Aarav-Jindal/VTVL-TVC/CAD/plumbing/Tube_Eth_Main.SLDPRT

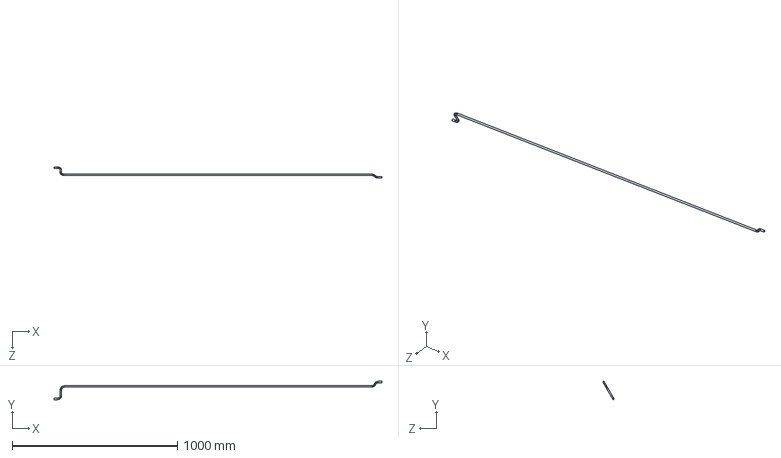
[picture p11: CAD file, 2026-11-12]
CAD/plumbing/Tube_Eth_Main.SLDPRT
1987.0 x 112.6 x 69.0 mm
