Aarav-Jindal/VTVL-TVC/CAD/avionics/Dome.SLDPRT

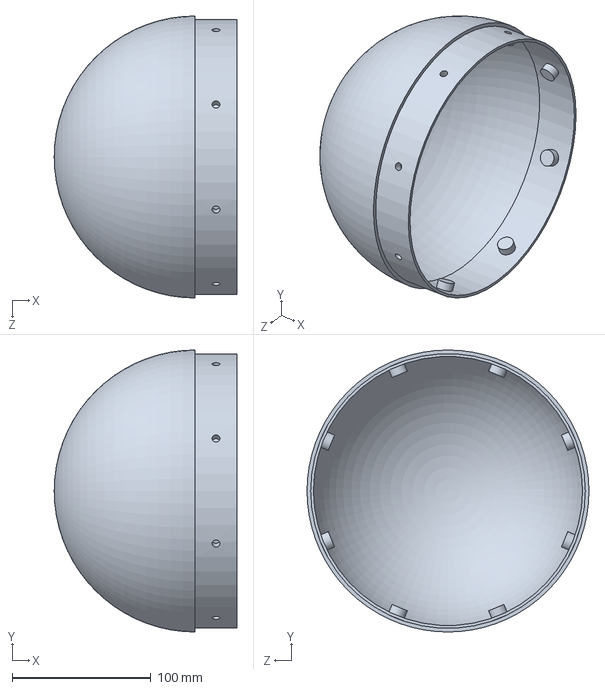
[picture p12: CAD file, 2026-11-12]
CAD/avionics/Dome.SLDPRT
131.6 x 203.3 x 203.3 mm
