Aarav-Jindal/VTVL-TVC/CAD/Injector_Body.SLDPRT

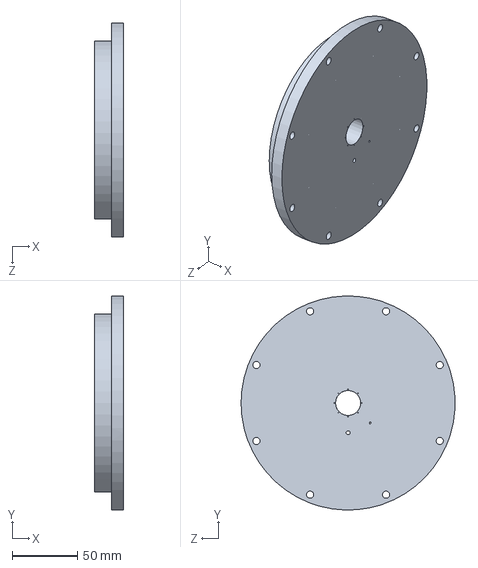
[picture p13: CAD file, 2026-11-12]
CAD/Injector_Body.SLDPRT
22.0 x 163.9 x 163.9 mm
