Aarav-Jindal/VTVL-TVC/CAD/legs/Leg_Foot.SLDPRT

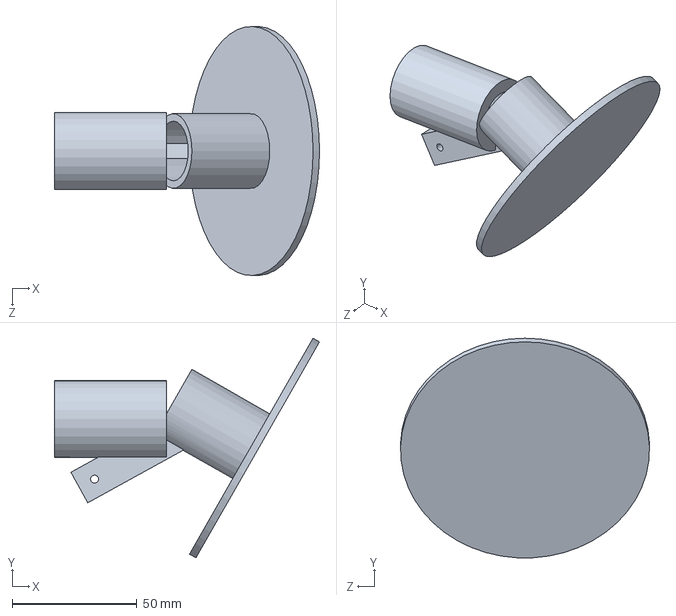
[picture p14: CAD file, 2026-11-12]
CAD/legs/Leg_Foot.SLDPRT
106.4 x 88.2 x 99.9 mm
