Aarav-Jindal/VTVL-TVC/CAD/plumbing/He_Adapter_Upper.SLDPRT

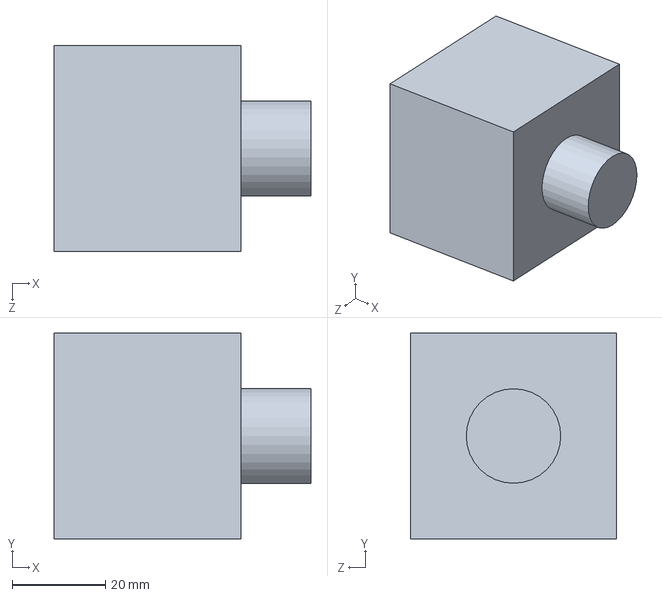
[picture p16: CAD file, 2026-11-12]
CAD/plumbing/He_Adapter_Upper.SLDPRT
55.0 x 44.0 x 44.0 mm
