Aarav-Jindal/VTVL-TVC/CAD/throttle/Servo_Throttle.SLDPRT

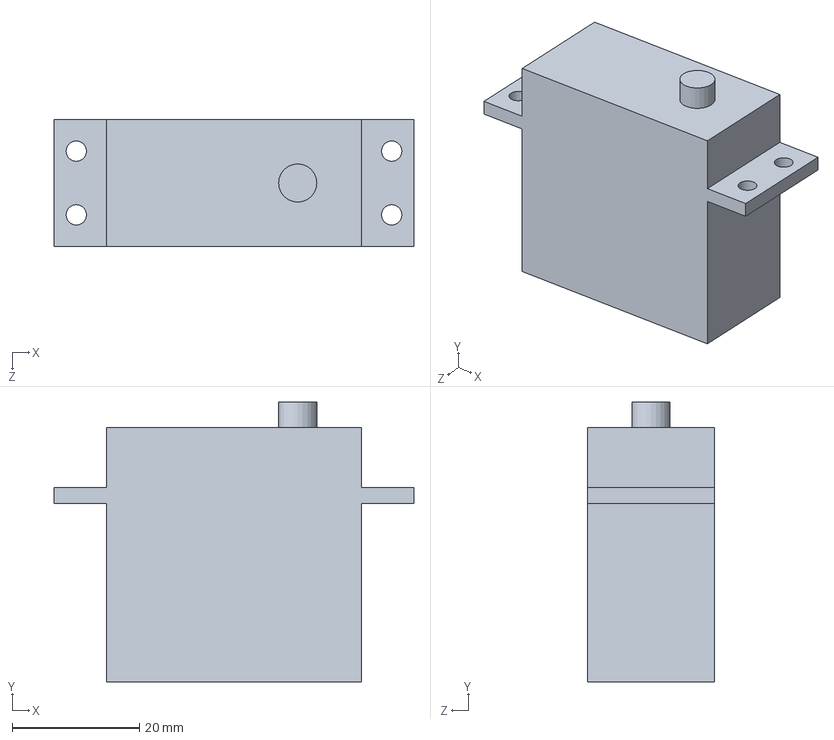
[picture p17: CAD file, 2026-11-12]
CAD/throttle/Servo_Throttle.SLDPRT
56.5 x 43.9 x 20.0 mm
