Aarav-Jindal/VTVL-TVC/CAD/torch/Tube_Torch_Eth.SLDPRT

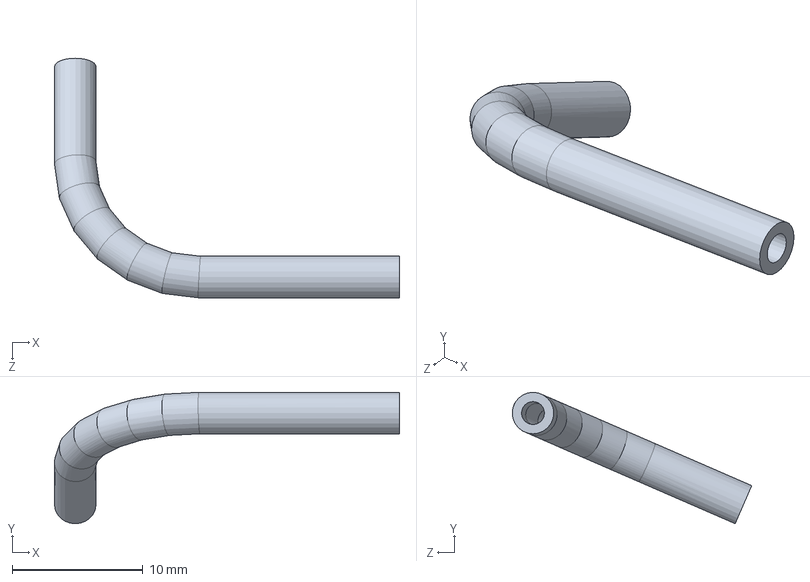
[picture p18: CAD file, 2026-11-12]
CAD/torch/Tube_Torch_Eth.SLDPRT
26.4 x 10.0 x 18.3 mm
