Aarav-Jindal/VTVL-TVC/CAD/Chamber_Printed.SLDPRT

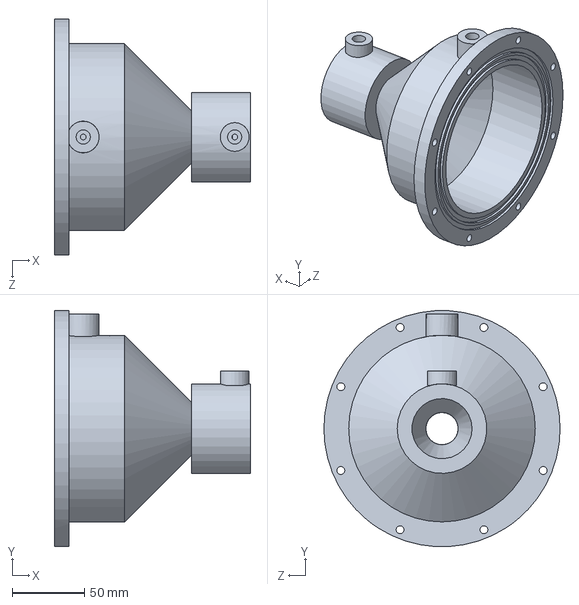
[picture p19: CAD file, 2026-11-12]
CAD/Chamber_Printed.SLDPRT
136.1 x 163.8 x 164.0 mm
