Aarav-Jindal/VTVL-TVC/CAD/legs/Leg_Switch.SLDPRT

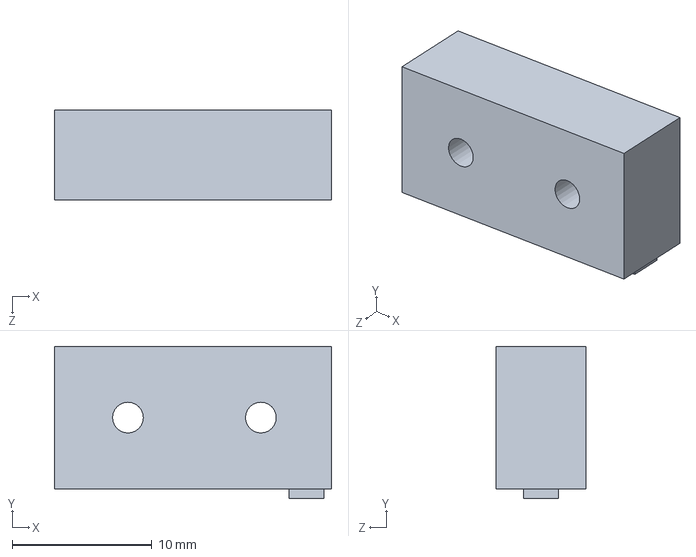
[picture p20: CAD file, 2026-11-12]
CAD/legs/Leg_Switch.SLDPRT
19.8 x 10.9 x 6.40 mm
