Aarav-Jindal/VTVL-TVC/CAD/mounts/Line_Block_T6.SLDPRT

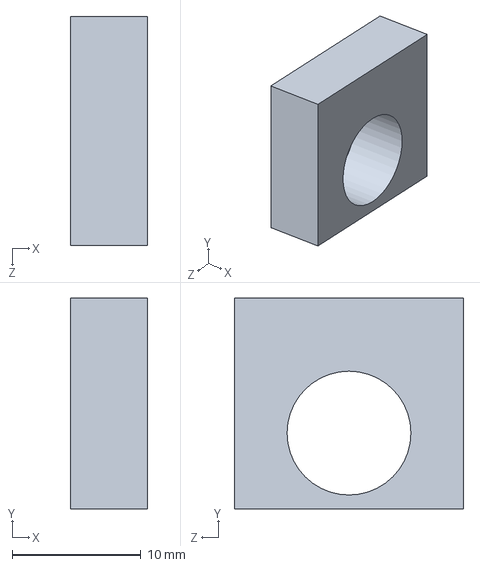
[picture p21: CAD file, 2026-11-12]
CAD/mounts/Line_Block_T6.SLDPRT
6.00 x 16.4 x 17.8 mm
