Aarav-Jindal/VTVL-TVC/CAD/plumbing/Conn_T8_ORB6.SLDPRT

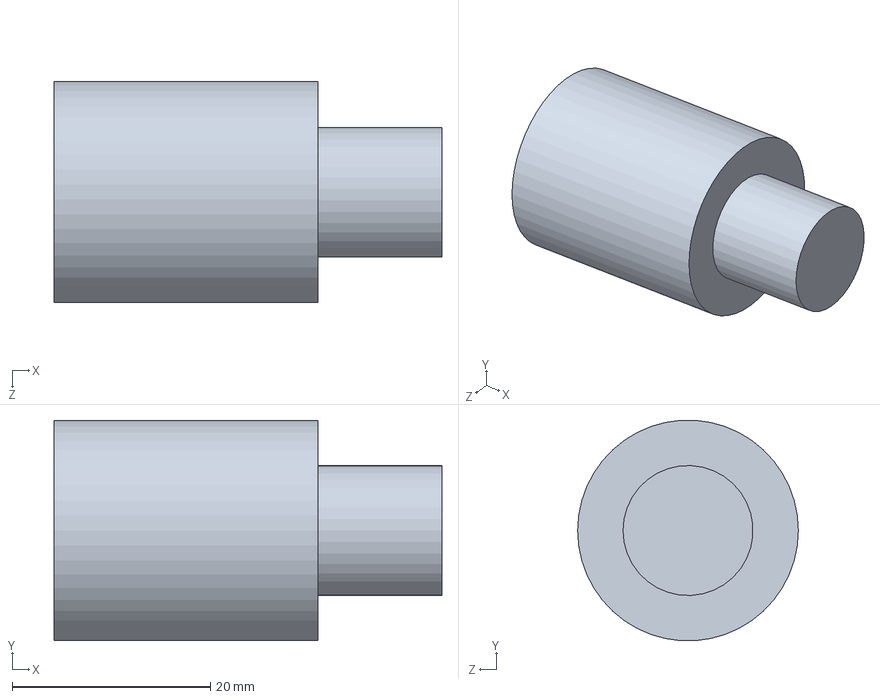
[picture p22: CAD file, 2026-11-12]
CAD/plumbing/Conn_T8_ORB6.SLDPRT
39.1 x 22.2 x 22.2 mm
