Aarav-Jindal/VTVL-TVC/CAD/throttle/Throttle_Gear_Servo.SLDPRT

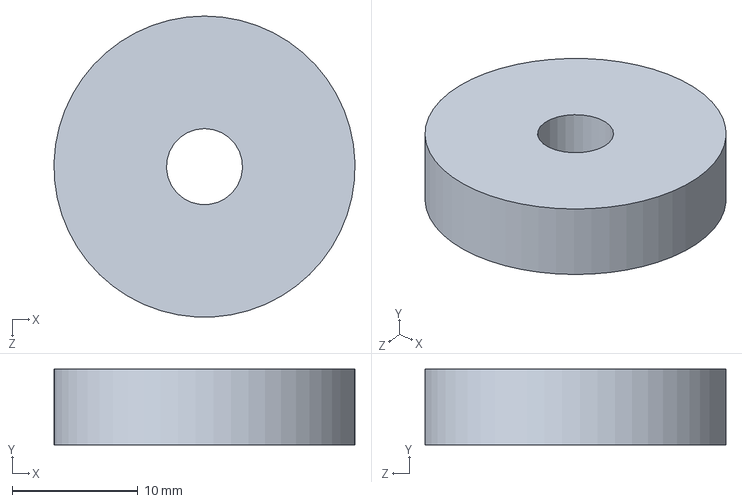
[picture p23: CAD file, 2026-11-12]
CAD/throttle/Throttle_Gear_Servo.SLDPRT
23.9 x 6.00 x 23.9 mm
