Aarav-Jindal/VTVL-TVC/CAD/torch/Torch_Plug.SLDPRT

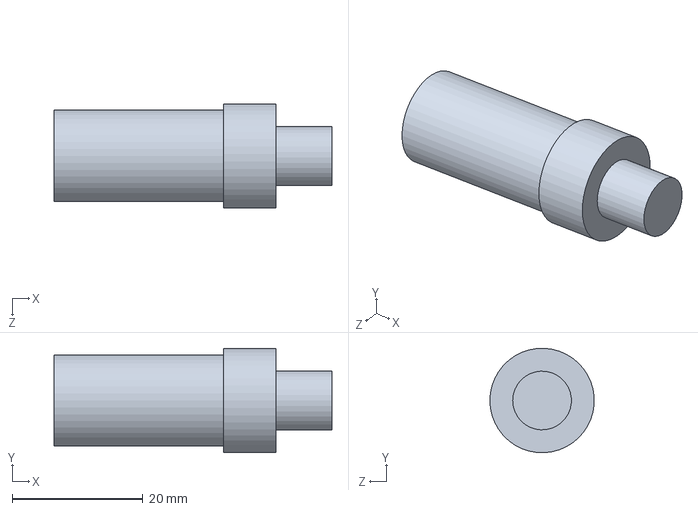
[picture p24: CAD file, 2026-11-12]
CAD/torch/Torch_Plug.SLDPRT
42.6 x 16.0 x 16.0 mm
