Aarav-Jindal/VTVL-TVC/CAD/avionics/Grommet_IMU.SLDPRT

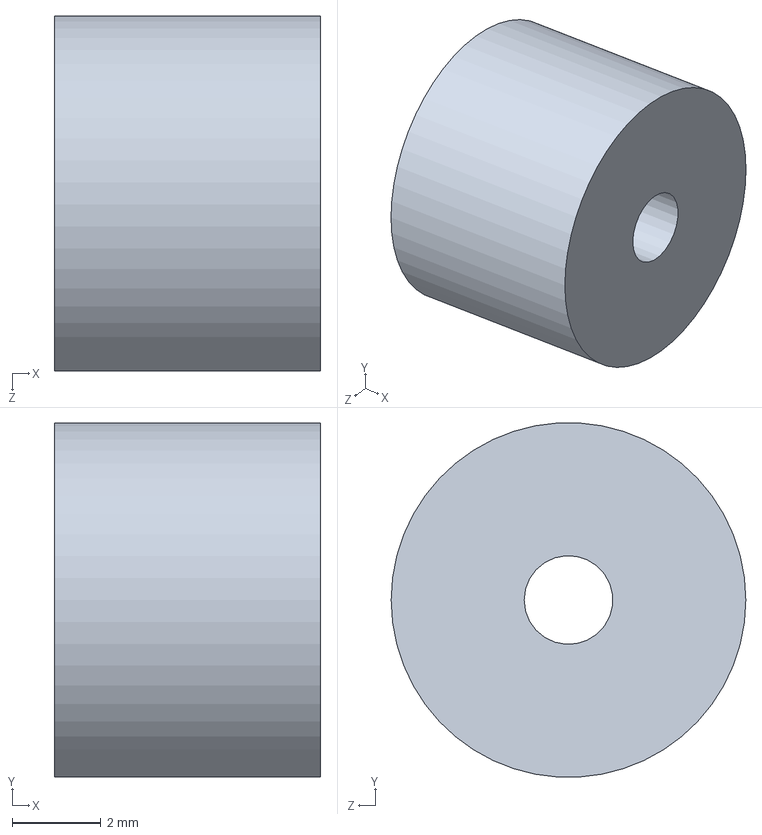
[picture p25: CAD file, 2026-11-12]
CAD/avionics/Grommet_IMU.SLDPRT
6.00 x 7.98 x 8.00 mm
