Aarav-Jindal/VTVL-TVC/CAD/Gimbal_Servo_Bracket.SLDPRT

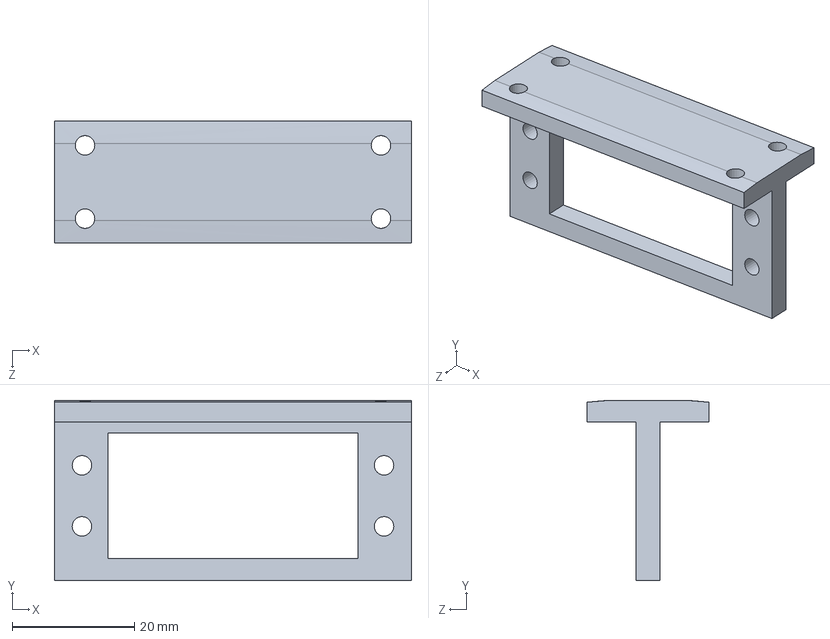
[picture p26: CAD file, 2026-11-12]
CAD/Gimbal_Servo_Bracket.SLDPRT
58.5 x 29.6 x 20.0 mm
