Aarav-Jindal/VTVL-TVC/CAD/hardware/Pushrod.SLDPRT

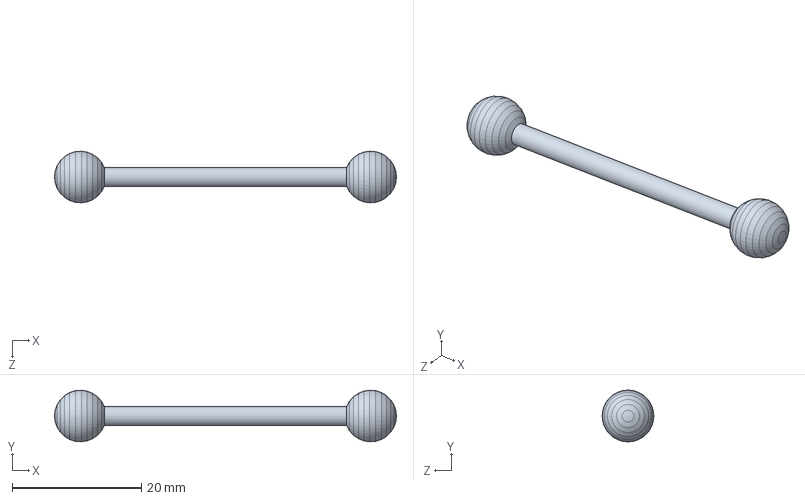
[picture p27: CAD file, 2026-11-12]
CAD/hardware/Pushrod.SLDPRT
53.0 x 7.99 x 7.99 mm
