Aarav-Jindal/VTVL-TVC/CAD/legs/Leg_Spring.SLDPRT

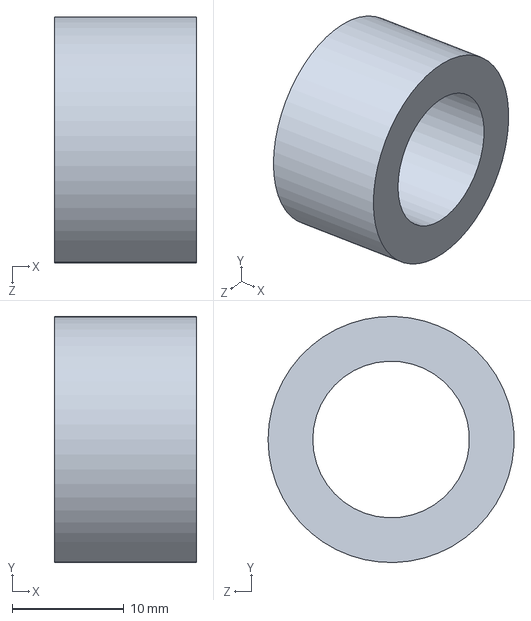
[picture p28: CAD file, 2026-11-12]
CAD/legs/Leg_Spring.SLDPRT
12.7 x 22.0 x 22.0 mm
