Aarav-Jindal/VTVL-TVC/CAD/mounts/Bottle_Liner_Seat.SLDPRT

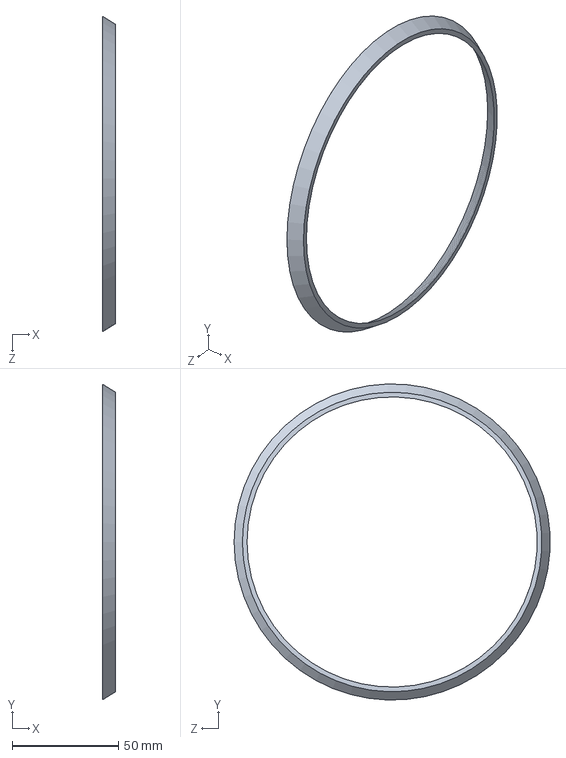
[picture p29: CAD file, 2026-11-12]
CAD/mounts/Bottle_Liner_Seat.SLDPRT
6.35 x 148.8 x 148.8 mm
