Aarav-Jindal/VTVL-TVC/CAD/plumbing/Hose_End_10.SLDPRT

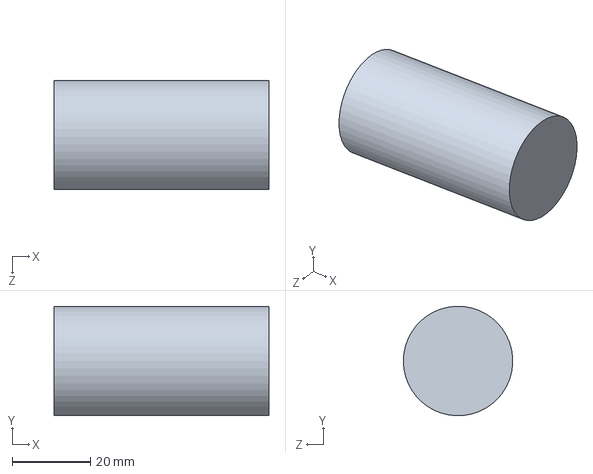
[picture p30: CAD file, 2026-11-12]
CAD/plumbing/Hose_End_10.SLDPRT
55.0 x 28.0 x 28.0 mm
