Aarav-Jindal/VTVL-TVC/CAD/throttle/Throttle_Bracket.SLDPRT

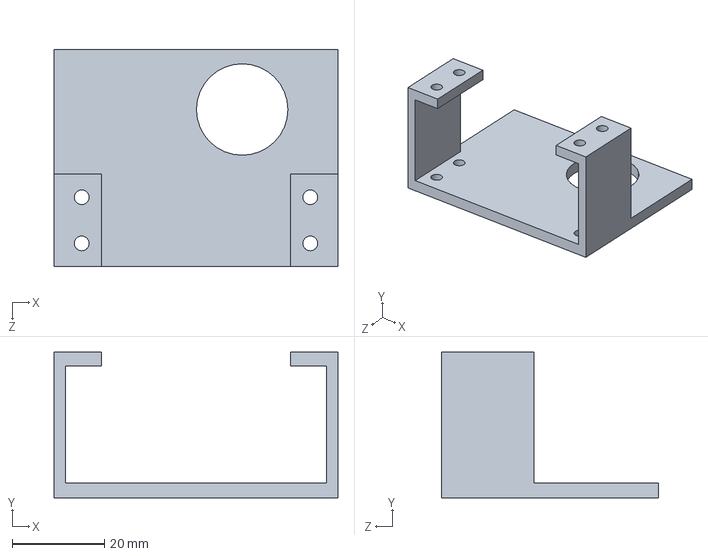
[picture p31: CAD file, 2026-11-12]
CAD/throttle/Throttle_Bracket.SLDPRT
61.5 x 31.6 x 47.0 mm
