Aarav-Jindal/VTVL-TVC/CAD/torch/Tube_Torch_N2O.SLDPRT

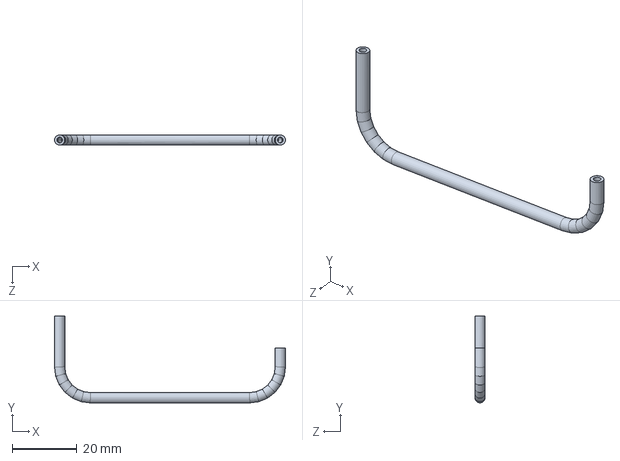
[picture p32: CAD file, 2026-11-12]
CAD/torch/Tube_Torch_N2O.SLDPRT
71.3 x 26.8 x 3.17 mm
