Aarav-Jindal/VTVL-TVC/CAD/avionics/Standoff_M3x60.SLDPRT

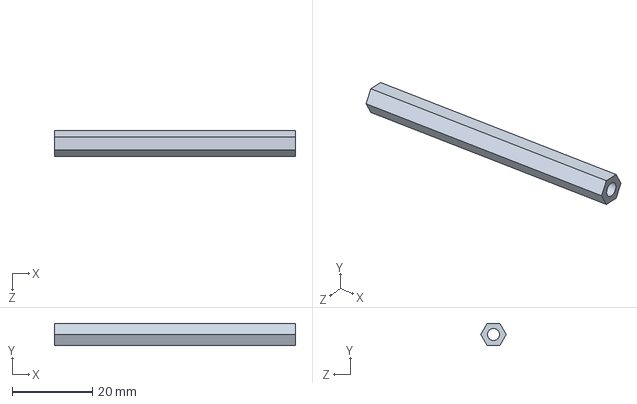
[picture p33: CAD file, 2026-11-12]
CAD/avionics/Standoff_M3x60.SLDPRT
60.0 x 5.50 x 6.35 mm
