Aarav-Jindal/VTVL-TVC/CAD/Gimbal_Ring.SLDPRT

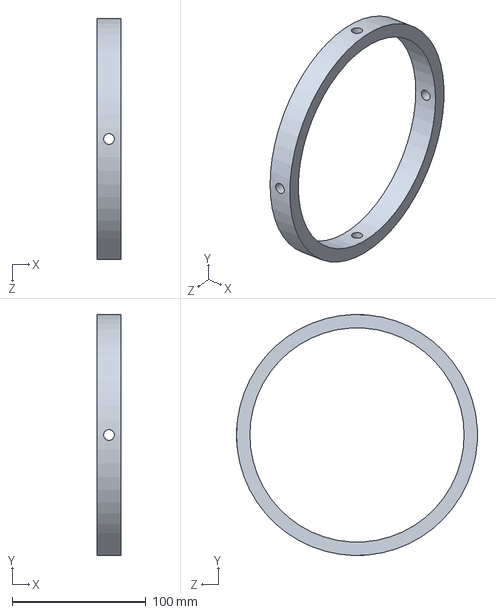
[picture p34: CAD file, 2026-11-12]
CAD/Gimbal_Ring.SLDPRT
18.0 x 180.0 x 180.0 mm
