Aarav-Jindal/VTVL-TVC/CAD/hardware/O_Ring_Outer.SLDPRT

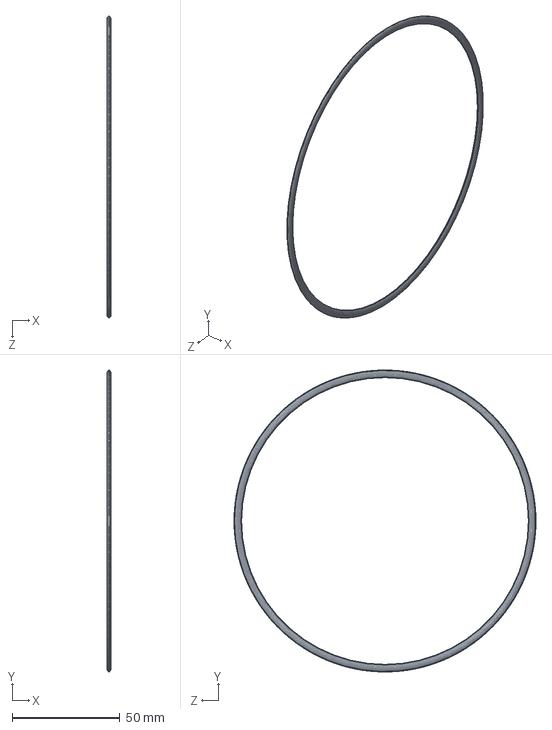
[picture p35: CAD file, 2026-11-12]
CAD/hardware/O_Ring_Outer.SLDPRT
1.95 x 140.0 x 140.1 mm
