Aarav-Jindal/VTVL-TVC/CAD/legs/Leg_Hinge_Bracket.SLDPRT

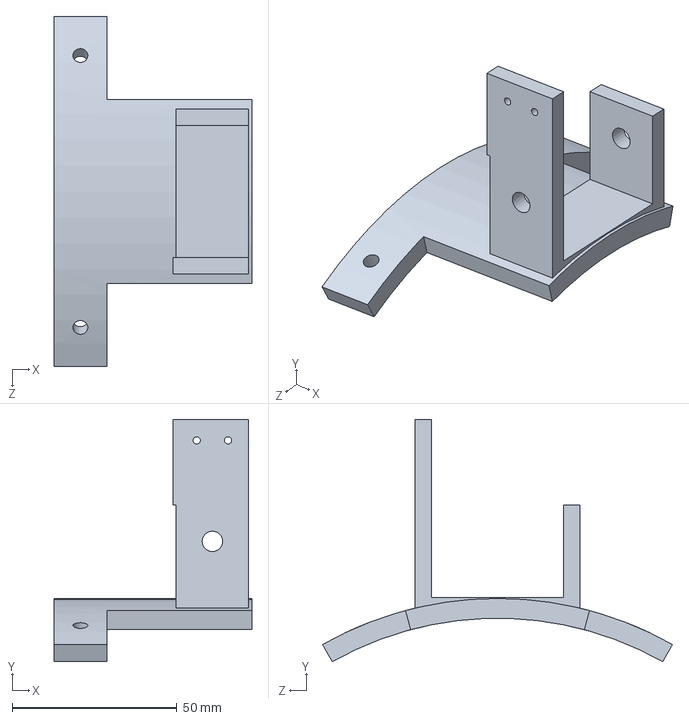
[picture p36: CAD file, 2026-11-12]
CAD/legs/Leg_Hinge_Bracket.SLDPRT
60.0 x 73.5 x 106.1 mm
