Aarav-Jindal/VTVL-TVC/CAD/mounts/Bottle_Ring.SLDPRT

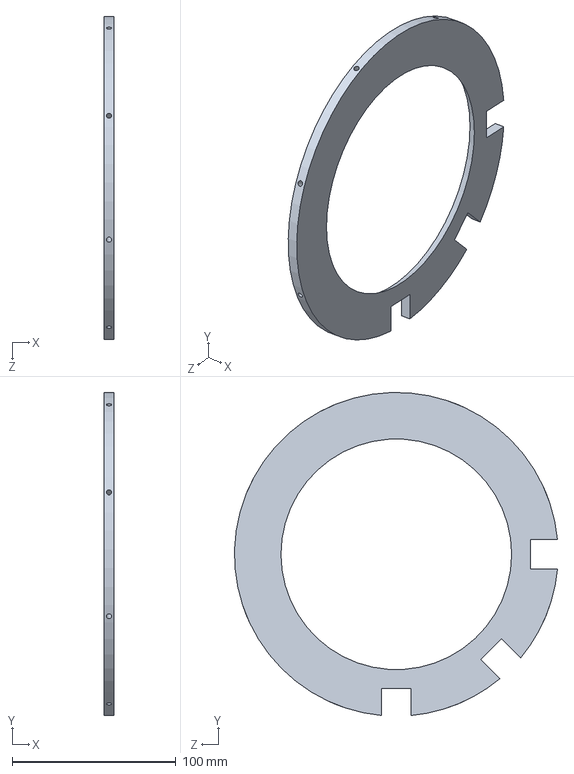
[picture p37: CAD file, 2026-11-12]
CAD/mounts/Bottle_Ring.SLDPRT
6.35 x 197.5 x 197.5 mm
