Aarav-Jindal/VTVL-TVC/CAD/plumbing/Tube_E_Drain.SLDPRT

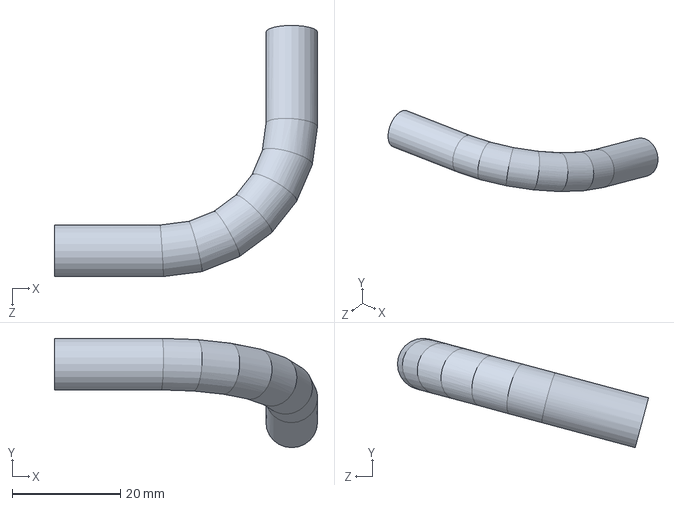
[picture p38: CAD file, 2026-11-12]
CAD/plumbing/Tube_E_Drain.SLDPRT
48.6 x 20.2 x 46.4 mm
