Aarav-Jindal/VTVL-TVC/CAD/torch/Conn_T2_ORB2.SLDPRT

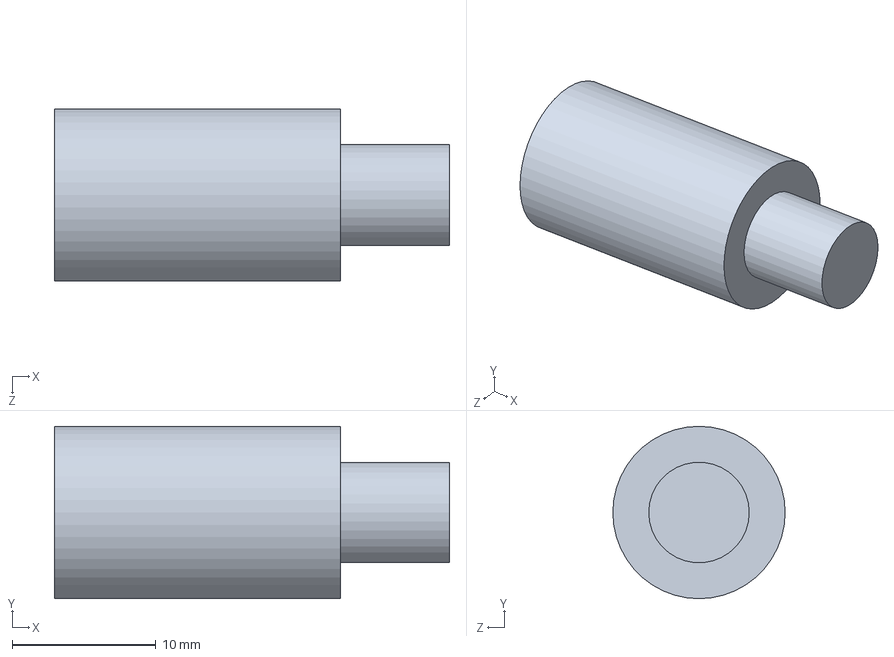
[picture p39: CAD file, 2026-11-12]
CAD/torch/Conn_T2_ORB2.SLDPRT
27.5 x 12.0 x 12.0 mm
