Aarav-Jindal/VTVL-TVC/CAD/avionics/BEC_Low.SLDPRT

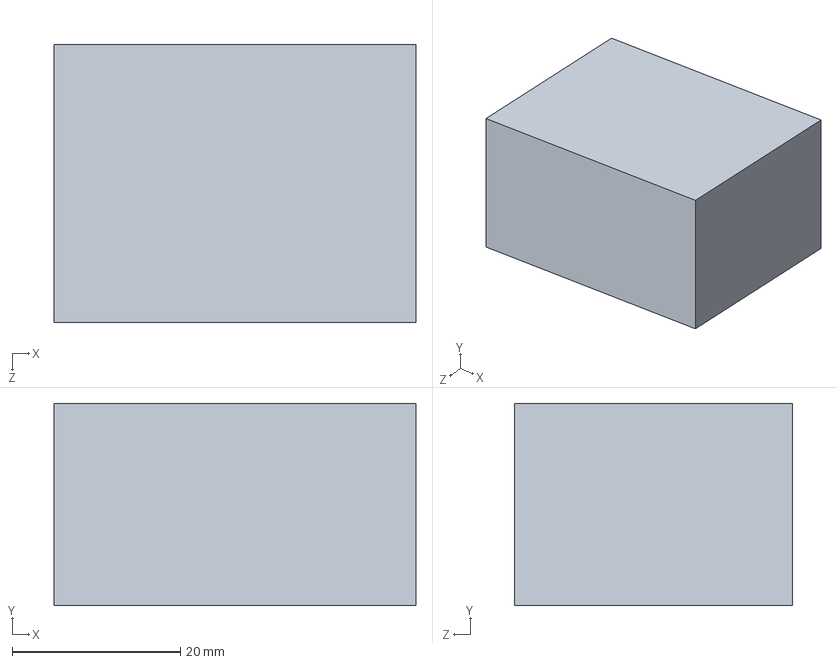
[picture p40: CAD file, 2026-11-12]
CAD/avionics/BEC_Low.SLDPRT
43.0 x 24.0 x 33.0 mm
