Aarav-Jindal/VTVL-TVC/CAD/legs/Leg_Cable.SLDPRT

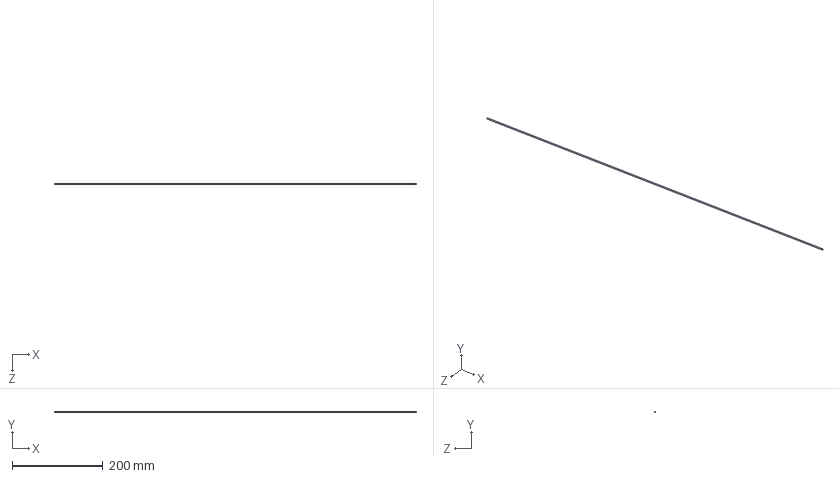
[picture p41: CAD file, 2026-11-12]
CAD/legs/Leg_Cable.SLDPRT
797.2 x 2.38 x 2.38 mm
