Aarav-Jindal/VTVL-TVC/CAD/mounts/Clip_Spacer_T6.SLDPRT

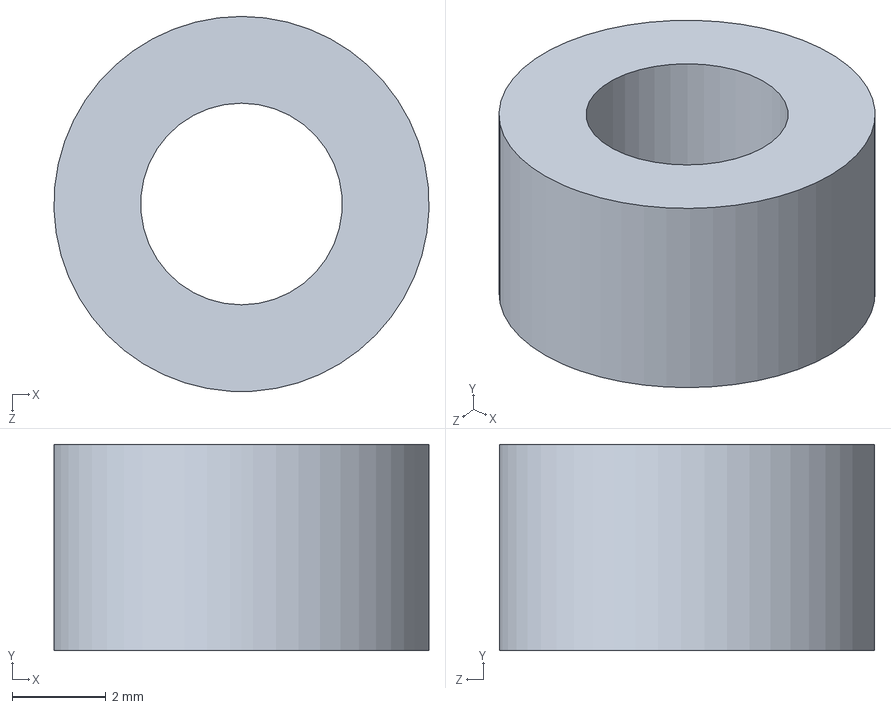
[picture p42: CAD file, 2026-11-12]
CAD/mounts/Clip_Spacer_T6.SLDPRT
8.00 x 4.40 x 8.00 mm
