Aarav-Jindal/VTVL-TVC/CAD/plumbing/He_Bottle.SLDPRT

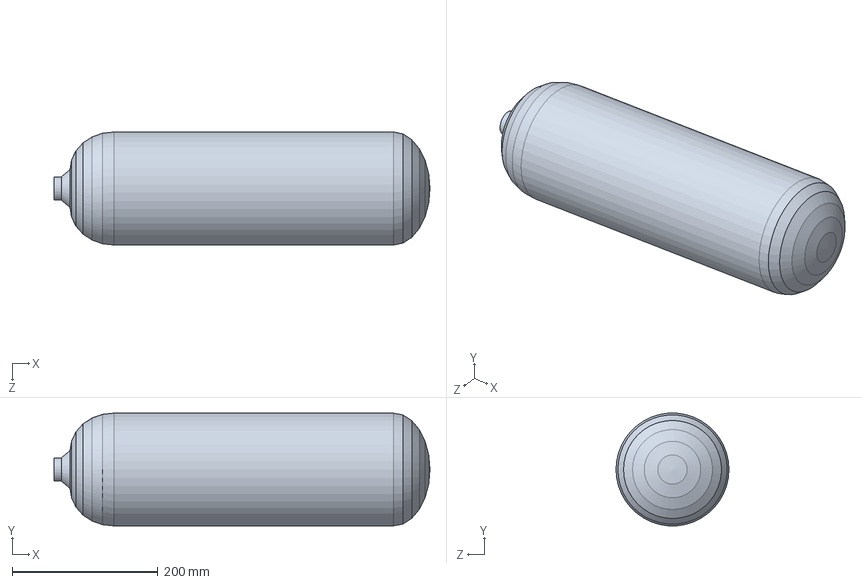
[picture p43: CAD file, 2026-11-12]
CAD/plumbing/He_Bottle.SLDPRT
515.6 x 154.6 x 155.0 mm
