Aarav-Jindal/VTVL-TVC/CAD/torch/Torch_Body.SLDPRT

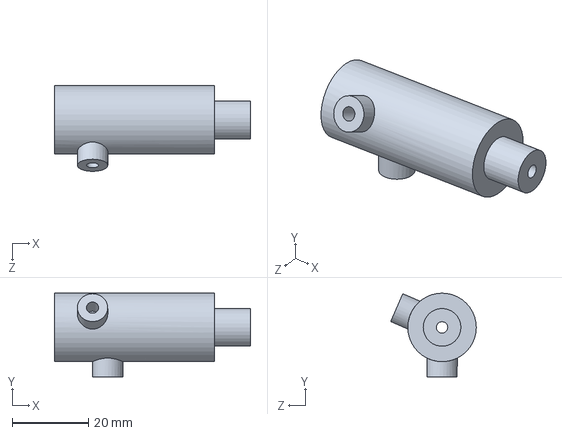
[picture p44: CAD file, 2026-11-12]
CAD/torch/Torch_Body.SLDPRT
51.5 x 22.0 x 22.5 mm
