Aarav-Jindal/VTVL-TVC/CAD/avionics/Standoff_M3x30.SLDPRT

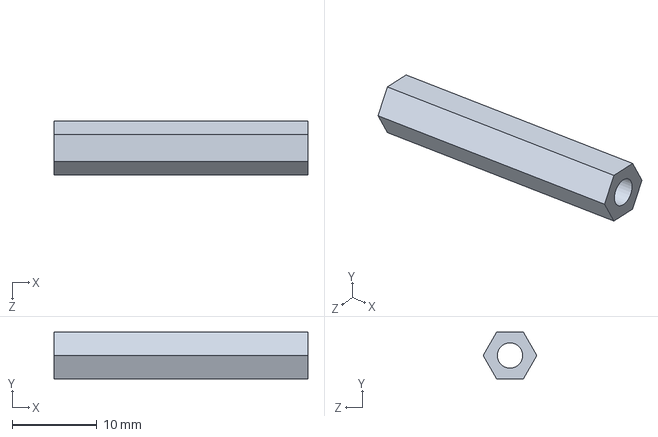
[picture p45: CAD file, 2026-11-12]
CAD/avionics/Standoff_M3x30.SLDPRT
30.0 x 5.50 x 6.35 mm
