Aarav-Jindal/VTVL-TVC/CAD/hardware/Pin_Outer.SLDPRT

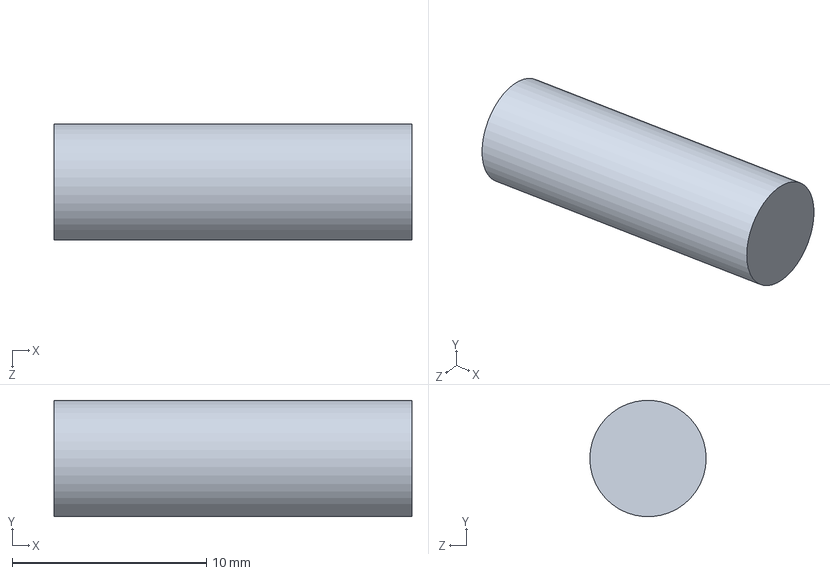
[picture p46: CAD file, 2026-11-12]
CAD/hardware/Pin_Outer.SLDPRT
18.4 x 5.98 x 6.00 mm
