Aarav-Jindal/VTVL-TVC/CAD/legs/Leg_Stop_Plug.SLDPRT

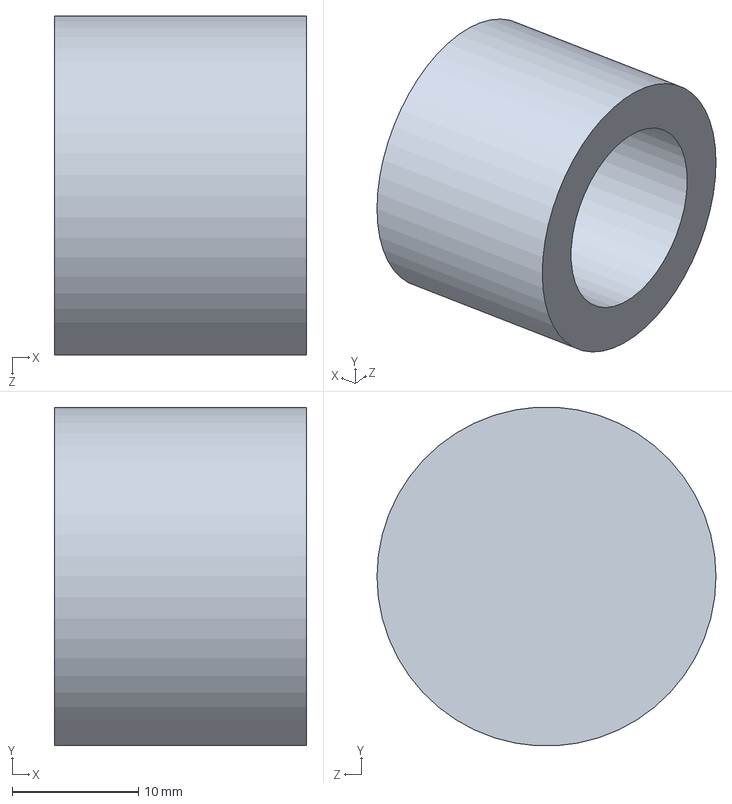
[picture p47: CAD file, 2026-11-12]
CAD/legs/Leg_Stop_Plug.SLDPRT
20.0 x 26.8 x 26.9 mm
