Aarav-Jindal/VTVL-TVC/CAD/mounts/Clip_Spacer_T4.SLDPRT

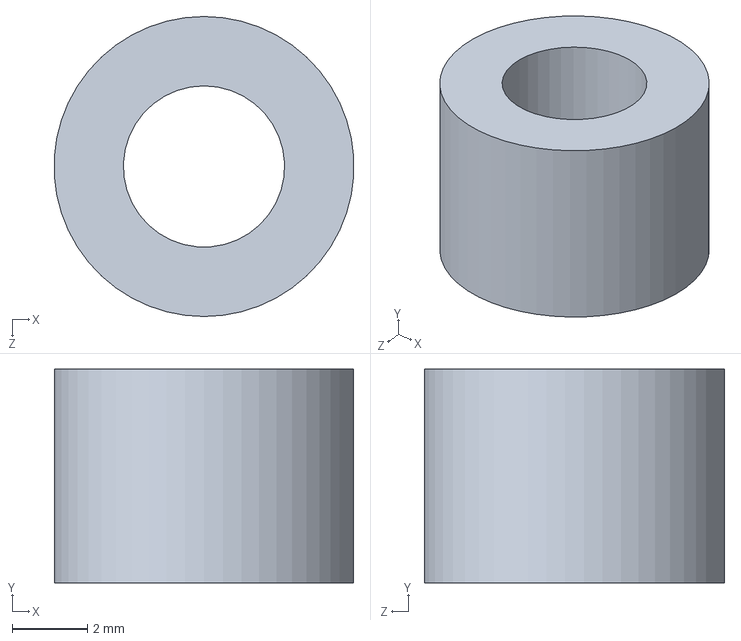
[picture p48: CAD file, 2026-11-12]
CAD/mounts/Clip_Spacer_T4.SLDPRT
7.98 x 5.70 x 8.00 mm
