Aarav-Jindal/VTVL-TVC/CAD/Pintle.SLDPRT

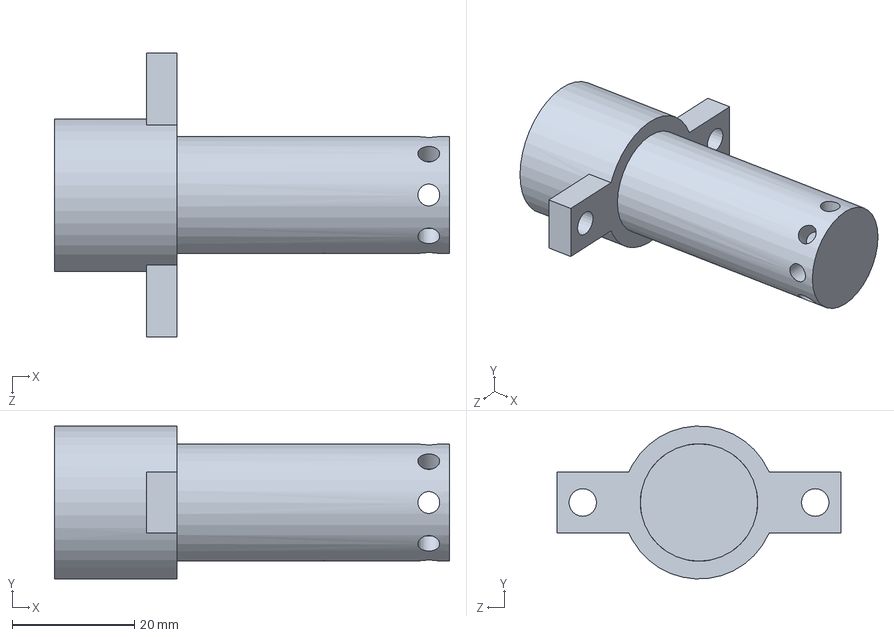
[picture p49: CAD file, 2026-11-12]
CAD/Pintle.SLDPRT
64.6 x 25.0 x 46.5 mm
