Aarav-Jindal/VTVL-TVC/CAD/plumbing/Fill_Nipple.SLDPRT

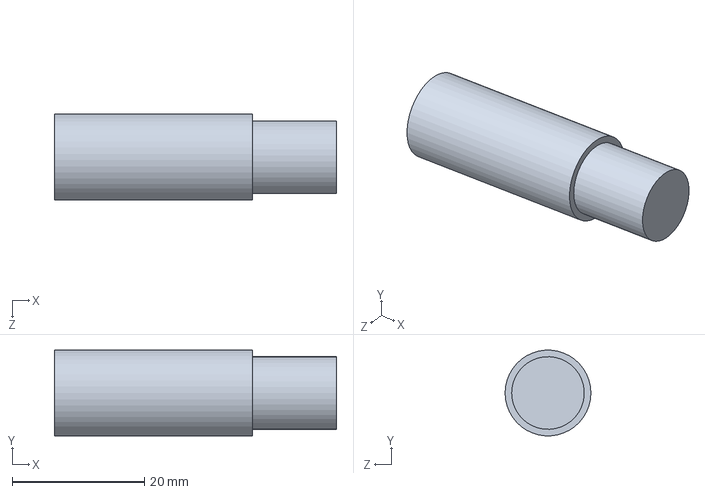
[picture p50: CAD file, 2026-11-12]
CAD/plumbing/Fill_Nipple.SLDPRT
42.7 x 13.0 x 13.0 mm
