Aarav-Jindal/VTVL-TVC/CAD/torch/Tube_PT8.SLDPRT

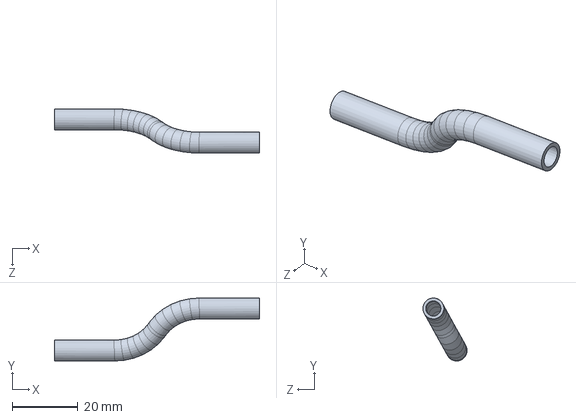
[picture p51: CAD file, 2026-11-12]
CAD/torch/Tube_PT8.SLDPRT
62.1 x 19.1 x 13.4 mm
