Aarav-Jindal/VTVL-TVC/CAD/avionics/BEC_Plate.SLDPRT

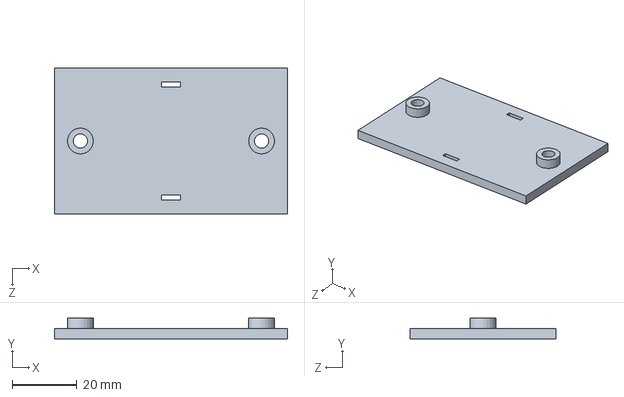
[picture p52: CAD file, 2026-11-12]
CAD/avionics/BEC_Plate.SLDPRT
72.0 x 6.48 x 45.0 mm
