Aarav-Jindal/VTVL-TVC/CAD/Gimbal_Arm.SLDPRT

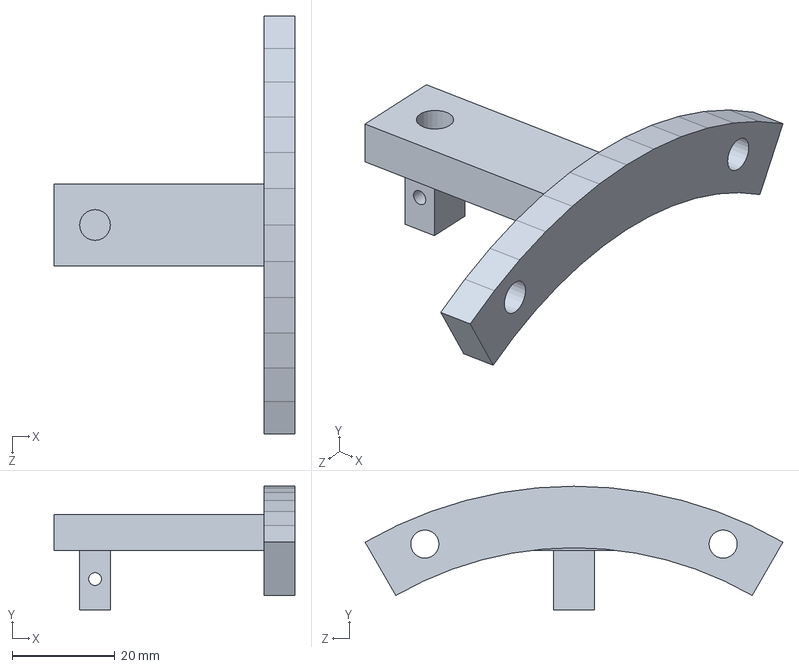
[picture p53: CAD file, 2026-11-12]
CAD/Gimbal_Arm.SLDPRT
47.0 x 24.1 x 81.5 mm
