Aarav-Jindal/VTVL-TVC/CAD/legs/Leg_Sheath_247.SLDPRT

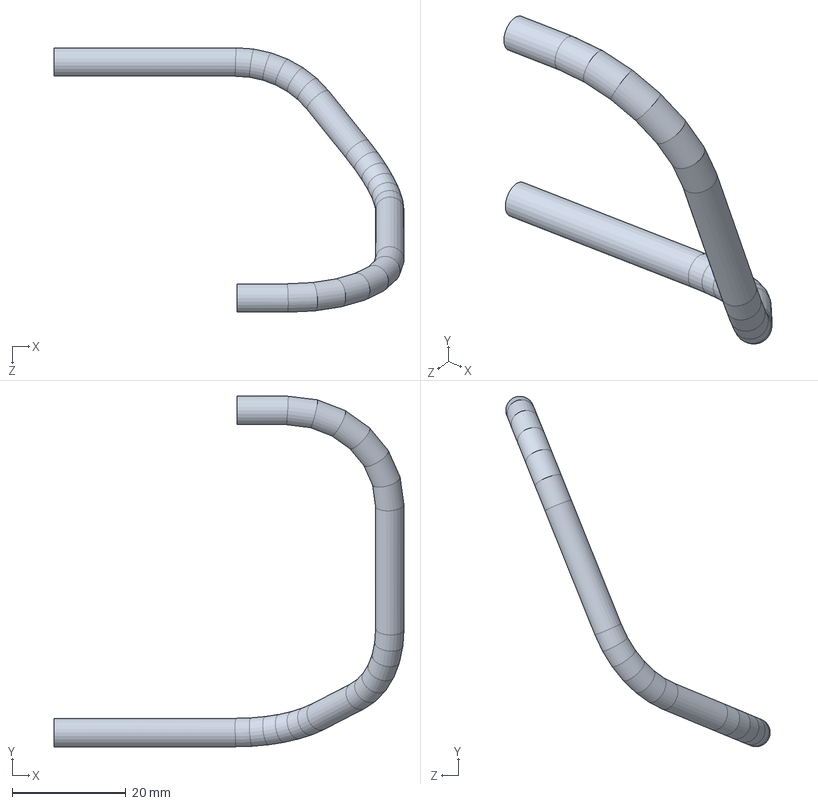
[picture p54: CAD file, 2026-11-12]
CAD/legs/Leg_Sheath_247.SLDPRT
61.5 x 61.6 x 46.5 mm
