Aarav-Jindal/VTVL-TVC/CAD/mounts/Clip_T6.SLDPRT

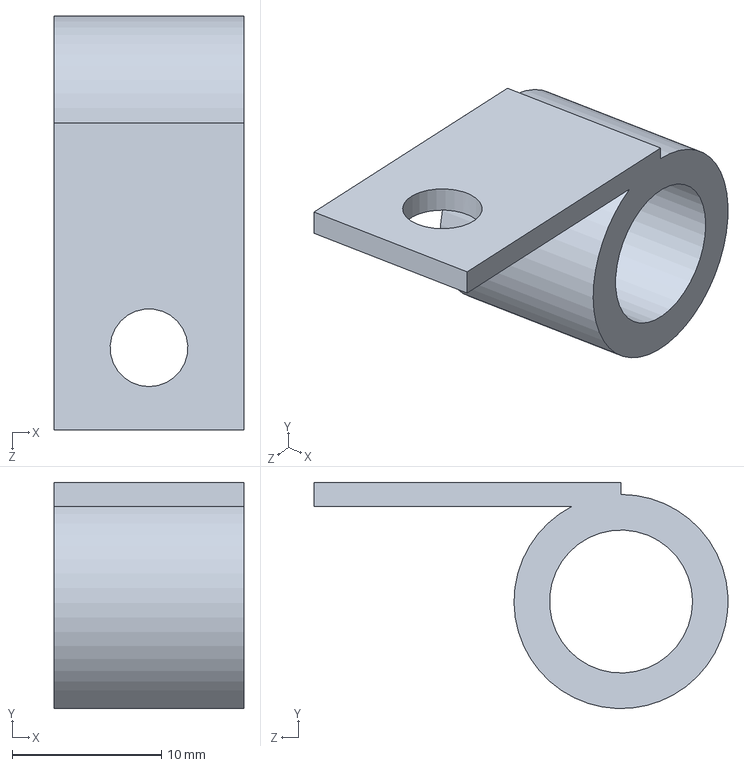
[picture p55: CAD file, 2026-11-12]
CAD/mounts/Clip_T6.SLDPRT
12.7 x 15.1 x 27.7 mm
