Aarav-Jindal/VTVL-TVC/CAD/plumbing/Tube_T8_Stub.SLDPRT

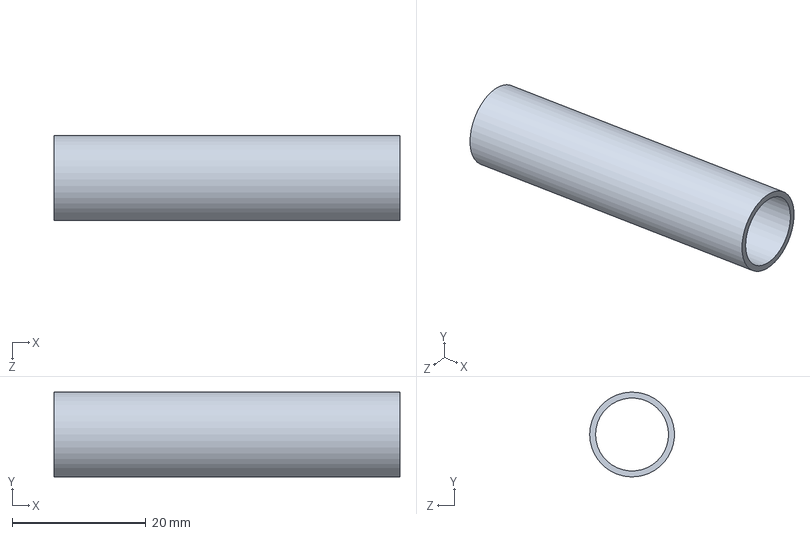
[picture p56: CAD file, 2026-11-12]
CAD/plumbing/Tube_T8_Stub.SLDPRT
51.8 x 12.7 x 12.7 mm
