Aarav-Jindal/VTVL-TVC/CAD/avionics/Bay_PCB.SLDPRT

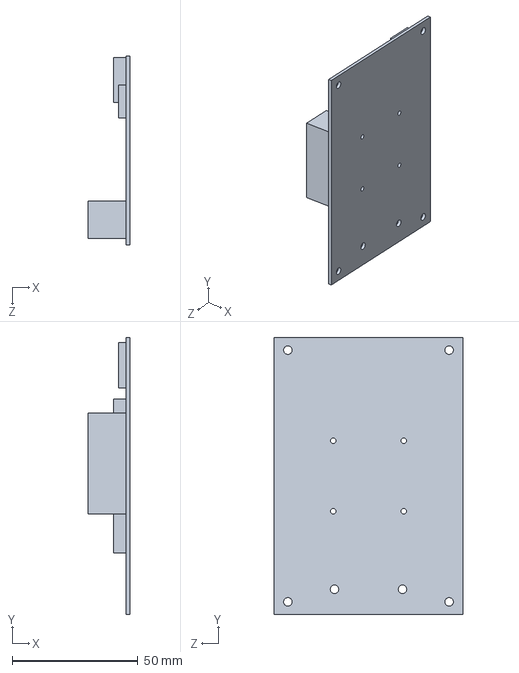
[picture p57: CAD file, 2026-11-12]
CAD/avionics/Bay_PCB.SLDPRT
16.6 x 110.0 x 75.0 mm
