Aarav-Jindal/VTVL-TVC/CAD/Gimbal_Mount.SLDPRT

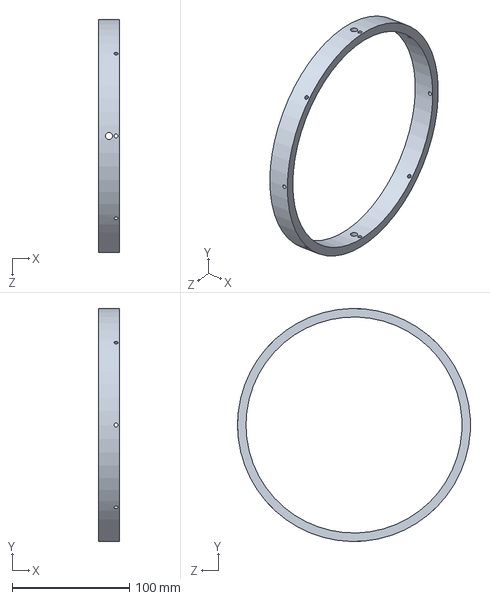
[picture p58: CAD file, 2026-11-12]
CAD/Gimbal_Mount.SLDPRT
18.0 x 198.5 x 198.5 mm
