Aarav-Jindal/VTVL-TVC/CAD/legs/Leg_Low_Lug.SLDPRT

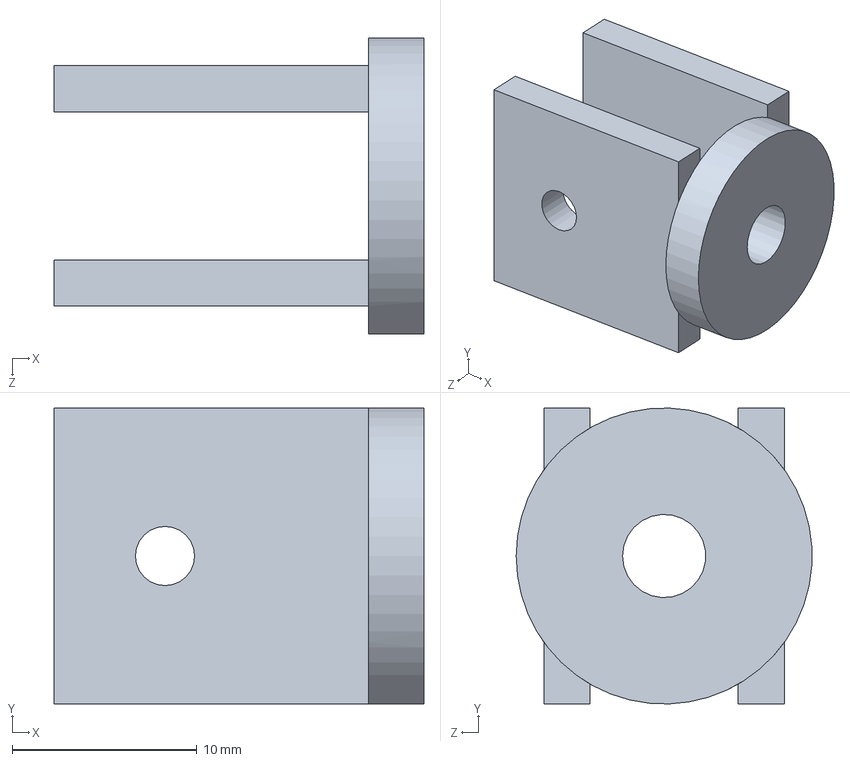
[picture p59: CAD file, 2026-11-12]
CAD/legs/Leg_Low_Lug.SLDPRT
20.0 x 16.0 x 16.0 mm
