Aarav-Jindal/VTVL-TVC/CAD/mounts/Clip_T4.SLDPRT

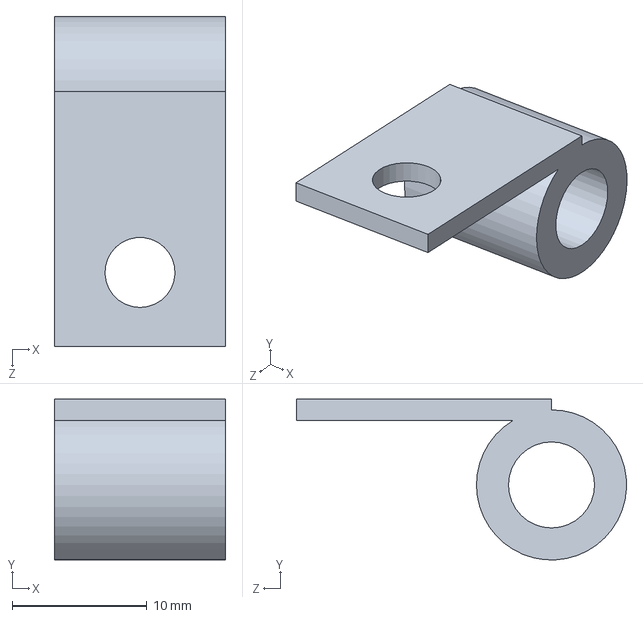
[picture p60: CAD file, 2026-11-12]
CAD/mounts/Clip_T4.SLDPRT
12.7 x 11.9 x 24.5 mm
