Aarav-Jindal/VTVL-TVC/CAD/plumbing/Conn_T6_ORB4.SLDPRT

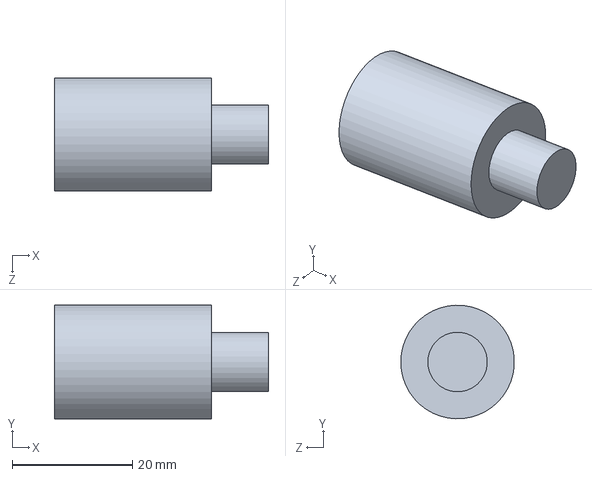
[picture p61: CAD file, 2026-11-12]
CAD/plumbing/Conn_T6_ORB4.SLDPRT
35.6 x 18.9 x 18.9 mm
