Aarav-Jindal/VTVL-TVC/CAD/avionics/Bay_Ring.SLDPRT

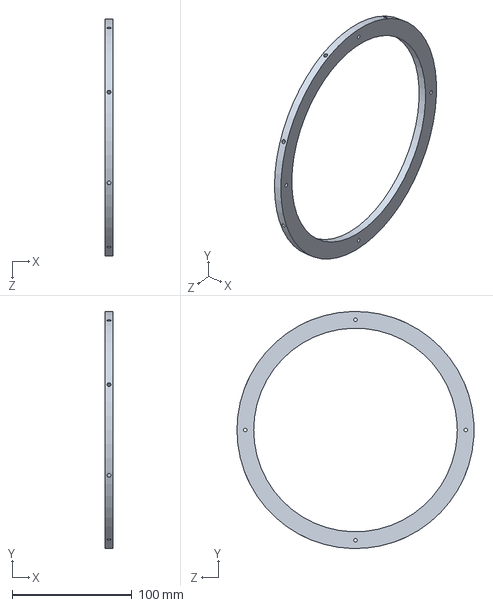
[picture p62: CAD file, 2026-11-12]
CAD/avionics/Bay_Ring.SLDPRT
6.35 x 197.9 x 198.0 mm
