Aarav-Jindal/VTVL-TVC/CAD/hardware/O_Ring_Inner.SLDPRT

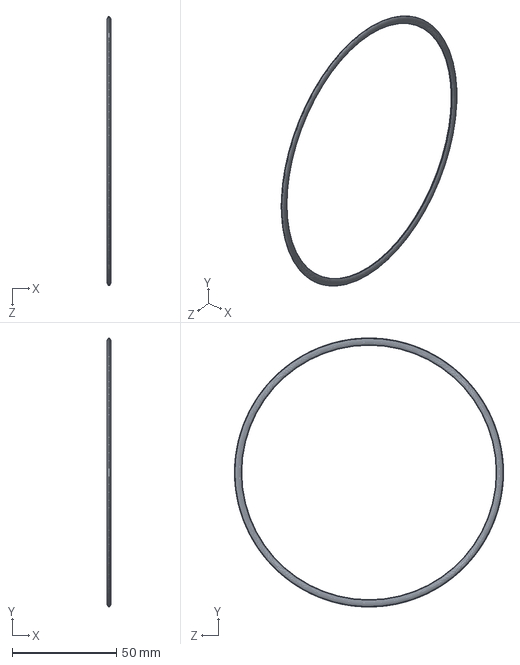
[picture p63: CAD file, 2026-11-12]
CAD/hardware/O_Ring_Inner.SLDPRT
1.95 x 129.0 x 129.1 mm
