Aarav-Jindal/VTVL-TVC/CAD/legs/Leg_Cartridge.SLDPRT

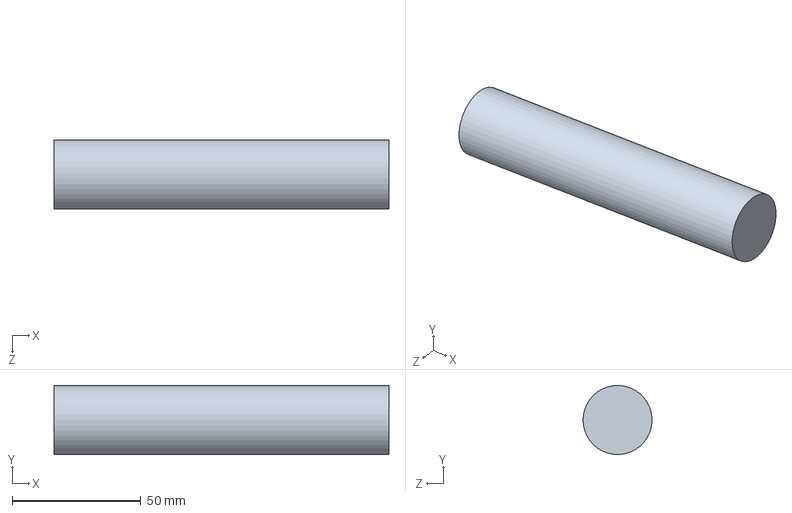
[picture p64: CAD file, 2026-11-12]
CAD/legs/Leg_Cartridge.SLDPRT
130.0 x 26.8 x 26.8 mm
