Aarav-Jindal/VTVL-TVC/CAD/mounts/Bottle_Liner_Top.SLDPRT

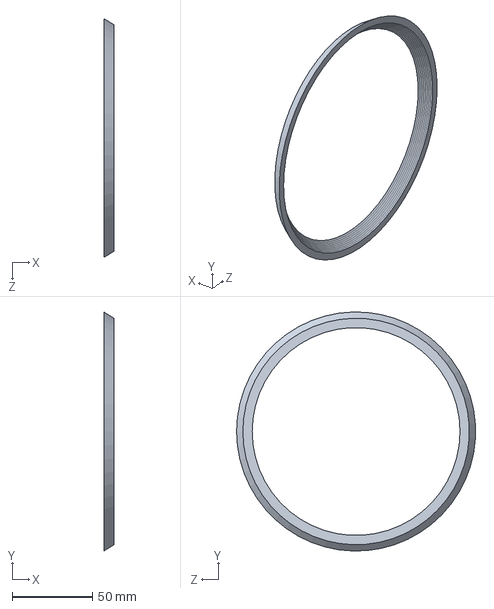
[picture p65: CAD file, 2026-11-12]
CAD/mounts/Bottle_Liner_Top.SLDPRT
6.35 x 148.8 x 148.8 mm
