Aarav-Jindal/VTVL-TVC/CAD/plumbing/Tube_T6_Stub.SLDPRT

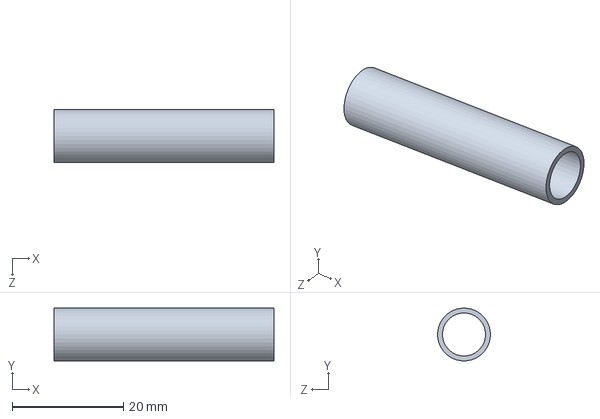
[picture p66: CAD file, 2026-11-12]
CAD/plumbing/Tube_T6_Stub.SLDPRT
39.6 x 9.53 x 9.53 mm
