Aarav-Jindal/VTVL-TVC/CAD/avionics/Strap_Servo.SLDPRT

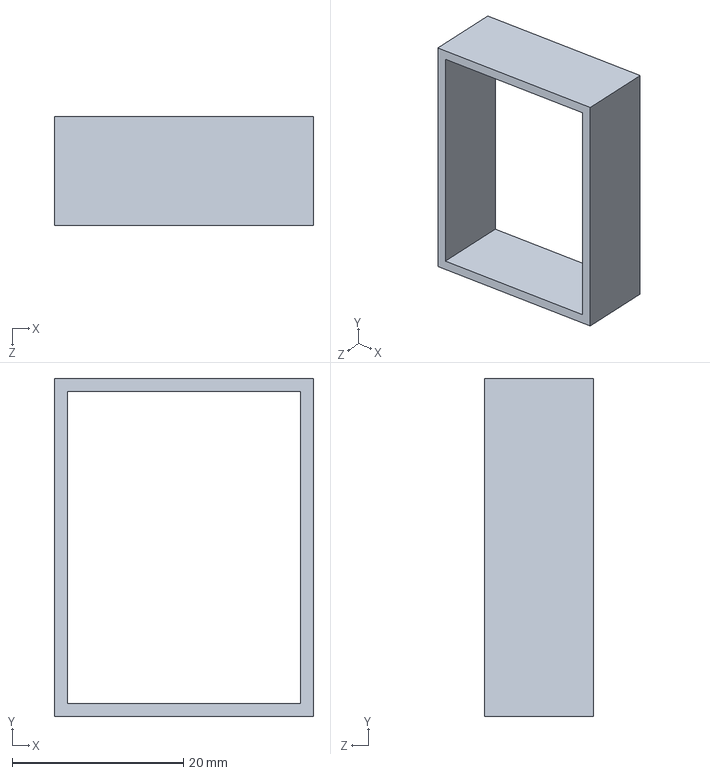
[picture p67: CAD file, 2026-11-12]
CAD/avionics/Strap_Servo.SLDPRT
30.3 x 39.5 x 12.7 mm
