Aarav-Jindal/VTVL-TVC/CAD/legs/Leg_Tube.SLDPRT

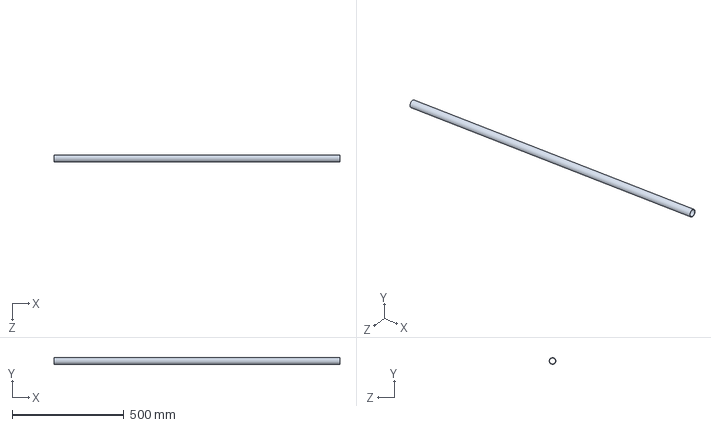
[picture p68: CAD file, 2026-11-12]
CAD/legs/Leg_Tube.SLDPRT
1280.0 x 29.9 x 29.9 mm
