Aarav-Jindal/VTVL-TVC/CAD/plumbing/Filter_F1.SLDPRT

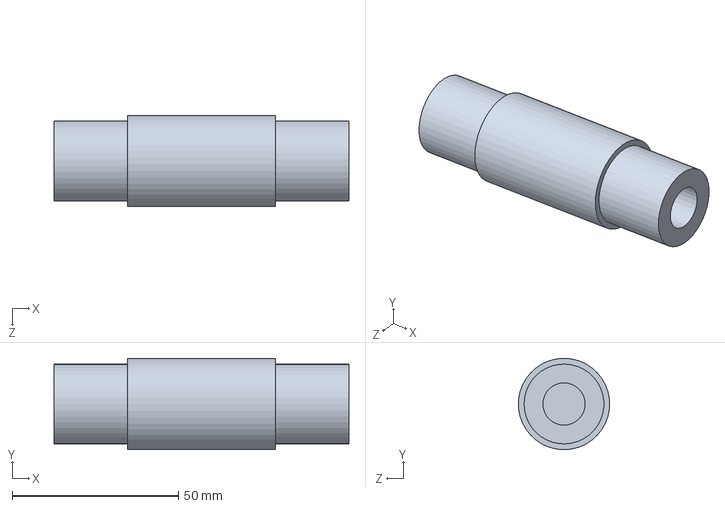
[picture p69: CAD file, 2026-11-12]
CAD/plumbing/Filter_F1.SLDPRT
88.6 x 27.4 x 27.4 mm
