Aarav-Jindal/VTVL-TVC/CAD/avionics/Spark_Plate.SLDPRT

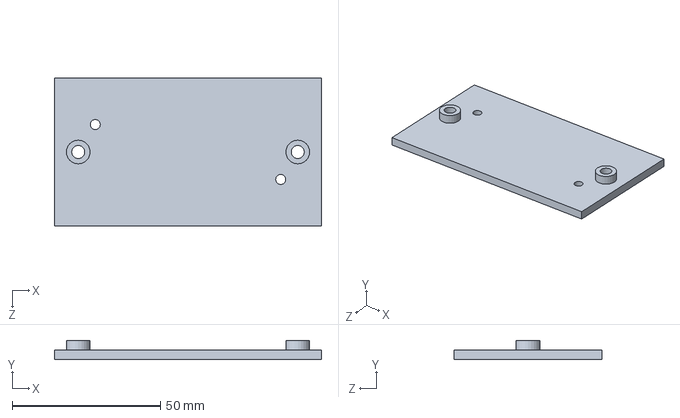
[picture p70: CAD file, 2026-11-12]
CAD/avionics/Spark_Plate.SLDPRT
90.0 x 6.48 x 50.0 mm
