Aarav-Jindal/VTVL-TVC/CAD/Chamber_plus_Nozzle_Volumetric.SLDPRT

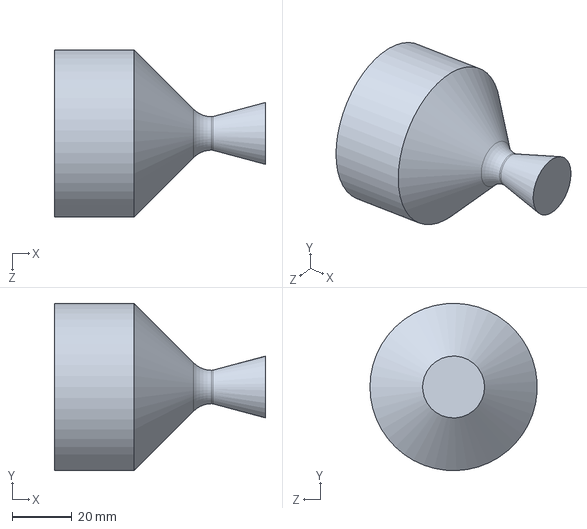
[picture p71: CAD file, 2026-11-12]
CAD/Chamber_plus_Nozzle_Volumetric.SLDPRT
70.8 x 56.1 x 56.1 mm
