Aarav-Jindal/VTVL-TVC/CAD/legs/Leg_Sheath_337.SLDPRT

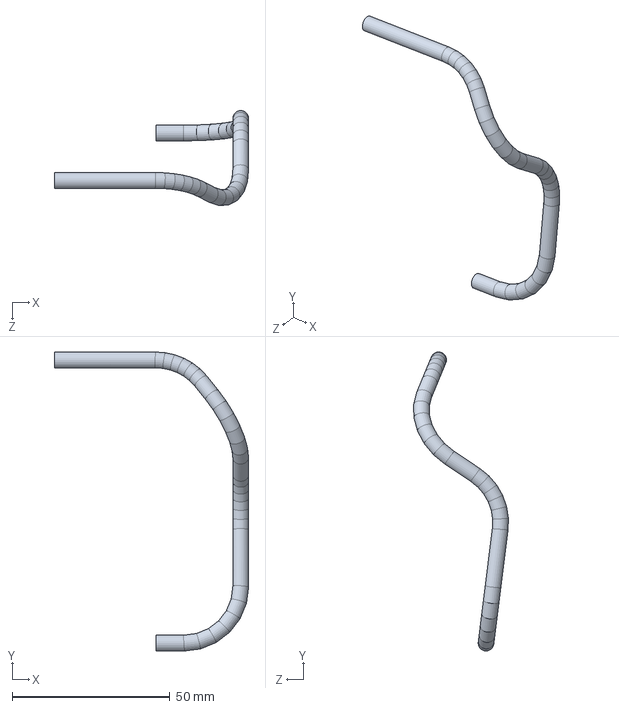
[picture p72: CAD file, 2026-11-12]
CAD/legs/Leg_Sheath_337.SLDPRT
61.5 x 94.7 x 30.0 mm
