Aarav-Jindal/VTVL-TVC/CAD/plumbing/Conn_T2_ORB4_Bored.SLDPRT

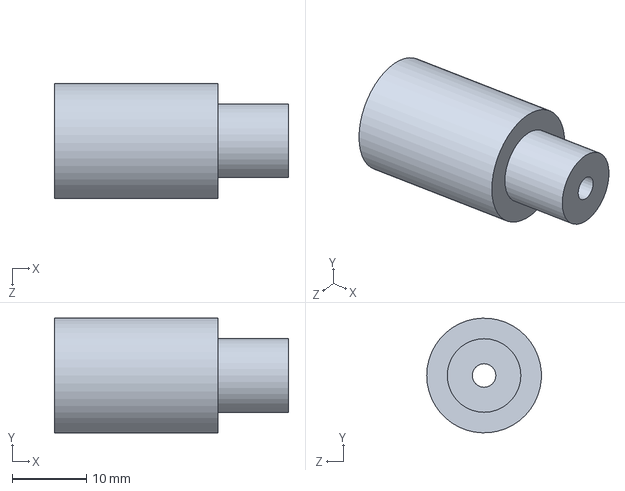
[picture p73: CAD file, 2026-11-12]
CAD/plumbing/Conn_T2_ORB4_Bored.SLDPRT
31.5 x 15.4 x 15.4 mm
