Aarav-Jindal/VTVL-TVC/CAD/avionics/Switch_FT40.SLDPRT

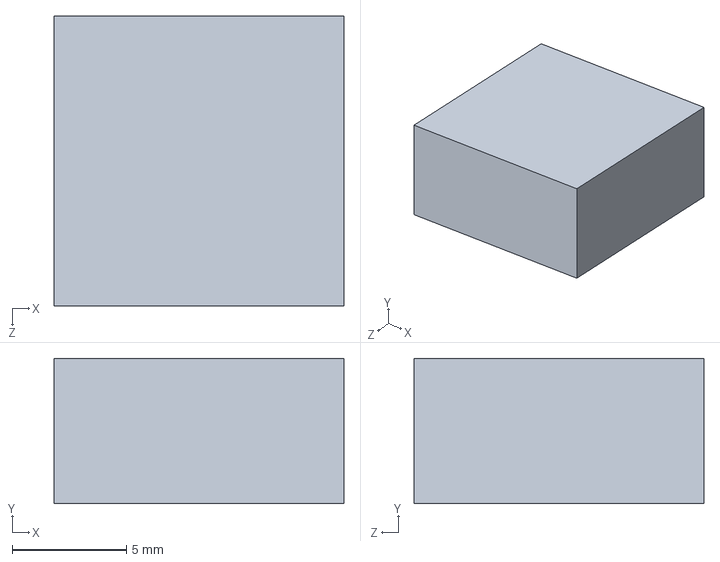
[picture p74: CAD file, 2026-11-12]
CAD/avionics/Switch_FT40.SLDPRT
12.7 x 6.35 x 12.7 mm
