Aarav-Jindal/VTVL-TVC/CAD/legs/Leg_Sheath_67.SLDPRT

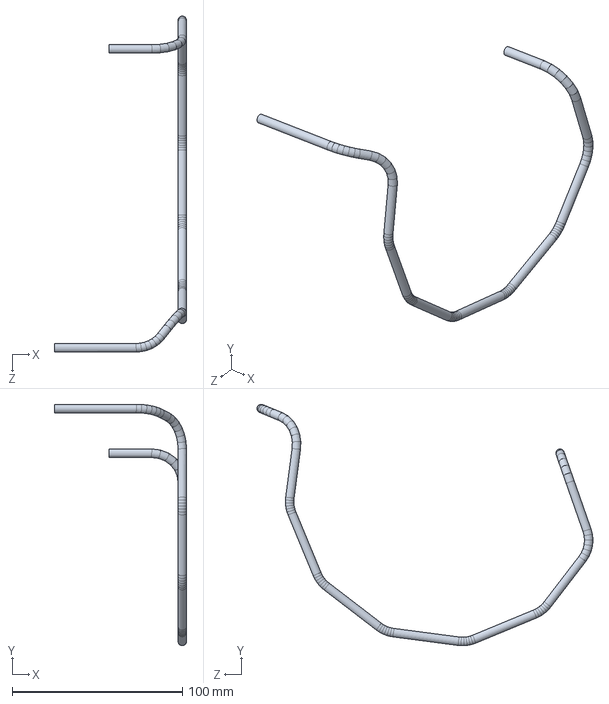
[picture p75: CAD file, 2026-11-12]
CAD/legs/Leg_Sheath_67.SLDPRT
77.5 x 141.6 x 197.1 mm
