Aarav-Jindal/VTVL-TVC/CAD/plumbing/CV_Nuvair.SLDPRT

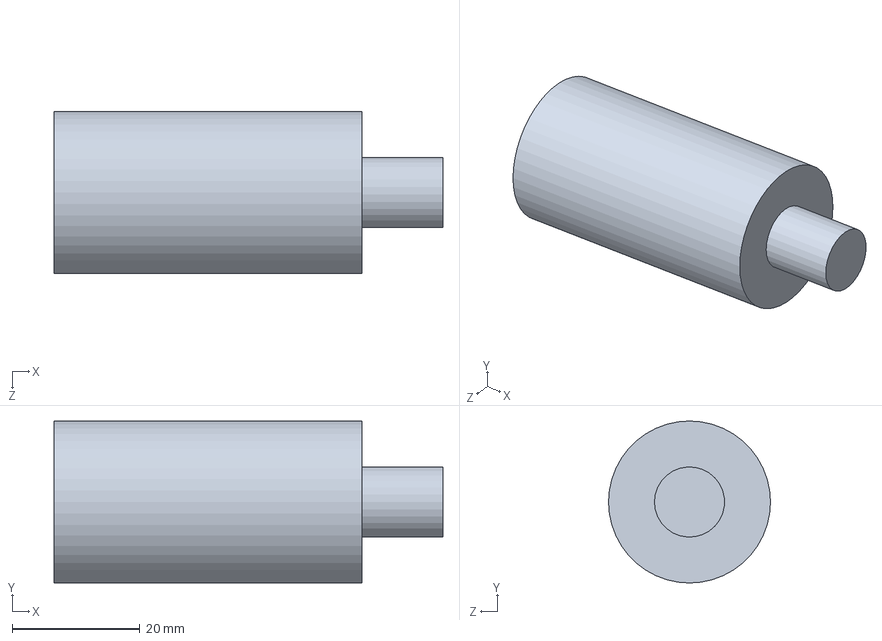
[picture p76: CAD file, 2026-11-12]
CAD/plumbing/CV_Nuvair.SLDPRT
61.0 x 25.4 x 25.4 mm
