Aarav-Jindal/VTVL-TVC/CAD/hardware/Body_Tube.SLDPRT

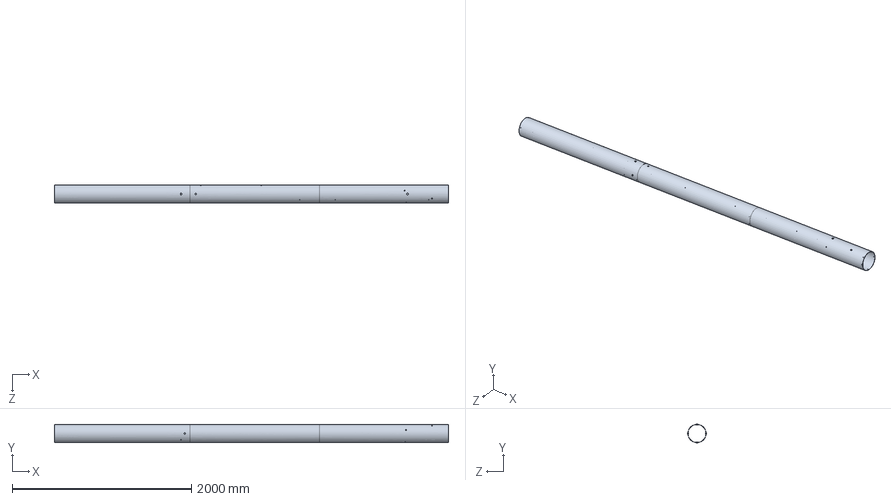
[picture p77: CAD file, 2026-11-12]
CAD/hardware/Body_Tube.SLDPRT
4390.8 x 203.3 x 203.3 mm
