Aarav-Jindal/VTVL-TVC/CAD/legs/Leg_Latch.SLDPRT

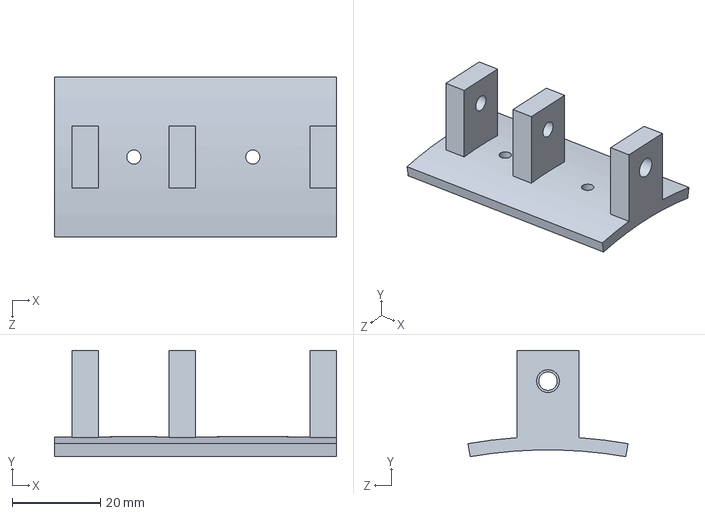
[picture p78: CAD file, 2026-11-12]
CAD/legs/Leg_Latch.SLDPRT
64.0 x 24.1 x 36.4 mm
