Aarav-Jindal/VTVL-TVC/CAD/plumbing/Tank_O_Ring.SLDPRT

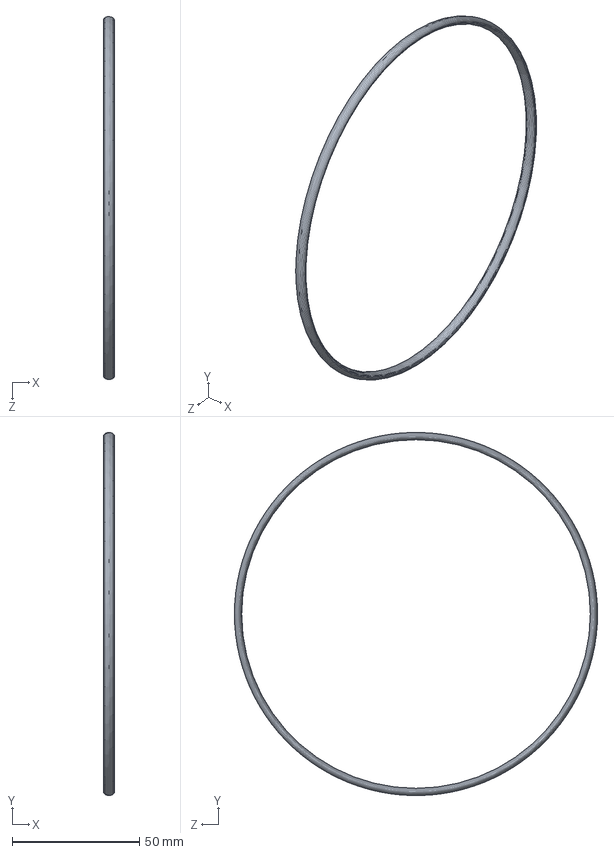
[picture p79: CAD file, 2026-11-12]
CAD/plumbing/Tank_O_Ring.SLDPRT
4.36 x 142.8 x 142.8 mm
