Aarav-Jindal/VTVL-TVC/CAD/avionics/Radio_RFD900x.SLDPRT

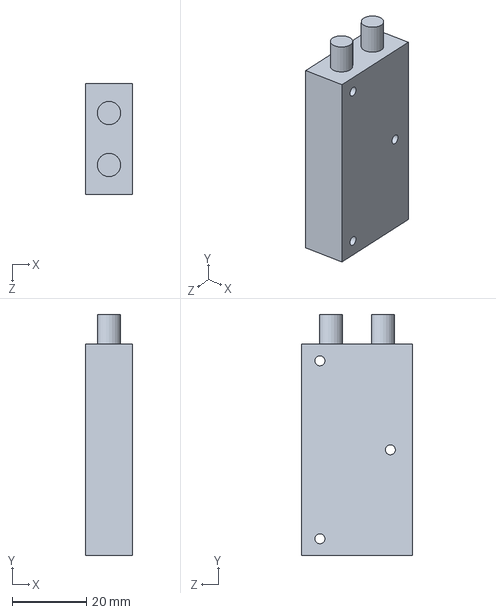
[picture p80: CAD file, 2026-11-12]
CAD/avionics/Radio_RFD900x.SLDPRT
12.8 x 65.0 x 30.0 mm
