Aarav-Jindal/VTVL-TVC/CAD/legs/Leg_Sheath_Stop.SLDPRT

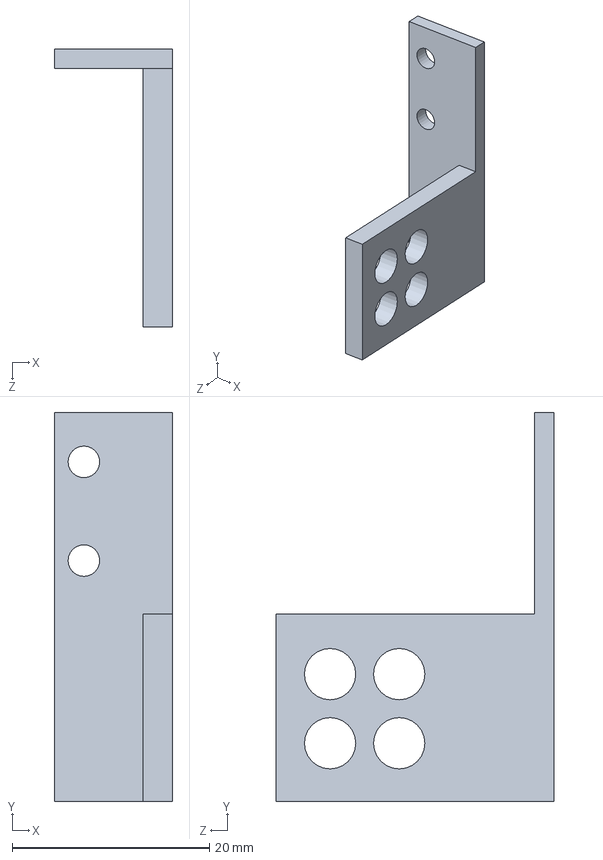
[picture p81: CAD file, 2026-11-12]
CAD/legs/Leg_Sheath_Stop.SLDPRT
12.0 x 39.4 x 28.2 mm
