Aarav-Jindal/VTVL-TVC/CAD/plumbing/Filter_F2_T6.SLDPRT

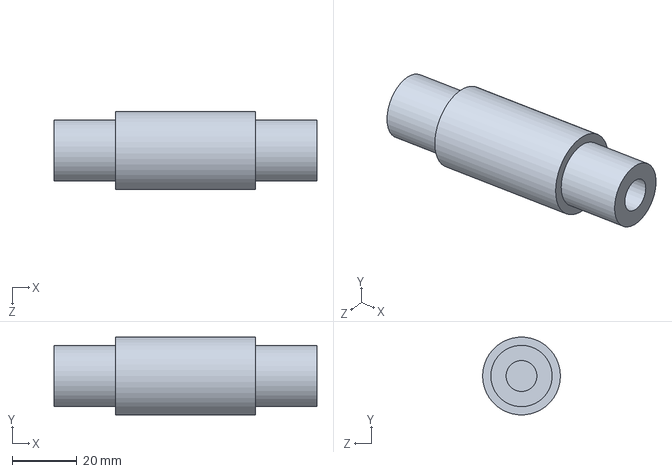
[picture p82: CAD file, 2026-11-12]
CAD/plumbing/Filter_F2_T6.SLDPRT
81.0 x 23.9 x 24.0 mm
