Aarav-Jindal/VTVL-TVC/CAD/avionics/Antenna_Lean.SLDPRT

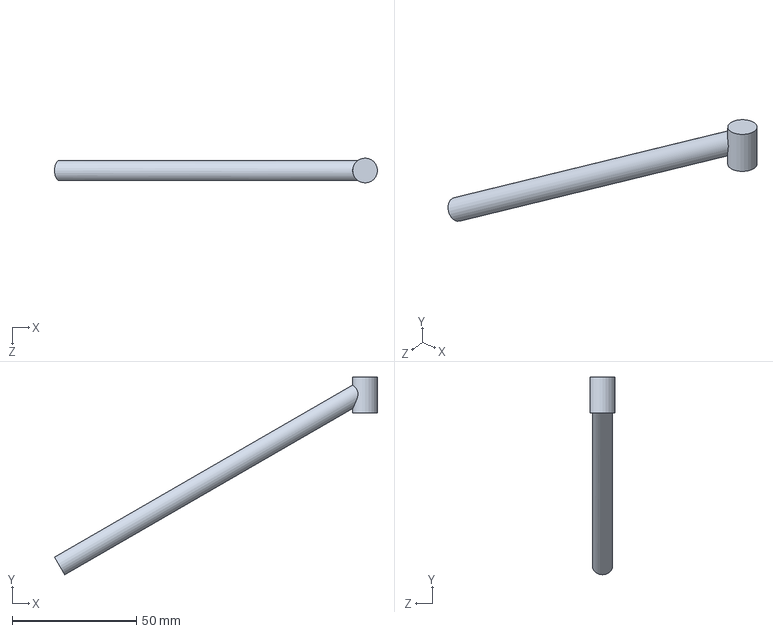
[picture p83: CAD file, 2026-11-12]
CAD/avionics/Antenna_Lean.SLDPRT
130.0 x 79.6 x 10.00 mm
