Aarav-Jindal/VTVL-TVC/CAD/legs/Leg_Sleeve.SLDPRT

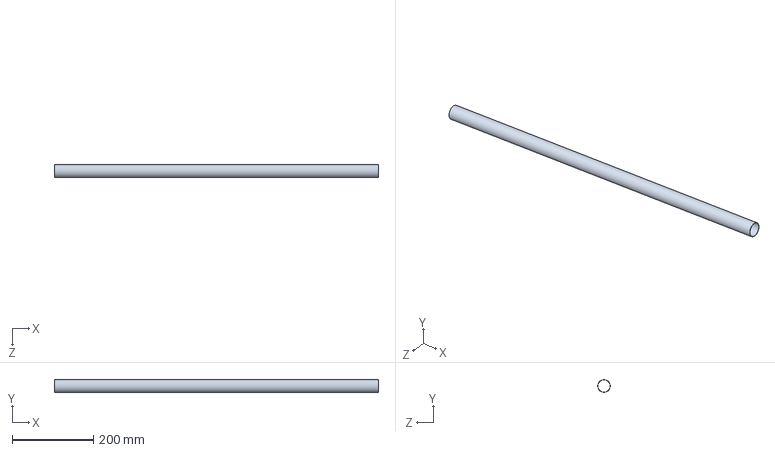
[picture p84: CAD file, 2026-11-12]
CAD/legs/Leg_Sleeve.SLDPRT
800.0 x 31.4 x 31.4 mm
