Aarav-Jindal/VTVL-TVC/CAD/plumbing/Tank_Tube_N2O.SLDPRT

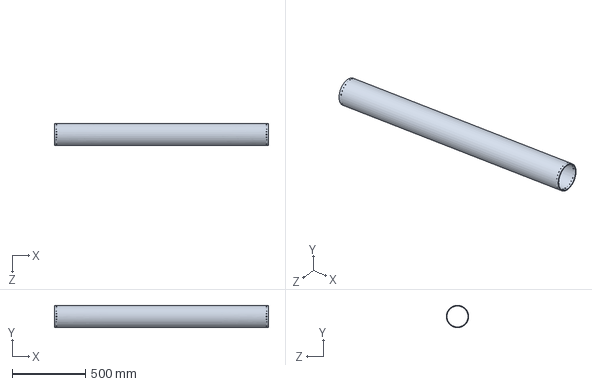
[picture p85: CAD file, 2026-11-12]
CAD/plumbing/Tank_Tube_N2O.SLDPRT
1459.7 x 152.4 x 152.4 mm
