Aarav-Jindal/VTVL-TVC/CAD/avionics/Batt_Servo.SLDPRT

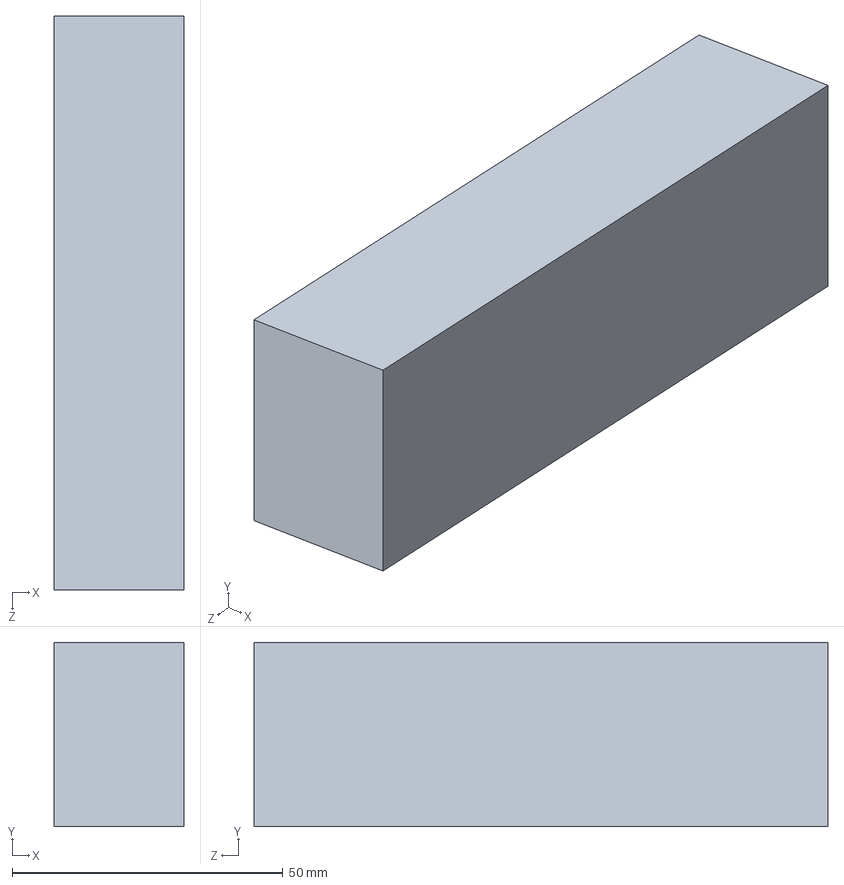
[picture p86: CAD file, 2026-11-12]
CAD/avionics/Batt_Servo.SLDPRT
24.0 x 34.0 x 106.0 mm
