Aarav-Jindal/VTVL-TVC/CAD/legs/Leg_Release_Pin.SLDPRT

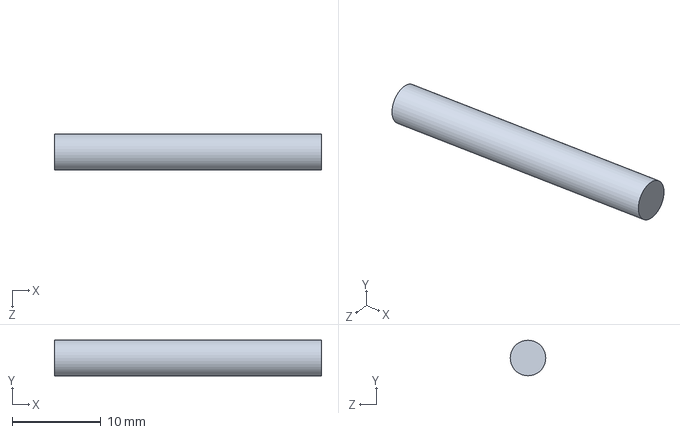
[picture p87: CAD file, 2026-11-12]
CAD/legs/Leg_Release_Pin.SLDPRT
30.0 x 4.00 x 4.00 mm
