Aarav-Jindal/VTVL-TVC/CAD/plumbing/Relief_R3A.SLDPRT

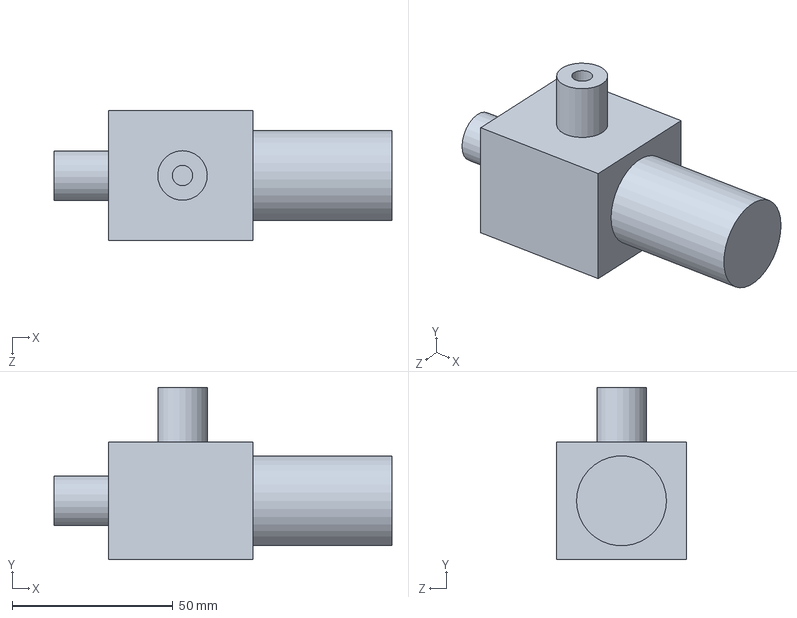
[picture p88: CAD file, 2026-11-12]
CAD/plumbing/Relief_R3A.SLDPRT
105.2 x 53.6 x 40.6 mm
