Aarav-Jindal/VTVL-TVC/CAD/avionics/Batt_Avionics.SLDPRT

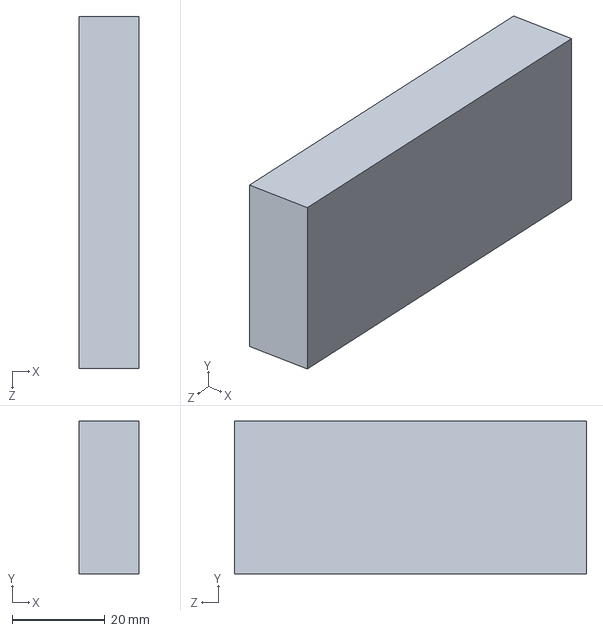
[picture p89: CAD file, 2026-11-12]
CAD/avionics/Batt_Avionics.SLDPRT
13.0 x 33.0 x 76.0 mm
