Aarav-Jindal/VTVL-TVC/CAD/hardware/O_Ring_Pintle.SLDPRT

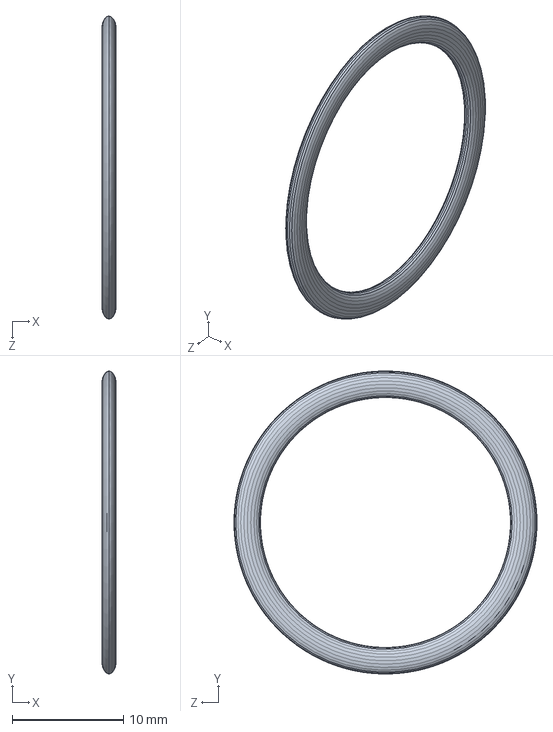
[picture p90: CAD file, 2026-11-12]
CAD/hardware/O_Ring_Pintle.SLDPRT
1.29 x 27.2 x 27.2 mm
