Aarav-Jindal/VTVL-TVC/CAD/legs/Leg_Catch.SLDPRT

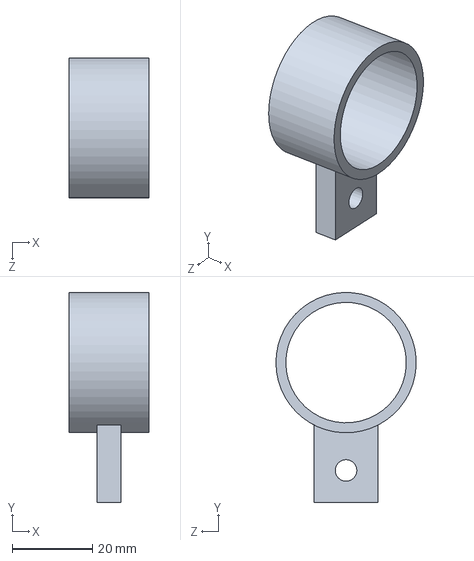
[picture p91: CAD file, 2026-11-12]
CAD/legs/Leg_Catch.SLDPRT
20.0 x 52.4 x 35.0 mm
