Aarav-Jindal/VTVL-TVC/CAD/plumbing/Tube_N_He.SLDPRT

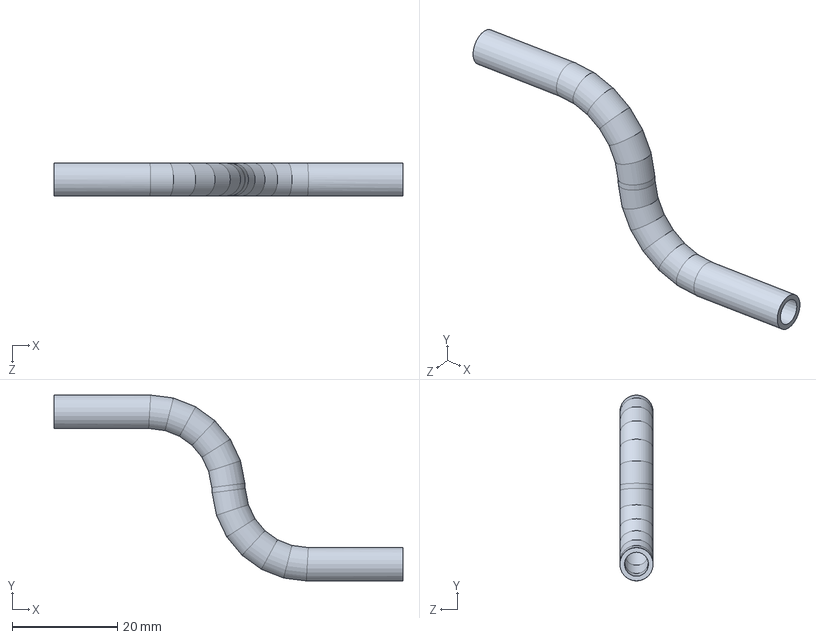
[picture p92: CAD file, 2026-11-12]
CAD/plumbing/Tube_N_He.SLDPRT
66.4 x 35.3 x 6.35 mm
