Aarav-Jindal/VTVL-TVC/CAD/avionics/Strap_BEC.SLDPRT

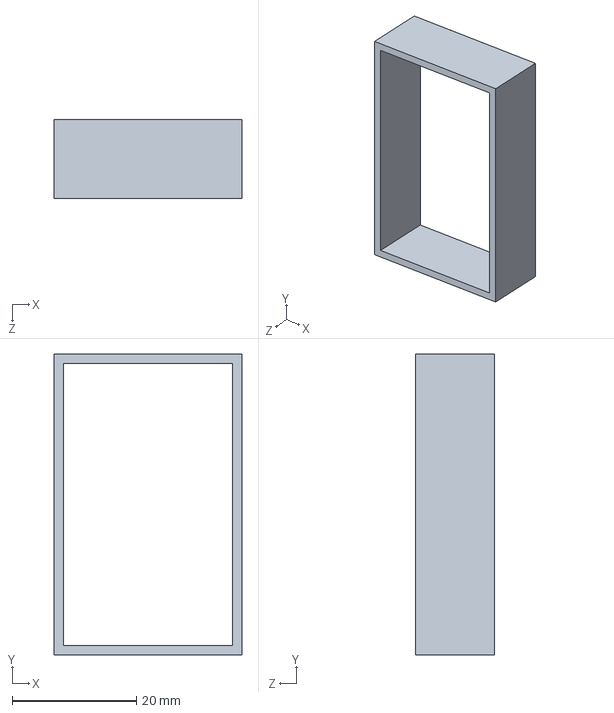
[picture p93: CAD file, 2026-11-12]
CAD/avionics/Strap_BEC.SLDPRT
30.3 x 48.5 x 12.7 mm
