Aarav-Jindal/VTVL-TVC/CAD/hardware/Servo_Horn.SLDPRT

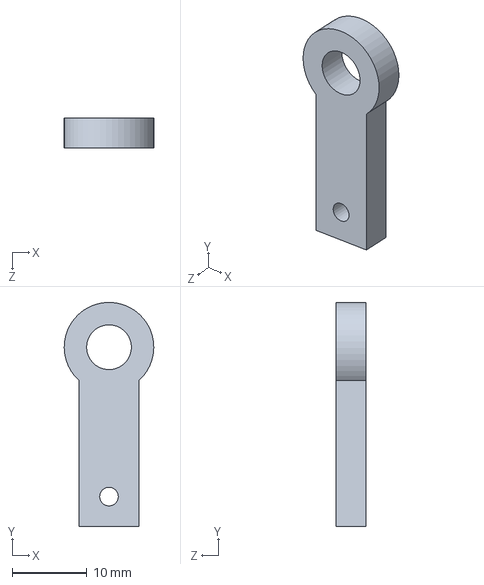
[picture p94: CAD file, 2026-11-12]
CAD/hardware/Servo_Horn.SLDPRT
12.0 x 30.0 x 4.00 mm
