Aarav-Jindal/VTVL-TVC/CAD/legs/Leg_Rod_End.SLDPRT

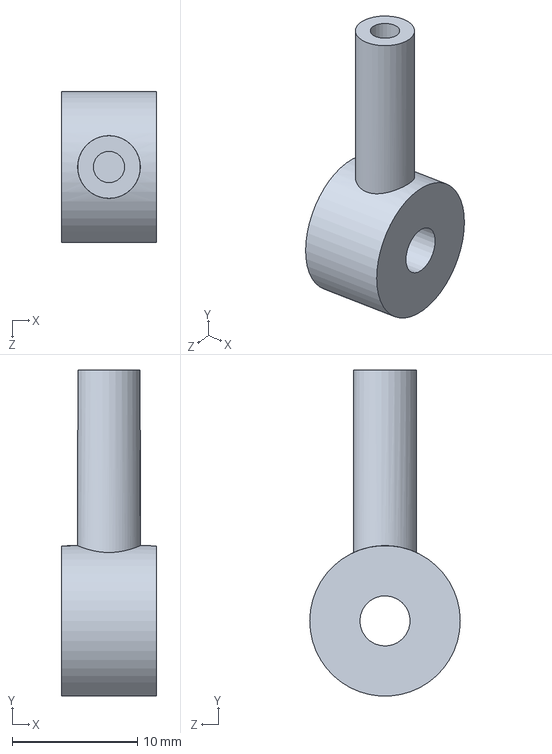
[picture p95: CAD file, 2026-11-12]
CAD/legs/Leg_Rod_End.SLDPRT
7.60 x 26.0 x 12.0 mm
