Aarav-Jindal/VTVL-TVC/CAD/plumbing/Tube_N_Fill.SLDPRT

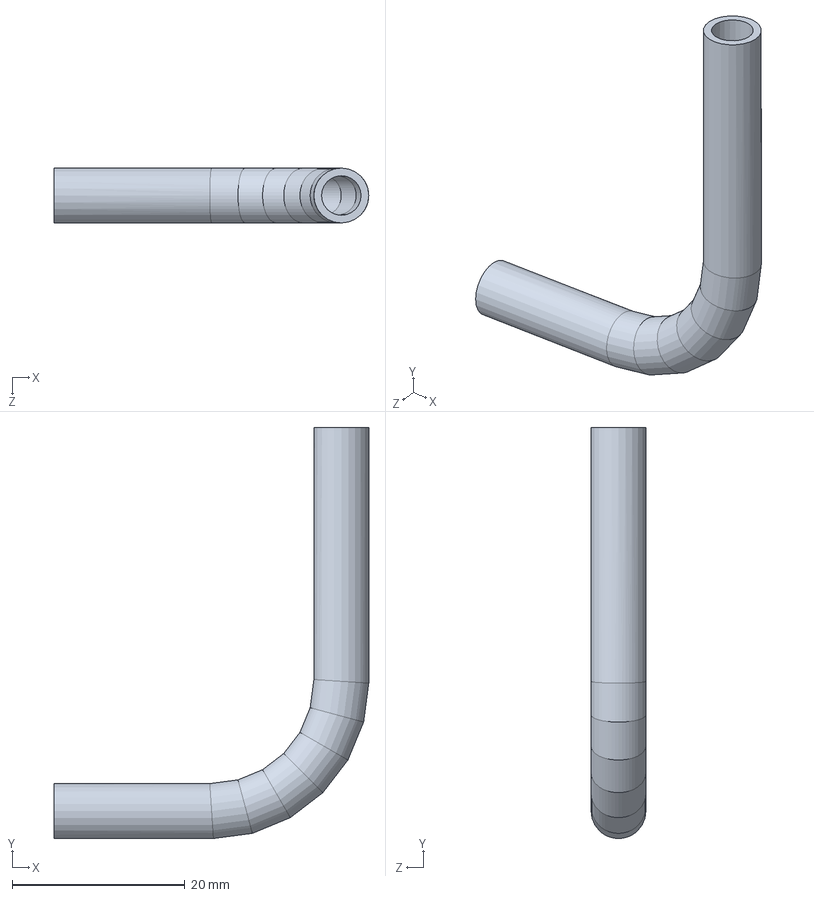
[picture p96: CAD file, 2026-11-12]
CAD/plumbing/Tube_N_Fill.SLDPRT
36.4 x 47.5 x 6.35 mm
