Aarav-Jindal/VTVL-TVC/CAD/avionics/BEC_Tie.SLDPRT

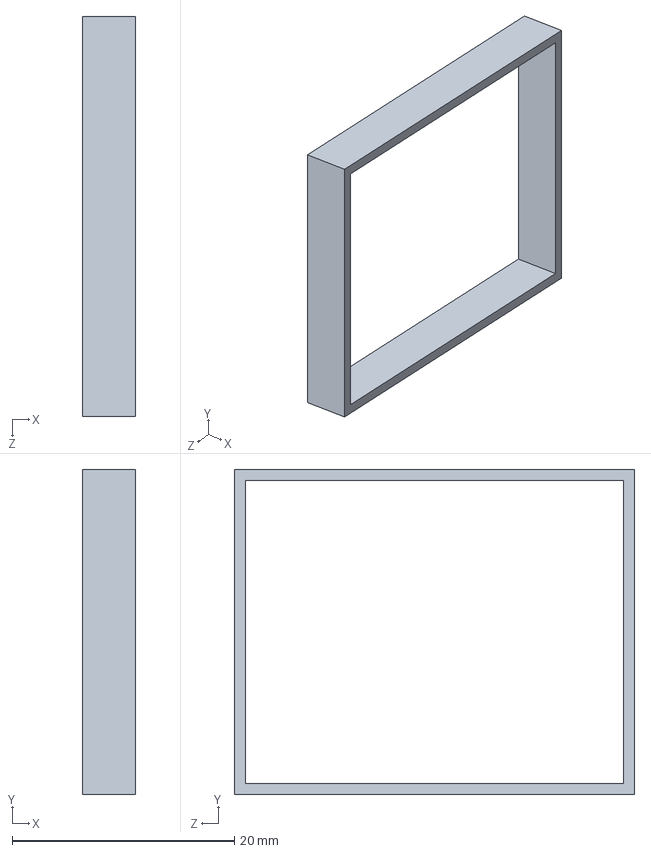
[picture p97: CAD file, 2026-11-12]
CAD/avionics/BEC_Tie.SLDPRT
4.80 x 29.2 x 36.0 mm
