Aarav-Jindal/VTVL-TVC/CAD/legs/Leg_Piston.SLDPRT

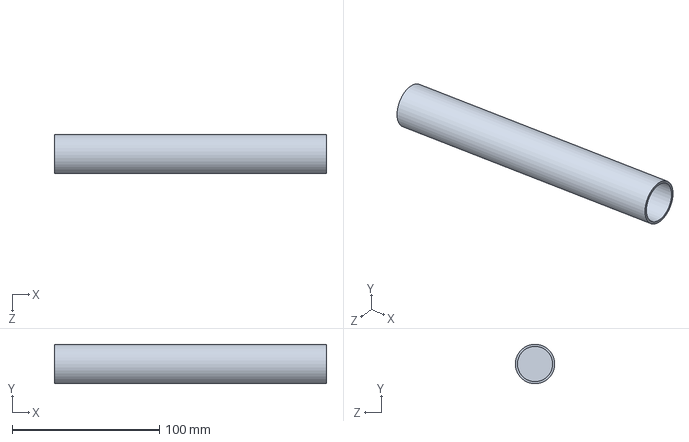
[picture p98: CAD file, 2026-11-12]
CAD/legs/Leg_Piston.SLDPRT
185.0 x 26.8 x 26.8 mm
