Aarav-Jindal/VTVL-TVC/CAD/plumbing/Tank_Ring.SLDPRT

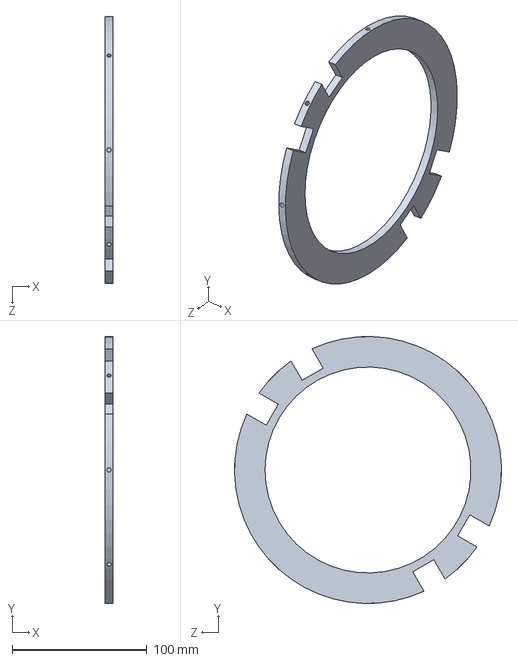
[picture p99: CAD file, 2026-11-12]
CAD/plumbing/Tank_Ring.SLDPRT
6.00 x 198.0 x 198.0 mm
