Aarav-Jindal/VTVL-TVC/CAD/avionics/Spark_Module.SLDPRT

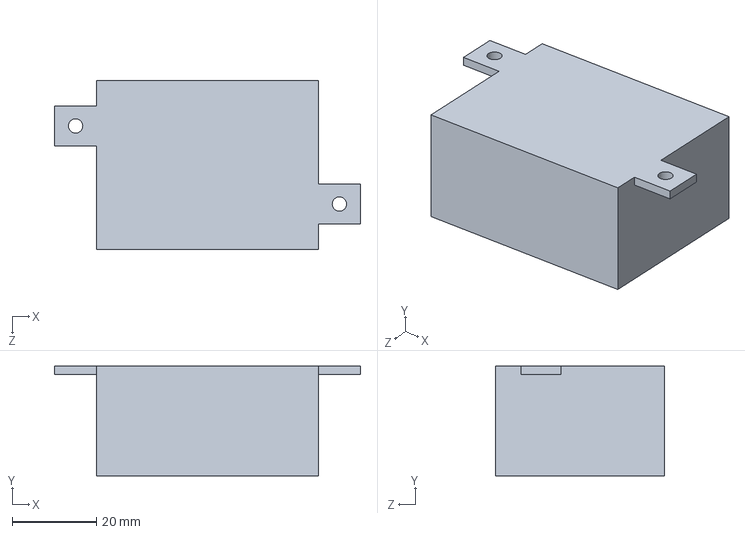
[picture p100: CAD file, 2026-11-12]
CAD/avionics/Spark_Module.SLDPRT
72.5 x 26.0 x 40.0 mm
