Aarav-Jindal/VTVL-TVC/CAD/legs/Leg_Sheath_157.SLDPRT

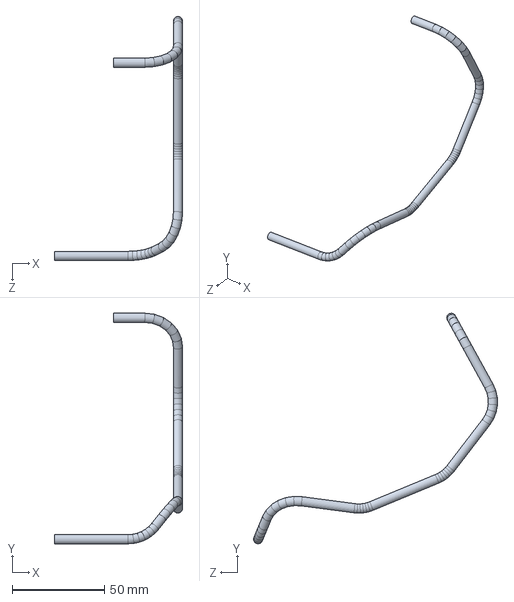
[picture p101: CAD file, 2026-11-12]
CAD/legs/Leg_Sheath_157.SLDPRT
69.5 x 125.1 x 132.3 mm
