Aarav-Jindal/VTVL-TVC/CAD/plumbing/NPT_Ext_30.SLDPRT

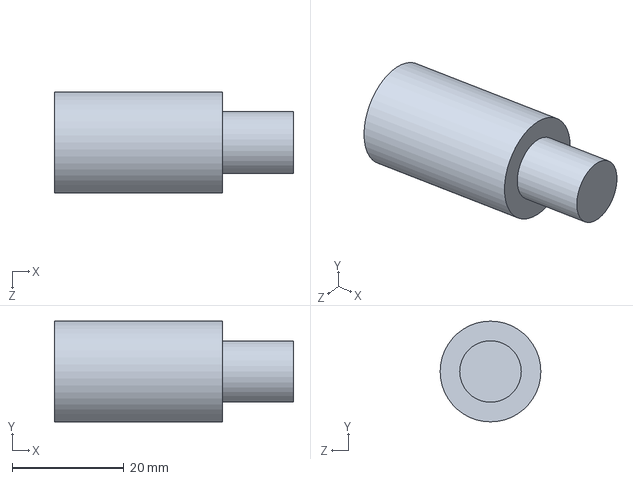
[picture p102: CAD file, 2026-11-12]
CAD/plumbing/NPT_Ext_30.SLDPRT
42.7 x 18.0 x 18.0 mm
