Aarav-Jindal/VTVL-TVC/CAD/avionics/GPS_Plate.SLDPRT

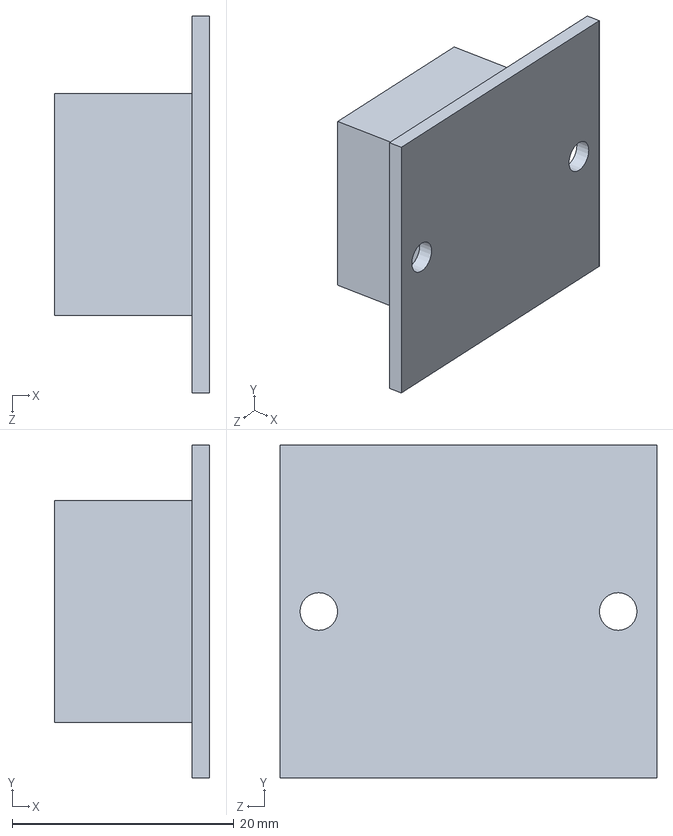
[picture p103: CAD file, 2026-11-12]
CAD/avionics/GPS_Plate.SLDPRT
14.0 x 30.0 x 34.0 mm
