Aarav-Jindal/VTVL-TVC/CAD/legs/Leg_Top_Fitting.SLDPRT

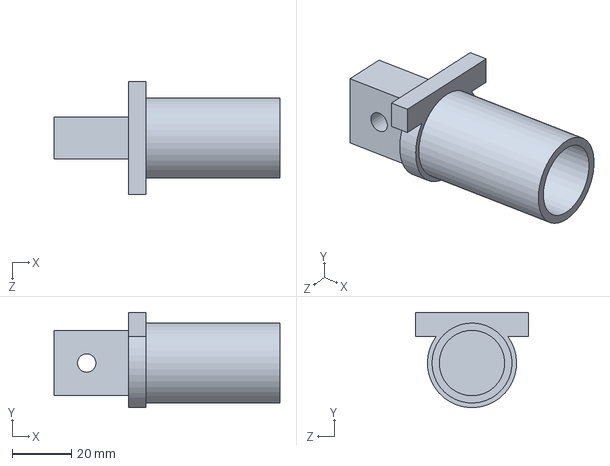
[picture p104: CAD file, 2026-11-12]
CAD/legs/Leg_Top_Fitting.SLDPRT
76.0 x 32.0 x 38.0 mm
