Aarav-Jindal/VTVL-TVC/CAD/plumbing/Tank_Cap_Bottom.SLDPRT

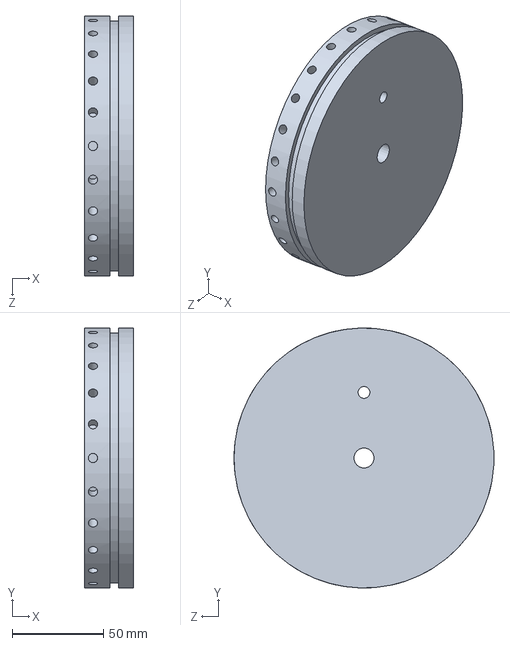
[picture p105: CAD file, 2026-11-12]
CAD/plumbing/Tank_Cap_Bottom.SLDPRT
27.0 x 142.8 x 142.8 mm
