Aarav-Jindal/VTVL-TVC/CAD/avionics/Joint_Ring.SLDPRT

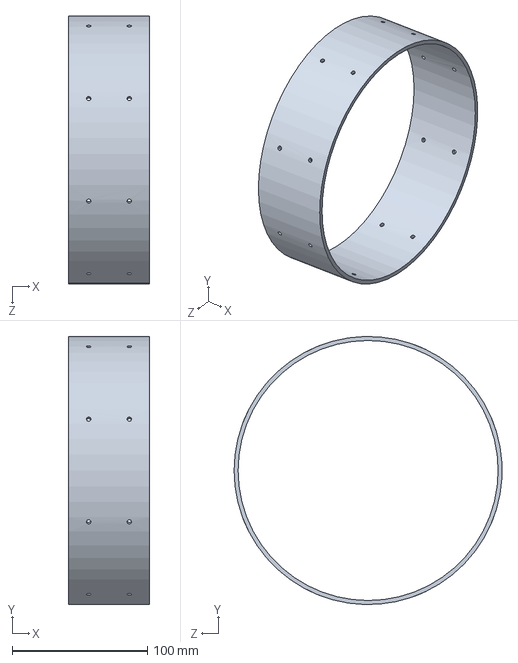
[picture p106: CAD file, 2026-11-12]
CAD/avionics/Joint_Ring.SLDPRT
60.0 x 197.9 x 197.8 mm
