Aarav-Jindal/VTVL-TVC/CAD/plumbing/Tube_Jump_Out.SLDPRT

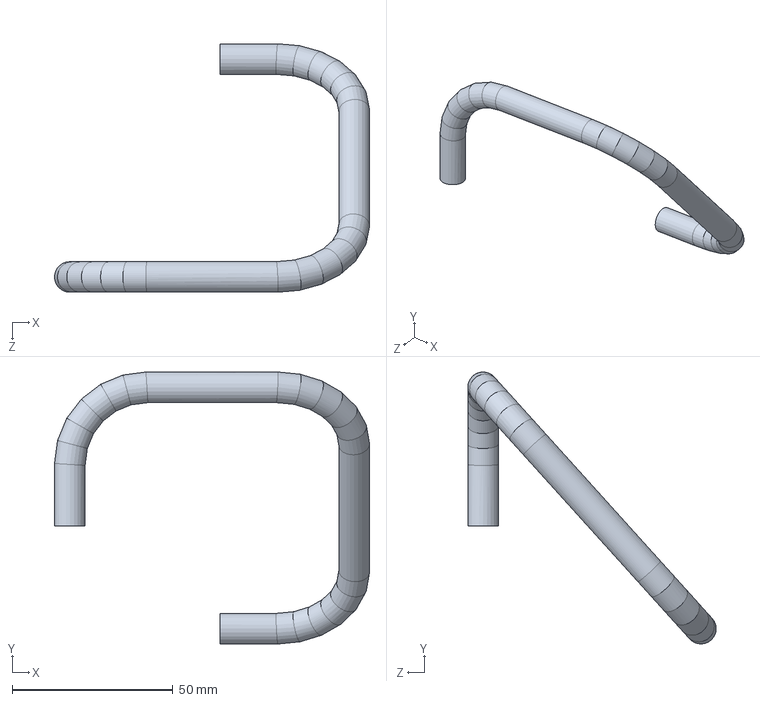
[picture p107: CAD file, 2026-11-12]
CAD/plumbing/Tube_Jump_Out.SLDPRT
98.0 x 84.6 x 77.3 mm
