Aarav-Jindal/VTVL-TVC/CAD/plumbing/Hose_End_6.SLDPRT

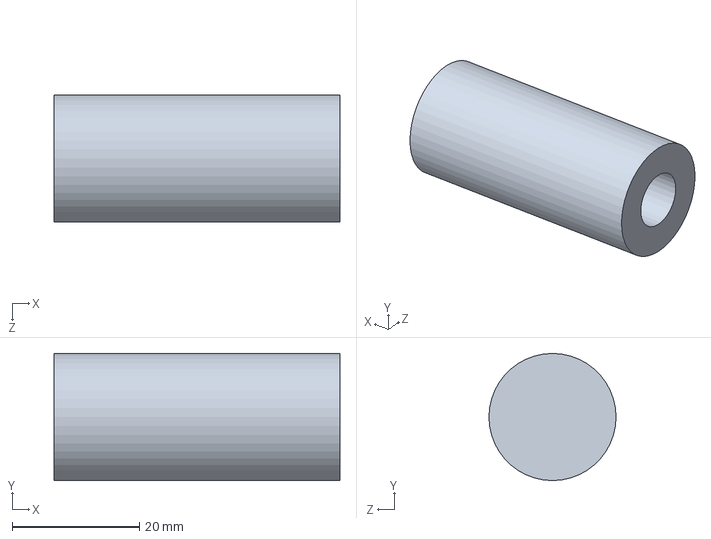
[picture p108: CAD file, 2026-11-12]
CAD/plumbing/Hose_End_6.SLDPRT
45.0 x 20.0 x 20.0 mm
