Aarav-Jindal/VTVL-TVC/CAD/avionics/IMU_Plate.SLDPRT

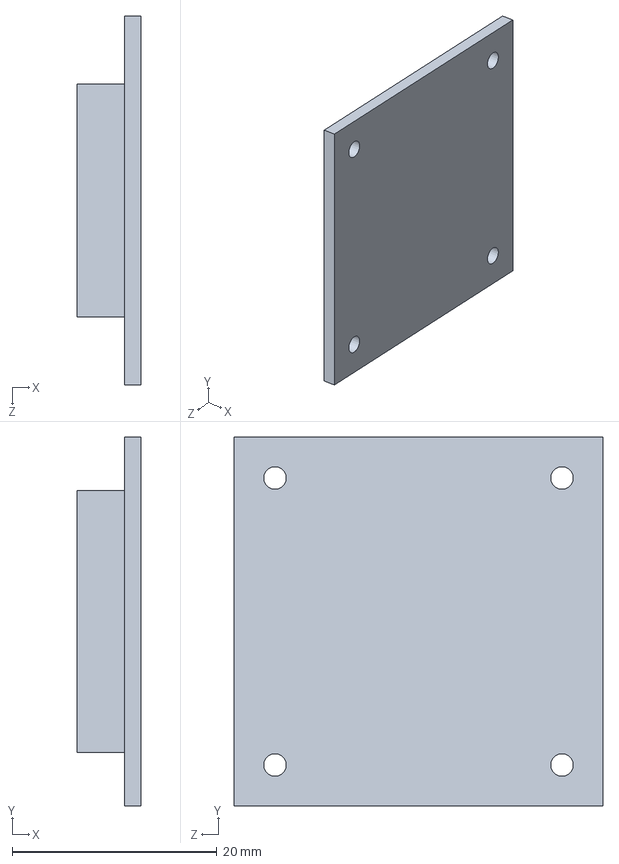
[picture p109: CAD file, 2026-11-12]
CAD/avionics/IMU_Plate.SLDPRT
6.20 x 36.0 x 36.0 mm
