Aarav-Jindal/VTVL-TVC/CAD/hardware/Servo.SLDPRT

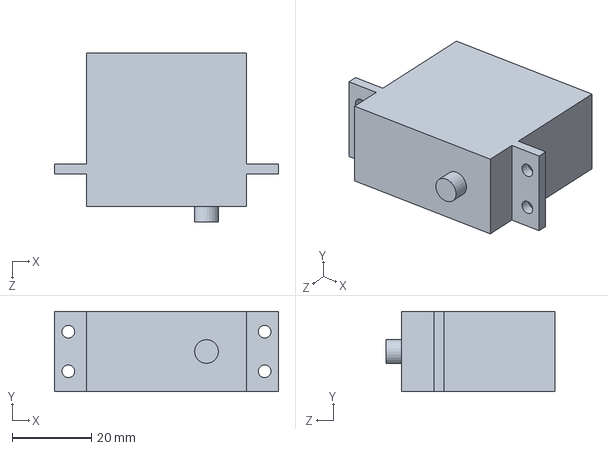
[picture p110: CAD file, 2026-11-12]
CAD/hardware/Servo.SLDPRT
56.5 x 20.2 x 42.7 mm
