Aarav-Jindal/VTVL-TVC/CAD/plumbing/Reg_Outlet_Upper.SLDPRT

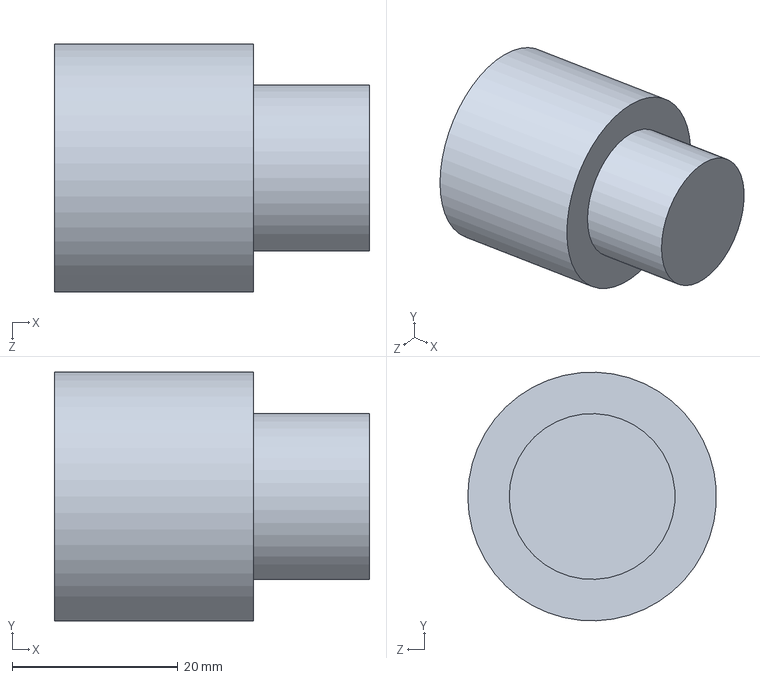
[picture p111: CAD file, 2026-11-12]
CAD/plumbing/Reg_Outlet_Upper.SLDPRT
38.0 x 30.0 x 30.0 mm
