Aarav-Jindal/VTVL-TVC/CAD/avionics/Insert_M4.SLDPRT

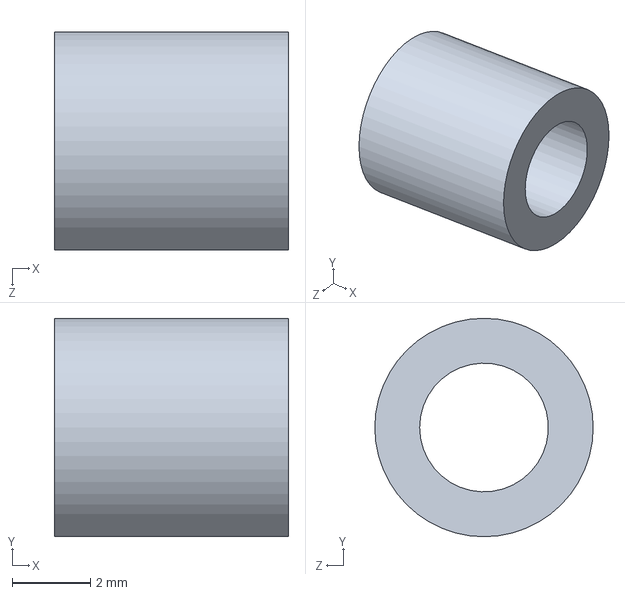
[picture p112: CAD file, 2026-11-12]
CAD/avionics/Insert_M4.SLDPRT
6.00 x 5.60 x 5.60 mm
