Aarav-Jindal/VTVL-TVC/CAD/hardware/Pin_Inner.SLDPRT

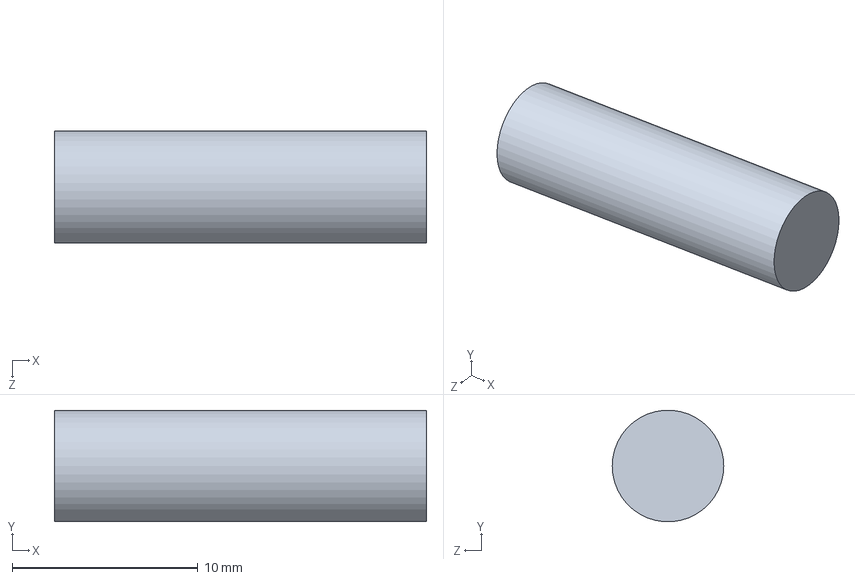
[picture p113: CAD file, 2026-11-12]
CAD/hardware/Pin_Inner.SLDPRT
20.0 x 5.98 x 6.00 mm
