Aarav-Jindal/VTVL-TVC/CAD/plumbing/Tube_N_Dip.SLDPRT

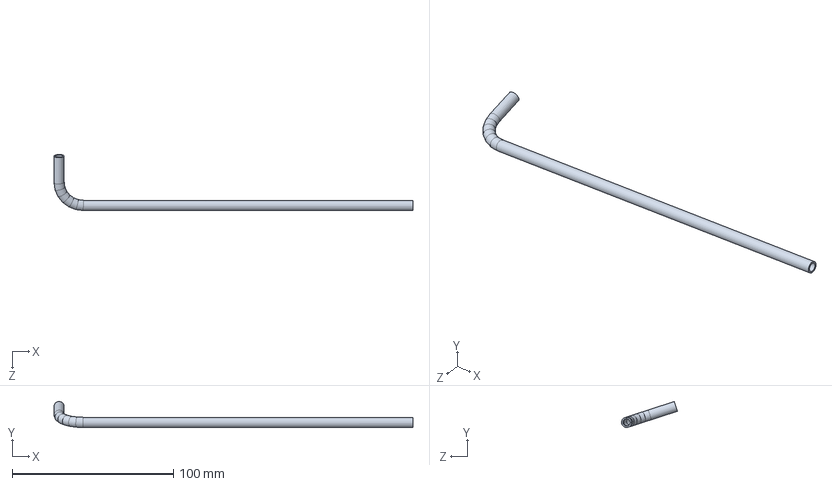
[picture p114: CAD file, 2026-11-12]
CAD/plumbing/Tube_N_Dip.SLDPRT
222.7 x 16.1 x 34.7 mm
