Aarav-Jindal/VTVL-TVC/CAD/avionics/Bay_Tray.SLDPRT

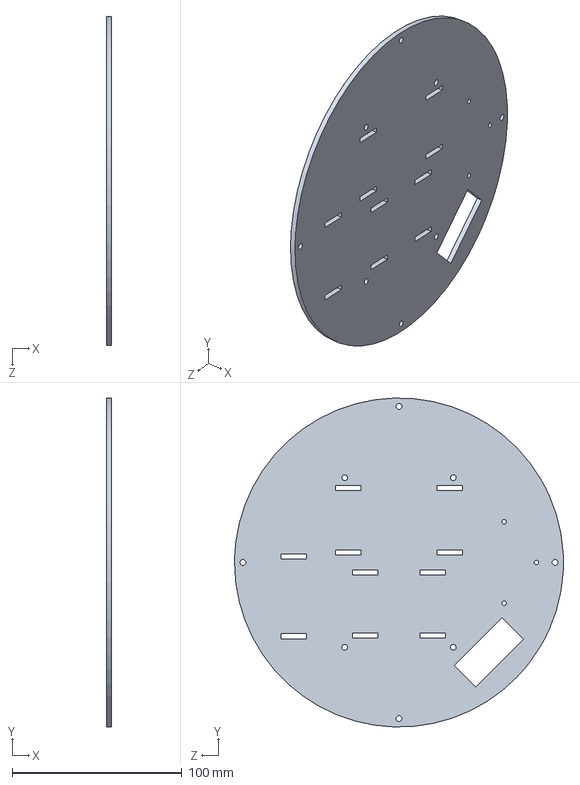
[picture p115: CAD file, 2026-11-12]
CAD/avionics/Bay_Tray.SLDPRT
3.18 x 193.9 x 194.0 mm
