Aarav-Jindal/VTVL-TVC/CAD/hardware/Ball_Stud.SLDPRT

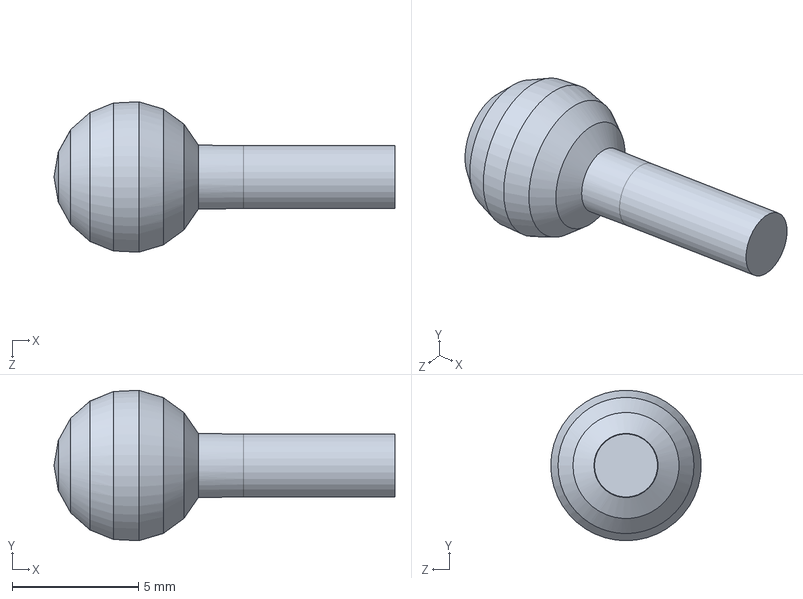
[picture p116: CAD file, 2026-11-12]
CAD/hardware/Ball_Stud.SLDPRT
13.5 x 5.96 x 5.96 mm
