Aarav-Jindal/VTVL-TVC/CAD/plumbing/Tube_He_Upper.SLDPRT

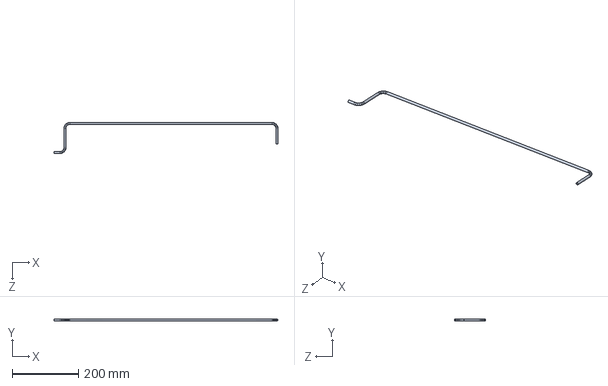
[picture p117: CAD file, 2026-11-12]
CAD/plumbing/Tube_He_Upper.SLDPRT
677.5 x 6.35 x 94.3 mm
