Aarav-Jindal/VTVL-TVC/CAD/avionics/Strap_Avionics.SLDPRT

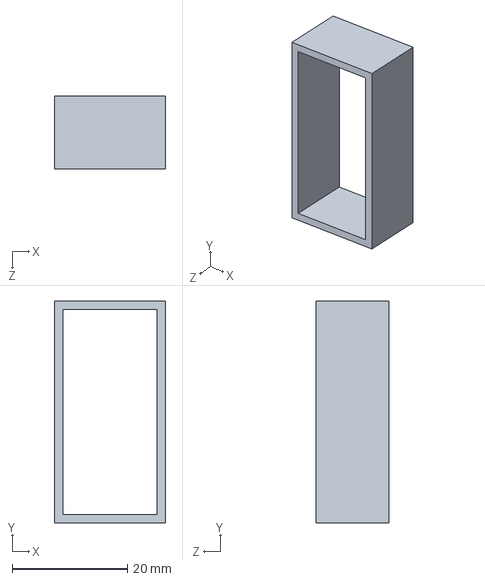
[picture p118: CAD file, 2026-11-12]
CAD/avionics/Strap_Avionics.SLDPRT
19.3 x 38.5 x 12.7 mm
