Aarav-Jindal/VTVL-TVC/CAD/hardware/Bushing.SLDPRT

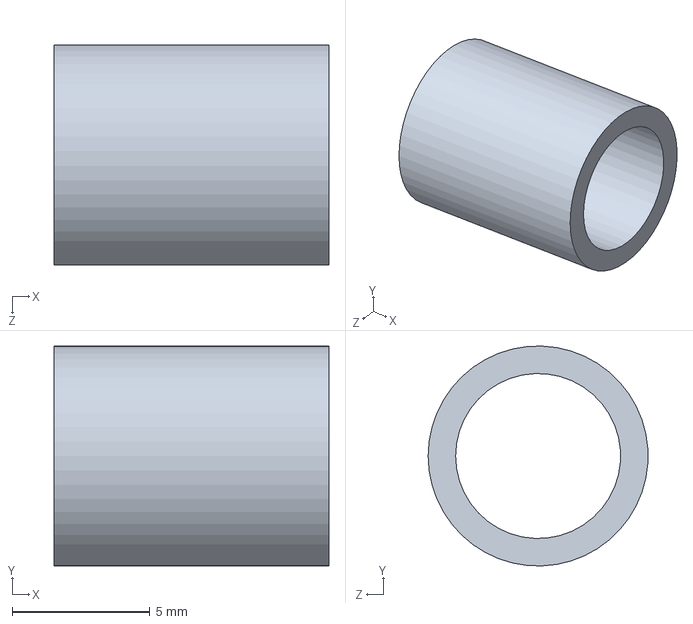
[picture p119: CAD file, 2026-11-12]
CAD/hardware/Bushing.SLDPRT
10.0 x 8.00 x 7.99 mm
