Aarav-Jindal/VTVL-TVC/CAD/plumbing/Cap_T6.SLDPRT

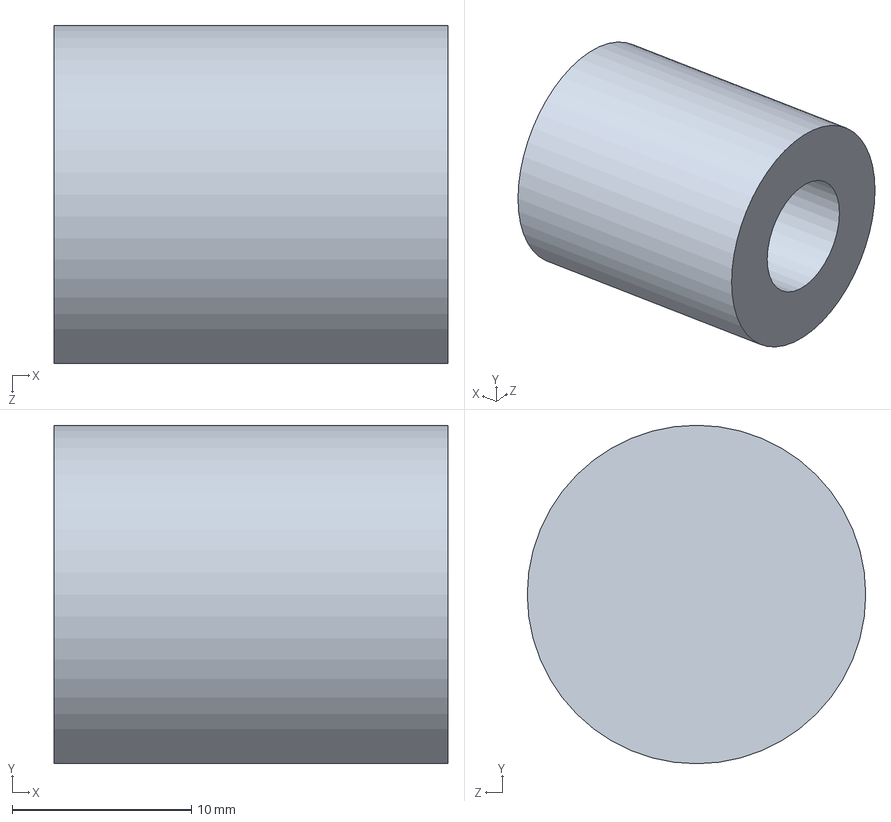
[picture p120: CAD file, 2026-11-12]
CAD/plumbing/Cap_T6.SLDPRT
22.0 x 18.9 x 18.9 mm
