Aarav-Jindal/VTVL-TVC/CAD/avionics/Antenna_Up.SLDPRT

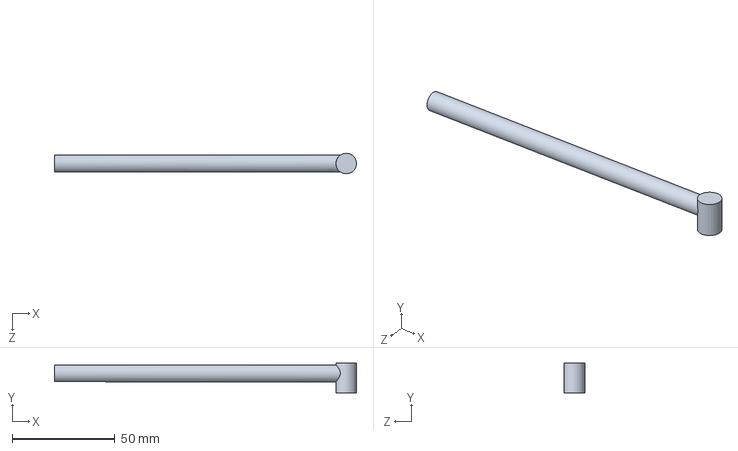
[picture p121: CAD file, 2026-11-12]
CAD/avionics/Antenna_Up.SLDPRT
147.0 x 14.5 x 10.0 mm
