Aarav-Jindal/VTVL-TVC/CAD/plumbing/Valve_Bracket_42.SLDPRT

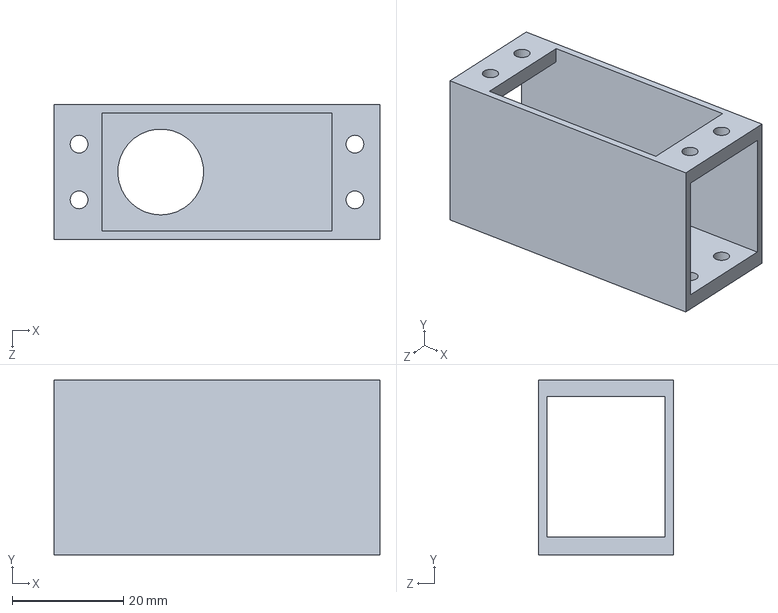
[picture p122: CAD file, 2026-11-12]
CAD/plumbing/Valve_Bracket_42.SLDPRT
58.5 x 31.4 x 24.2 mm
