Aarav-Jindal/VTVL-TVC/CAD/plumbing/Union_T4.SLDPRT

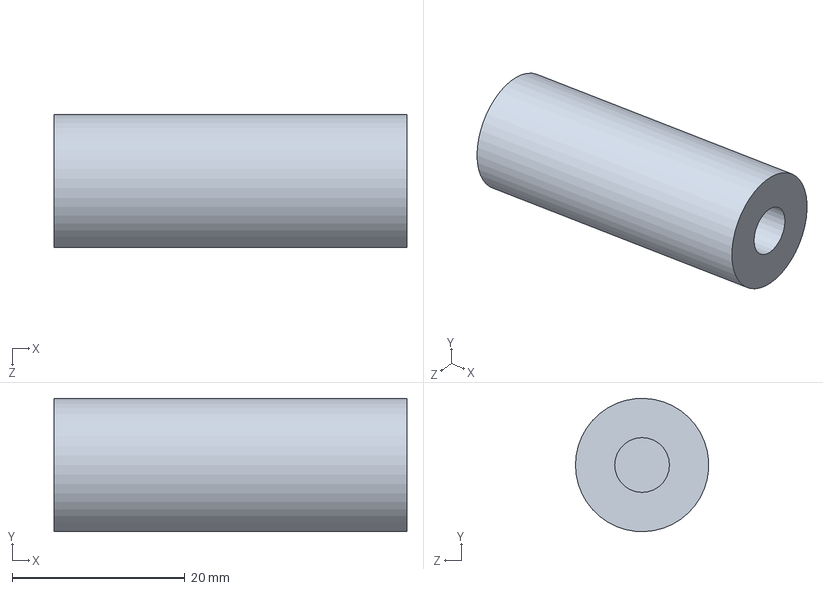
[picture p123: CAD file, 2026-11-12]
CAD/plumbing/Union_T4.SLDPRT
40.9 x 15.4 x 15.4 mm
