Aarav-Jindal/VTVL-TVC/CAD/plumbing/Conn_T6_ORB8.SLDPRT

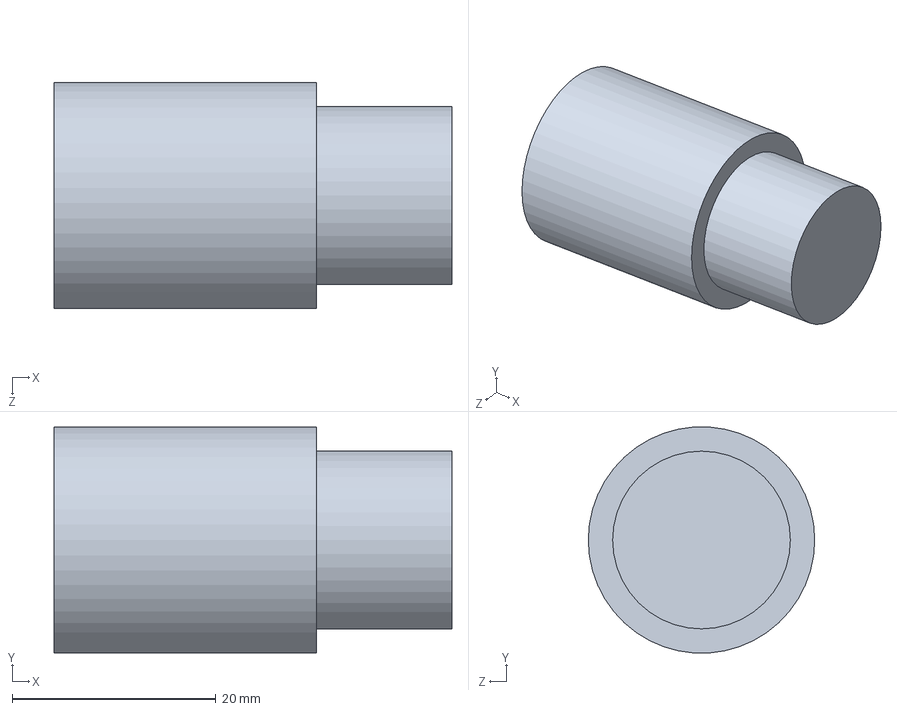
[picture p124: CAD file, 2026-11-12]
CAD/plumbing/Conn_T6_ORB8.SLDPRT
39.1 x 22.2 x 22.2 mm
