Aarav-Jindal/VTVL-TVC/CAD/plumbing/Sensor_Turck.SLDPRT

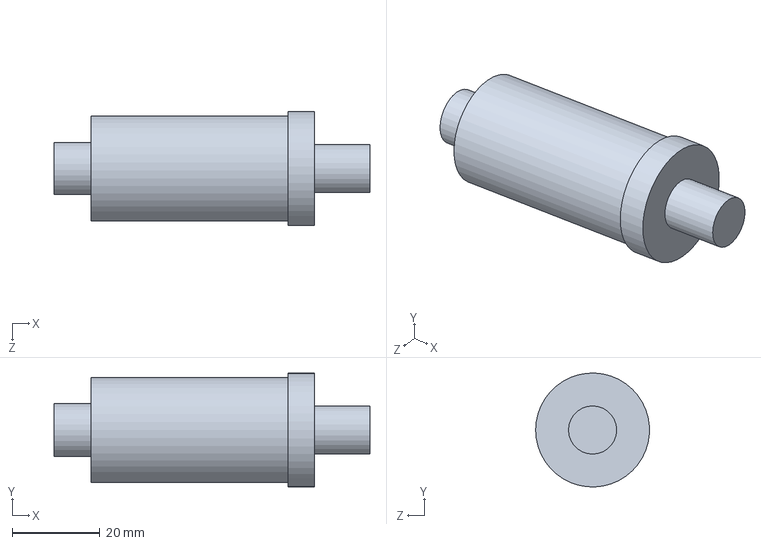
[picture p125: CAD file, 2026-11-12]
CAD/plumbing/Sensor_Turck.SLDPRT
72.1 x 26.0 x 26.0 mm
