Aarav-Jindal/VTVL-TVC/CAD/plumbing/Stem_Coupler.SLDPRT

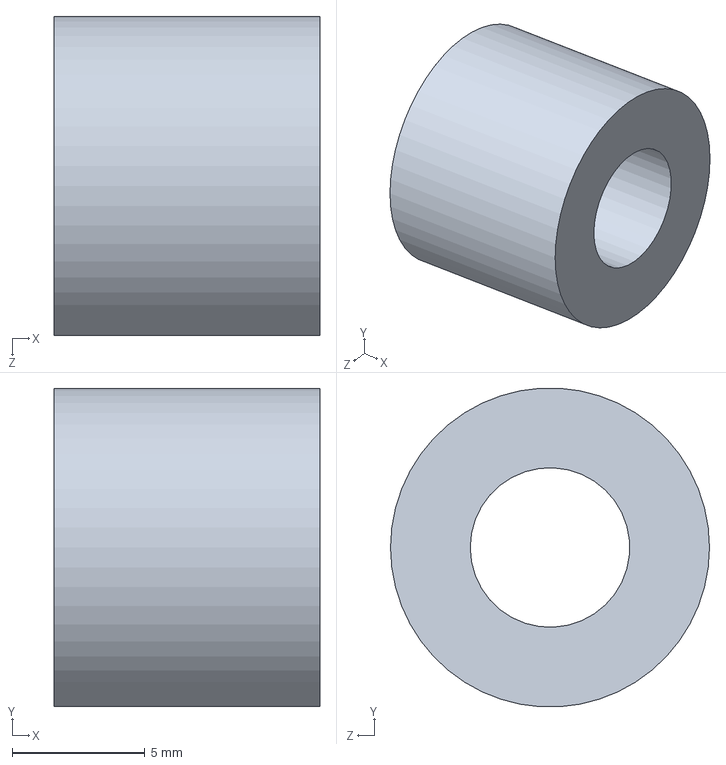
[picture p126: CAD file, 2026-11-12]
CAD/plumbing/Stem_Coupler.SLDPRT
10.0 x 12.0 x 12.0 mm
