Aarav-Jindal/VTVL-TVC/CAD/plumbing/Tube_E_PT4.SLDPRT

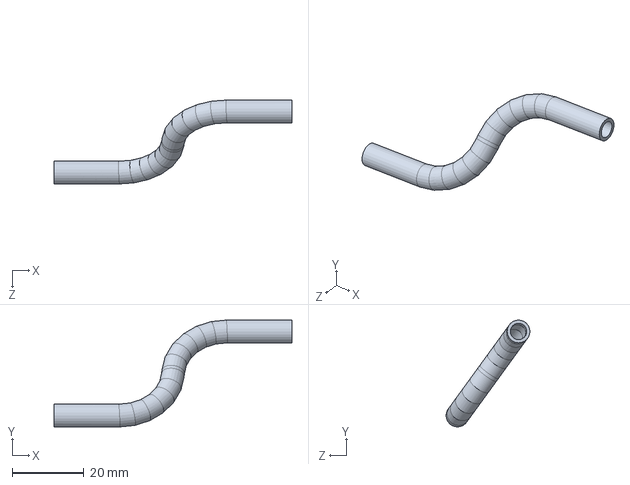
[picture p127: CAD file, 2026-11-12]
CAD/plumbing/Tube_E_PT4.SLDPRT
66.4 x 29.8 x 23.4 mm
