Aarav-Jindal/VTVL-TVC/CAD/plumbing/Tube_HP_Up.SLDPRT

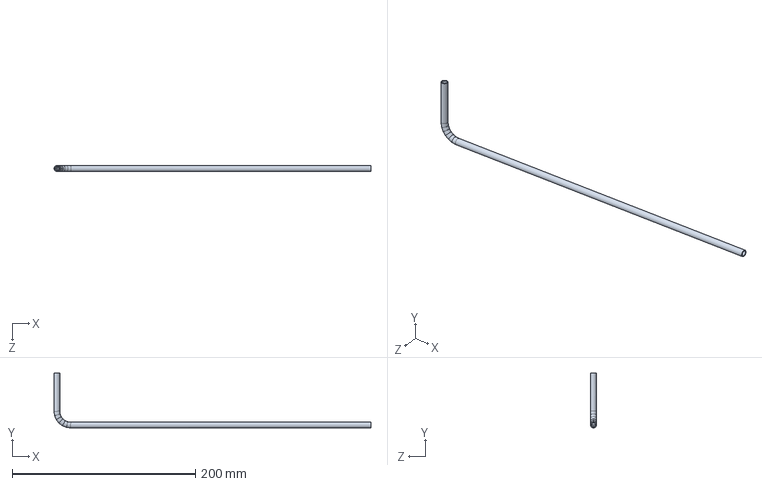
[picture p128: CAD file, 2026-11-12]
CAD/plumbing/Tube_HP_Up.SLDPRT
345.7 x 59.9 x 6.35 mm
