Aarav-Jindal/VTVL-TVC/CAD/plumbing/Conn_T8_ORB8.SLDPRT

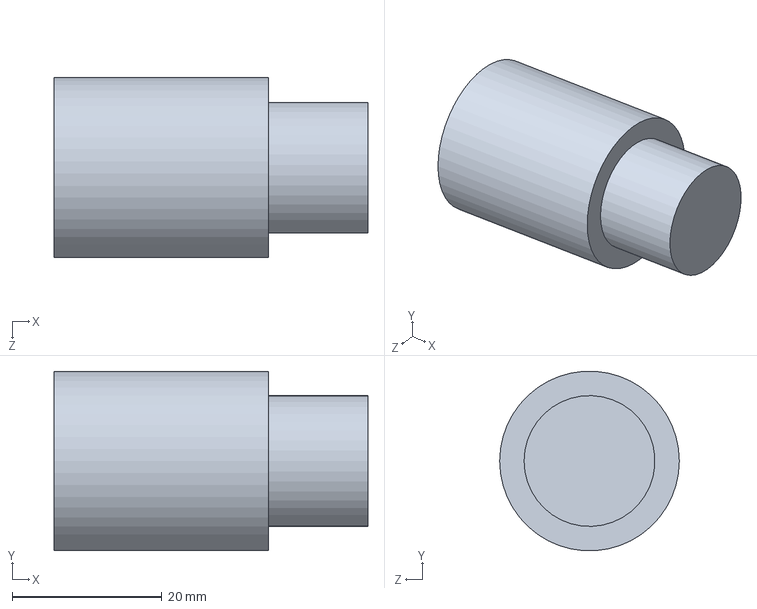
[picture p129: CAD file, 2026-11-12]
CAD/plumbing/Conn_T8_ORB8.SLDPRT
41.9 x 23.9 x 24.0 mm
