Aarav-Jindal/VTVL-TVC/CAD/plumbing/Conn_T4_MNPT.SLDPRT

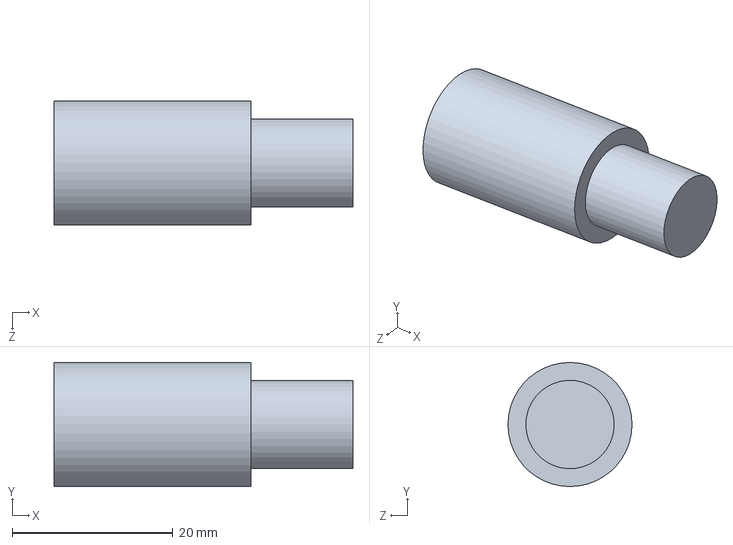
[picture p130: CAD file, 2026-11-12]
CAD/plumbing/Conn_T4_MNPT.SLDPRT
37.2 x 15.4 x 15.4 mm
