Aarav-Jindal/VTVL-TVC/CAD/plumbing/Valve_42GS4.SLDPRT

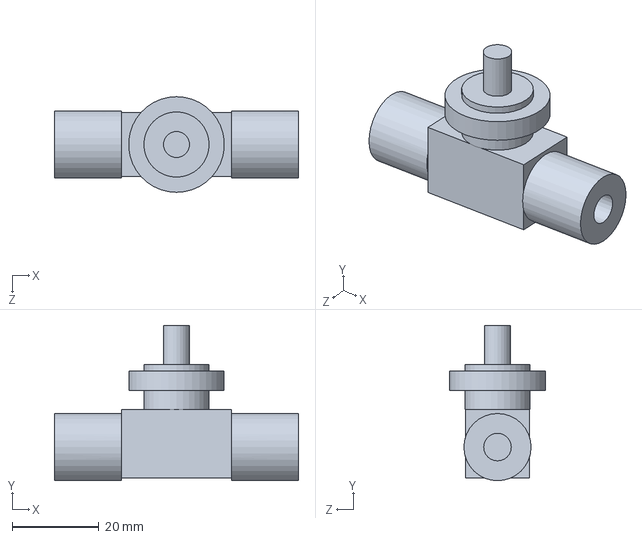
[picture p131: CAD file, 2026-11-12]
CAD/plumbing/Valve_42GS4.SLDPRT
56.1 x 35.7 x 22.0 mm
