Aarav-Jindal/VTVL-TVC/CAD/plumbing/Tube_E_He.SLDPRT

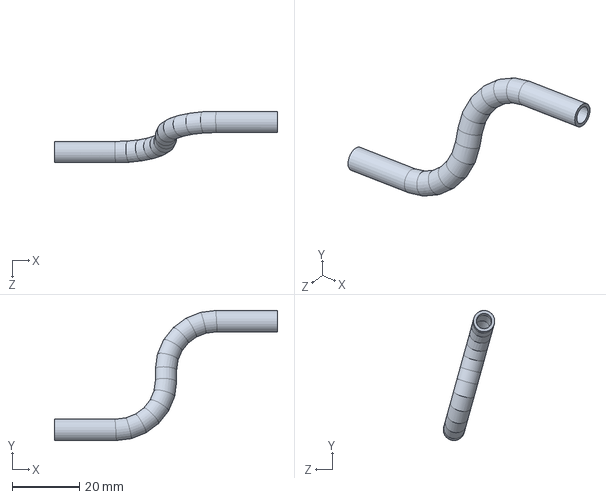
[picture p132: CAD file, 2026-11-12]
CAD/plumbing/Tube_E_He.SLDPRT
66.4 x 38.7 x 15.3 mm
