Aarav-Jindal/VTVL-TVC/CAD/plumbing/Reg_Outlet_Adapter.SLDPRT

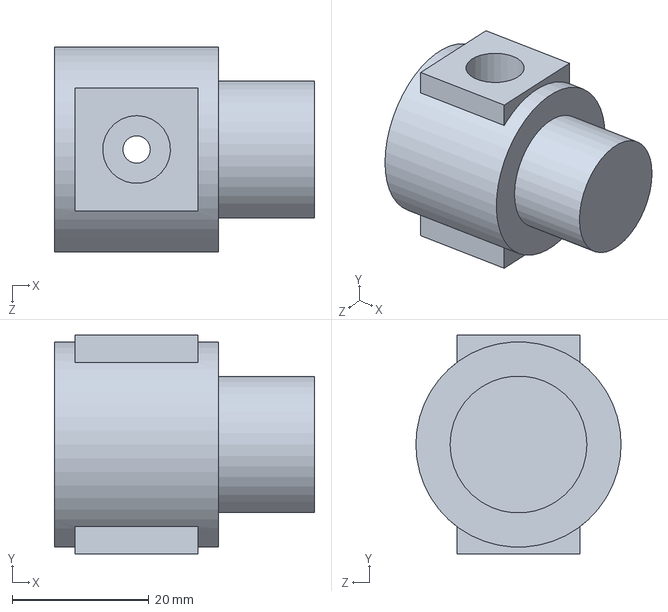
[picture p133: CAD file, 2026-11-12]
CAD/plumbing/Reg_Outlet_Adapter.SLDPRT
38.0 x 32.0 x 30.0 mm
