Aarav-Jindal/VTVL-TVC/CAD/plumbing/Hose_10.SLDPRT

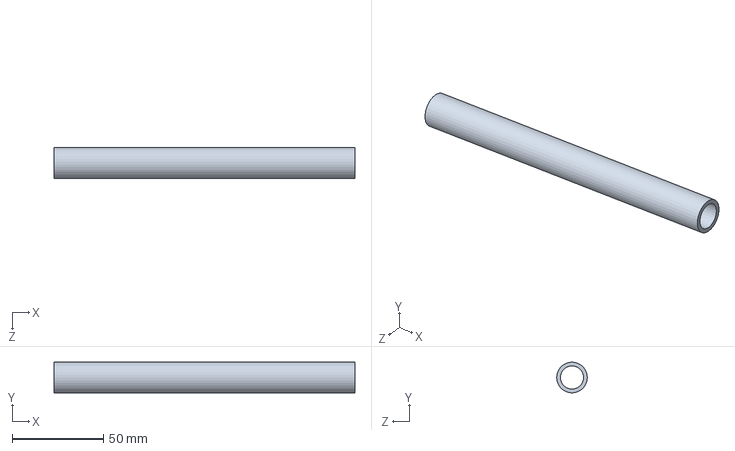
[picture p134: CAD file, 2026-11-12]
CAD/plumbing/Hose_10.SLDPRT
165.0 x 16.7 x 16.8 mm
