Aarav-Jindal/VTVL-TVC/CAD/plumbing/Fill_QC4.SLDPRT

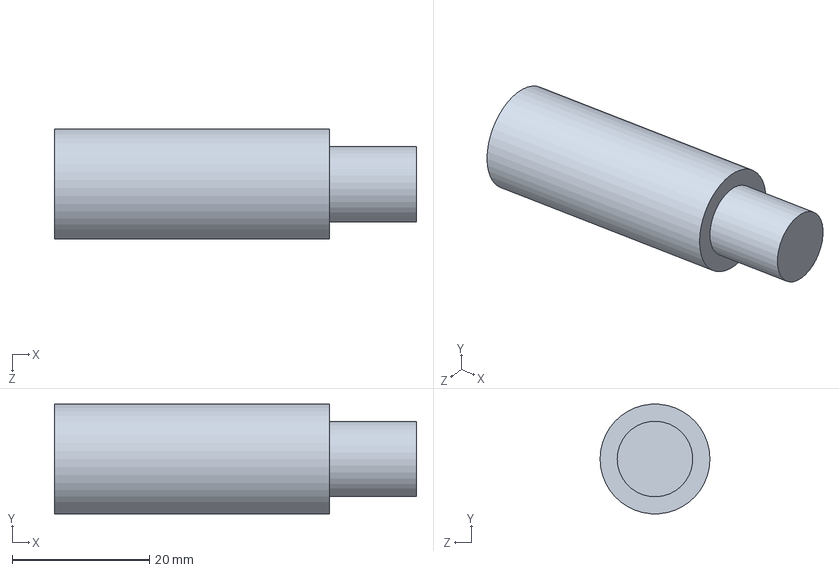
[picture p135: CAD file, 2026-11-12]
CAD/plumbing/Fill_QC4.SLDPRT
52.7 x 16.0 x 16.0 mm
