Aarav-Jindal/VTVL-TVC/CAD/plumbing/Conn_T4_FNPT.SLDPRT

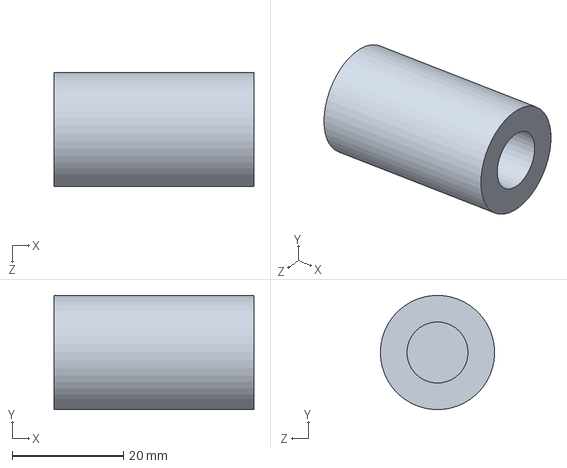
[picture p136: CAD file, 2026-11-12]
CAD/plumbing/Conn_T4_FNPT.SLDPRT
36.0 x 20.5 x 20.6 mm
