Aarav-Jindal/VTVL-TVC/CAD/plumbing/Elbow_T6_ORB4.SLDPRT

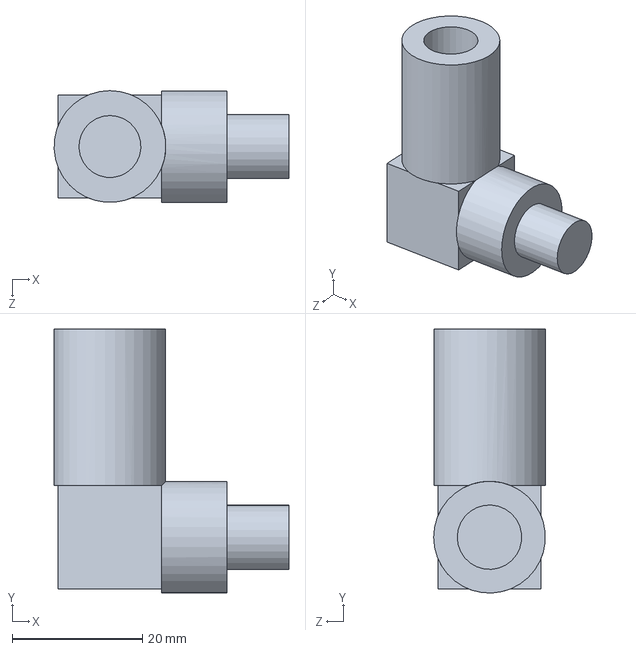
[picture p137: CAD file, 2026-11-12]
CAD/plumbing/Elbow_T6_ORB4.SLDPRT
36.1 x 40.6 x 17.2 mm
