Aarav-Jindal/VTVL-TVC/CAD/plumbing/Servo_Valve.SLDPRT

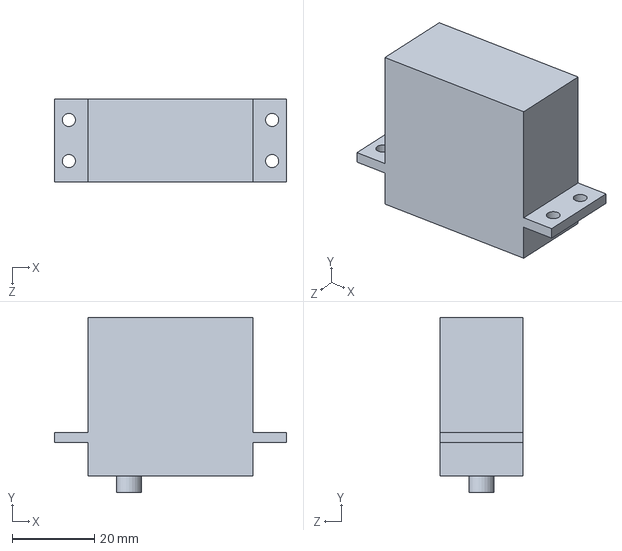
[picture p138: CAD file, 2026-11-12]
CAD/plumbing/Servo_Valve.SLDPRT
56.5 x 42.7 x 20.2 mm
