Aarav-Jindal/VTVL-TVC/CAD/plumbing/Tube_N_RV2.SLDPRT

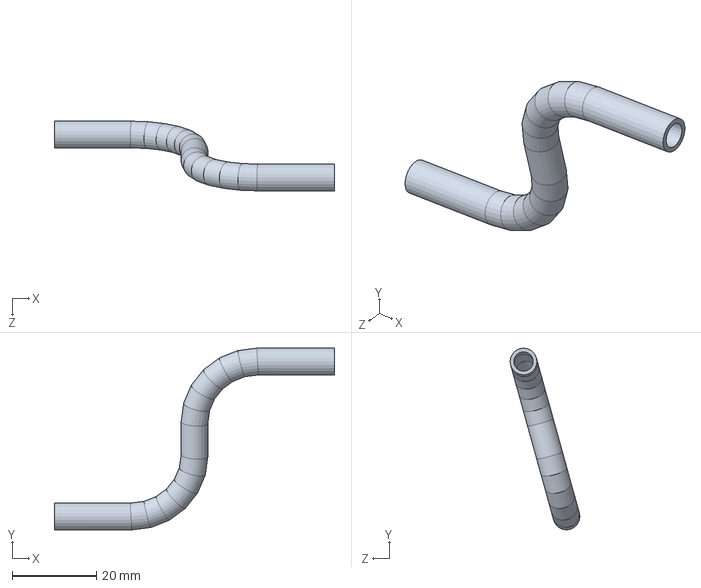
[picture p139: CAD file, 2026-11-12]
CAD/plumbing/Tube_N_RV2.SLDPRT
66.4 x 43.1 x 16.5 mm
