Aarav-Jindal/VTVL-TVC/CAD/plumbing/Plug_ORB4.SLDPRT

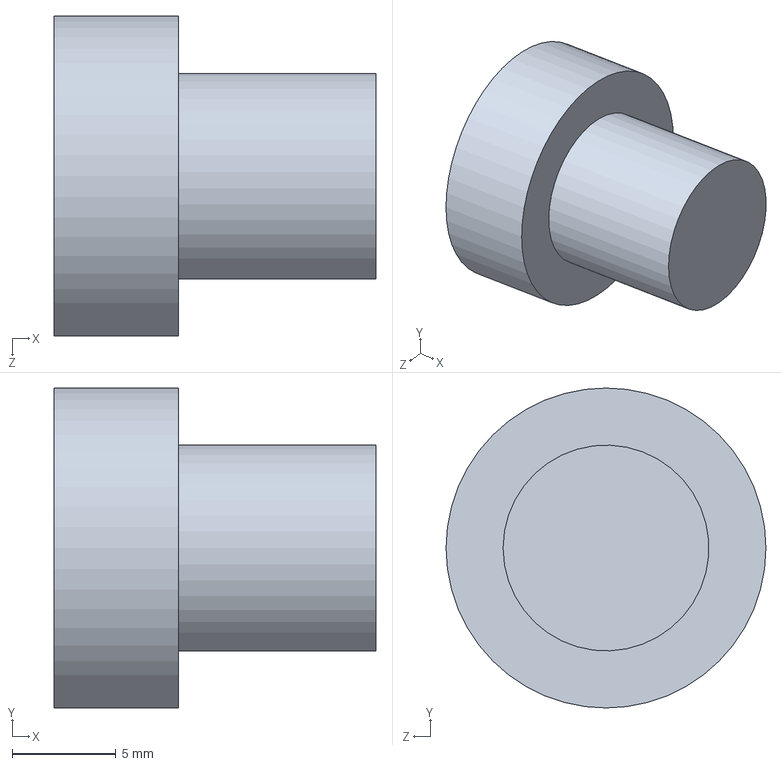
[picture p140: CAD file, 2026-11-12]
CAD/plumbing/Plug_ORB4.SLDPRT
15.5 x 15.4 x 15.4 mm
