Aarav-Jindal/VTVL-TVC/CAD/plumbing/Valve_1RS6.SLDPRT

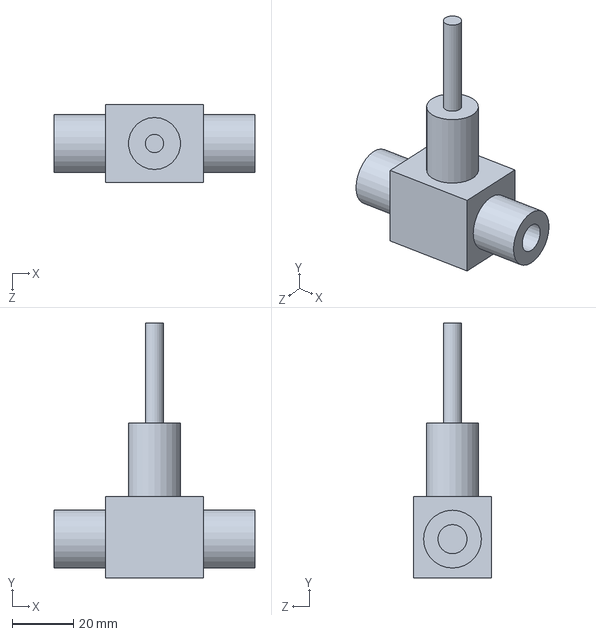
[picture p141: CAD file, 2026-11-12]
CAD/plumbing/Valve_1RS6.SLDPRT
65.5 x 83.3 x 25.4 mm
