Aarav-Jindal/VTVL-TVC/CAD/plumbing/Valve_43GS6.SLDPRT

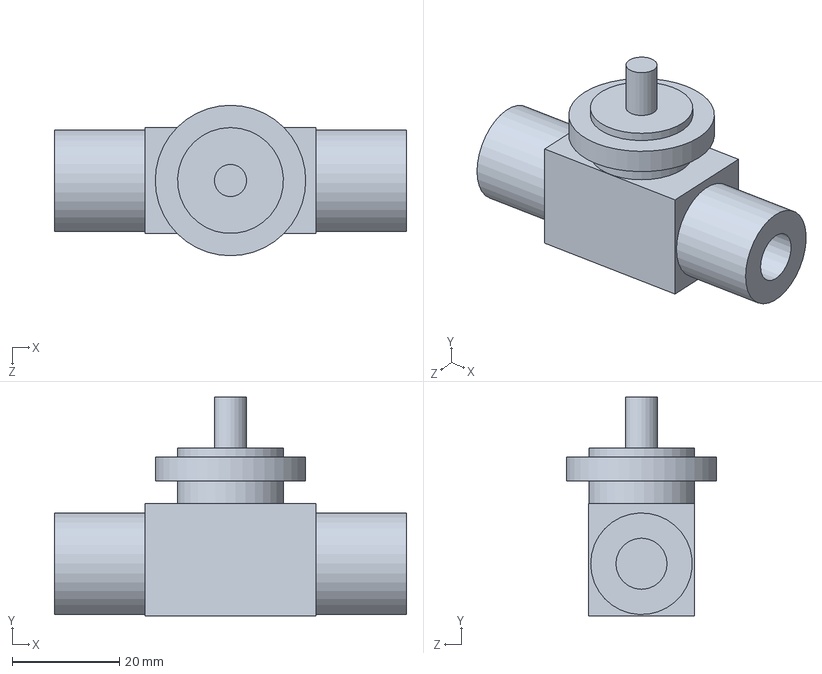
[picture p142: CAD file, 2026-11-12]
CAD/plumbing/Valve_43GS6.SLDPRT
65.5 x 40.7 x 28.0 mm
