Aarav-Jindal/VTVL-TVC/CAD/plumbing/Tube_T4_Stub.SLDPRT

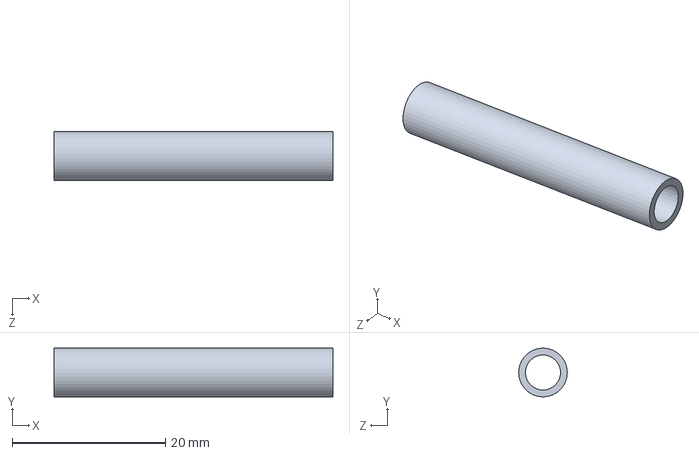
[picture p143: CAD file, 2026-11-12]
CAD/plumbing/Tube_T4_Stub.SLDPRT
36.4 x 6.33 x 6.35 mm
