Aarav-Jindal/VTVL-TVC/CAD/plumbing/Conn_T4_ORB4_Bored.SLDPRT

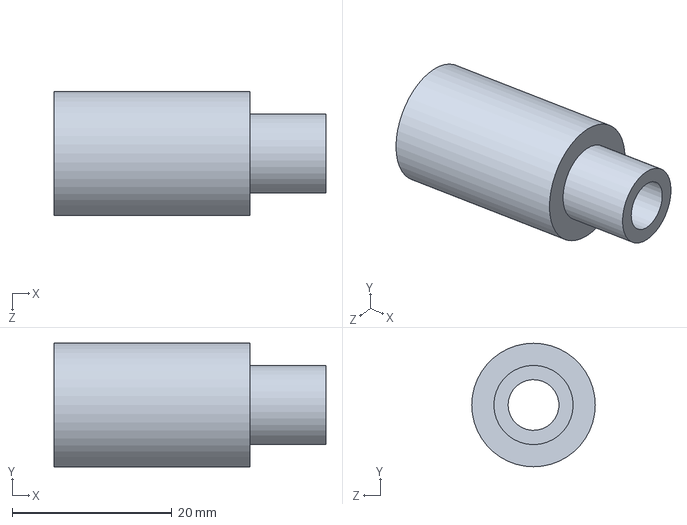
[picture p144: CAD file, 2026-11-12]
CAD/plumbing/Conn_T4_ORB4_Bored.SLDPRT
34.0 x 15.4 x 15.4 mm
