Aarav-Jindal/VTVL-TVC/CAD/plumbing/Tank_Tube_Eth.SLDPRT

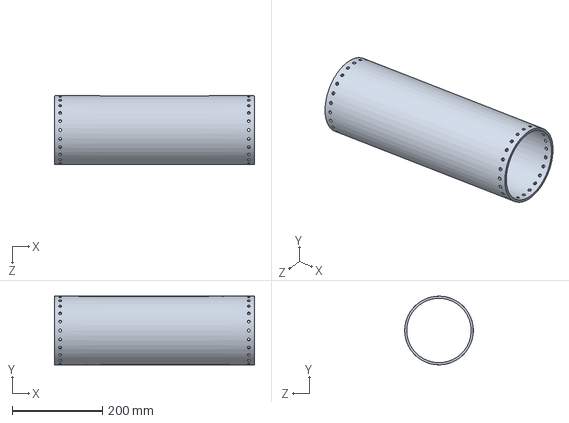
[picture p145: CAD file, 2026-11-12]
CAD/plumbing/Tank_Tube_Eth.SLDPRT
443.9 x 152.4 x 152.4 mm
