Aarav-Jindal/VTVL-TVC/CAD/plumbing/Tube_He_N2O.SLDPRT

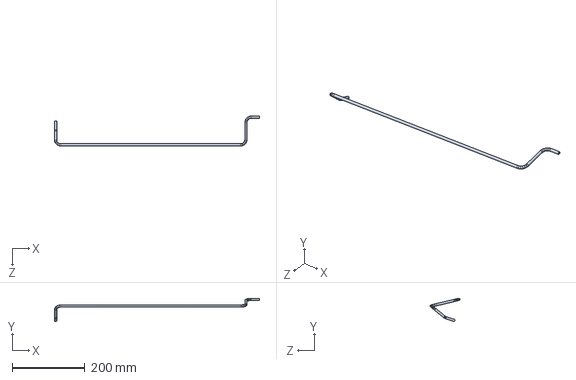
[picture p146: CAD file, 2026-11-12]
CAD/plumbing/Tube_He_N2O.SLDPRT
564.3 x 64.6 x 82.6 mm
