Aarav-Jindal/VTVL-TVC/CAD/plumbing/Regulator_Ninja.SLDPRT

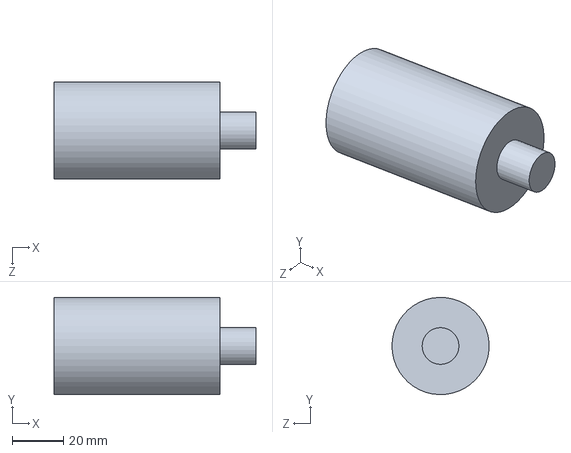
[picture p147: CAD file, 2026-11-12]
CAD/plumbing/Regulator_Ninja.SLDPRT
79.0 x 38.0 x 38.0 mm
