Aarav-Jindal/VTVL-TVC/CAD/plumbing/Tube_E_Vent.SLDPRT

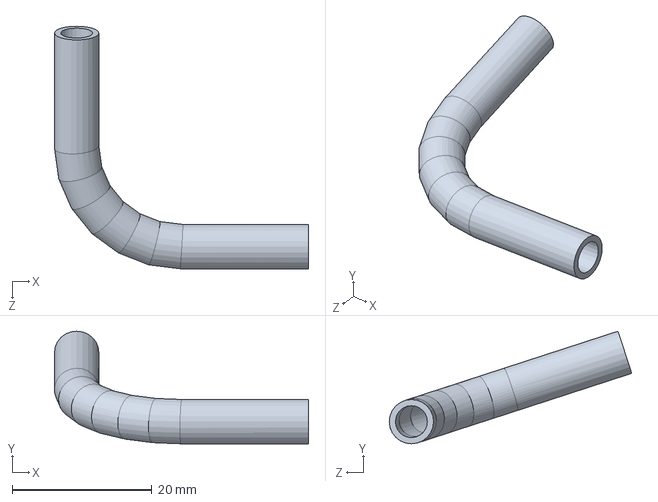
[picture p148: CAD file, 2026-11-12]
CAD/plumbing/Tube_E_Vent.SLDPRT
36.4 x 16.1 x 34.7 mm
