Aarav-Jindal/VTVL-TVC/CAD/plumbing/Tee_T4.SLDPRT

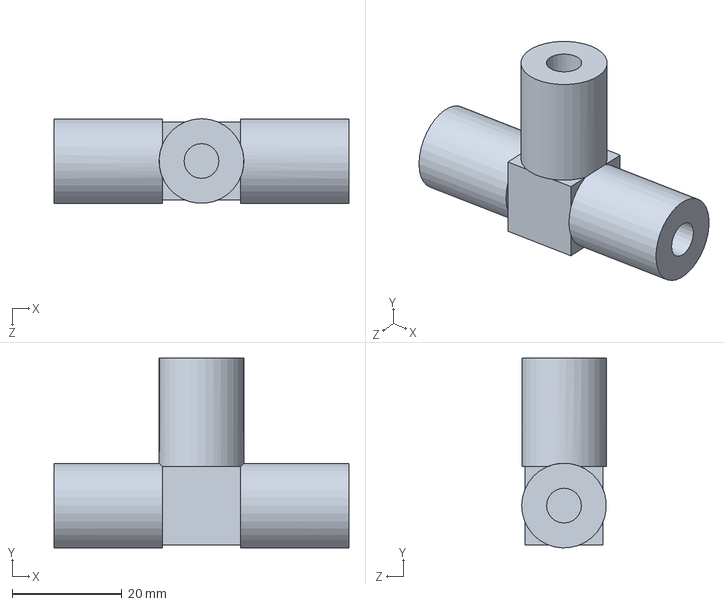
[picture p149: CAD file, 2026-11-12]
CAD/plumbing/Tee_T4.SLDPRT
53.8 x 34.6 x 15.4 mm
