Aarav-Jindal/VTVL-TVC/CAD/plumbing/TC_Probe.SLDPRT

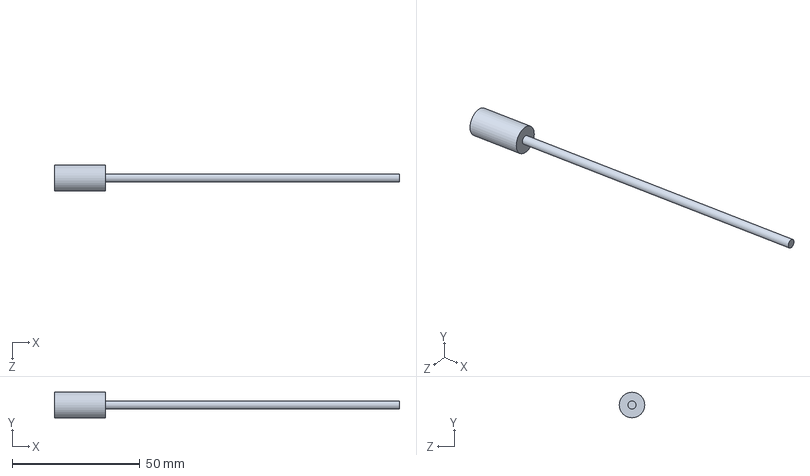
[picture p150: CAD file, 2026-11-12]
CAD/plumbing/TC_Probe.SLDPRT
135.0 x 10.0 x 10.0 mm
