Aarav-Jindal/VTVL-TVC/CAD/plumbing/CV_Western_4M.SLDPRT

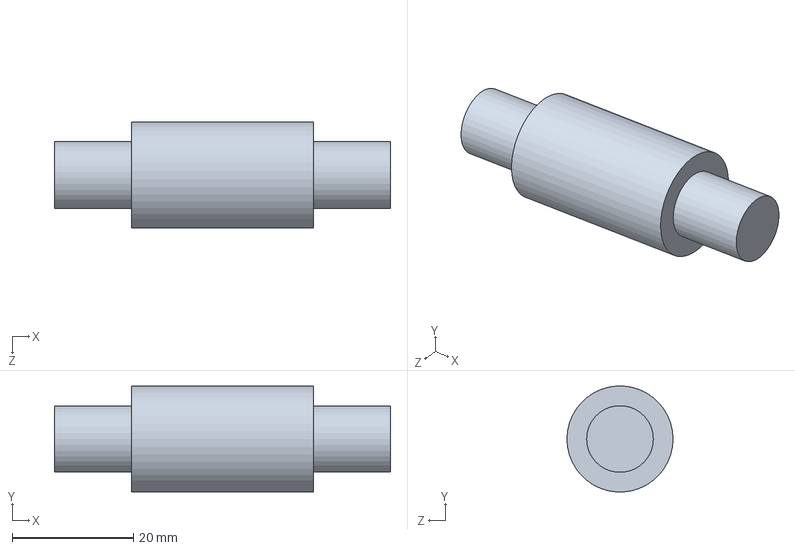
[picture p151: CAD file, 2026-11-12]
CAD/plumbing/CV_Western_4M.SLDPRT
55.4 x 17.5 x 17.5 mm
