Aarav-Jindal/VTVL-TVC/CAD/plumbing/Burst_Disc.SLDPRT

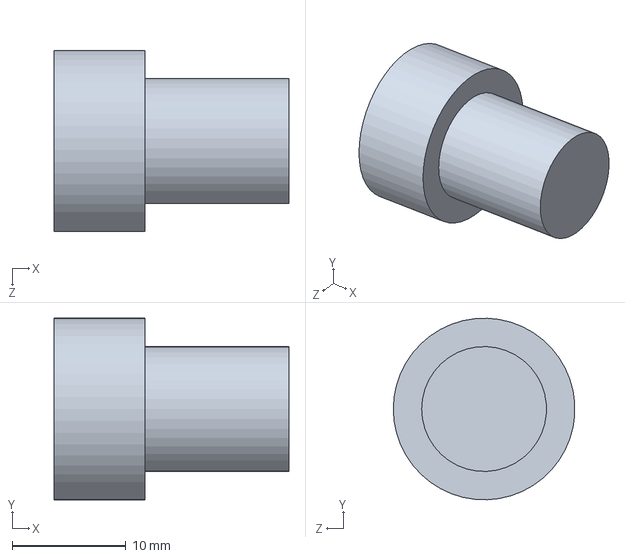
[picture p152: CAD file, 2026-11-12]
CAD/plumbing/Burst_Disc.SLDPRT
20.7 x 16.0 x 16.0 mm
