Aarav-Jindal/VTVL-TVC/CAD/plumbing/Valve_43GS8.SLDPRT

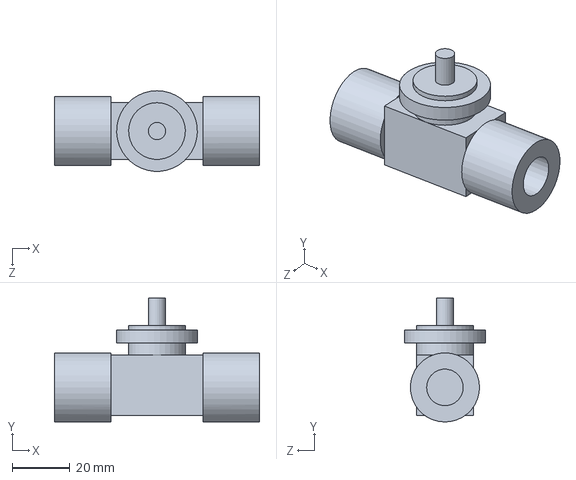
[picture p153: CAD file, 2026-11-12]
CAD/plumbing/Valve_43GS8.SLDPRT
71.1 x 43.0 x 28.0 mm
