Aarav-Jindal/VTVL-TVC/CAD/Rocket.SLDASM

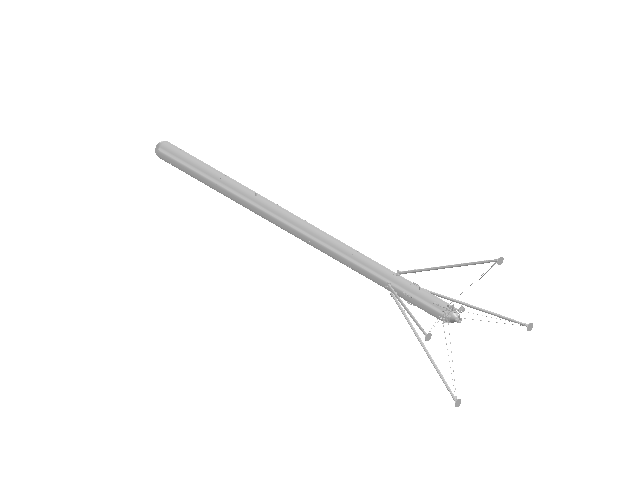
[picture p154: CAD file, 2026-11-12]
CAD/Rocket.SLDASM
Body_Tube
Gimbal_Mount
Gimbal_Servo_Bracket x 3
Servo x 3
Gimbal_Ring
Gimbal_Arm x 3
Injector_Body
Chamber_Printed
Pintle
Bushing x 4
Pin_Outer x 2
Pin_Inner x 2
Screw_M5x25 x 2
Nut_M5 x 8
Screw_M5x35 x 6
Screw_M4x14 x 18
O_Ring_Inner
O_Ring_Outer
O_Ring_Pintle
Screw_M3x8 x 38
Nut_M3_Thin x 22
Screw_M3x10 x 38
Nut_M3 x 52
Servo_Horn x 3
Ball_Stud x 4
Pushrod x 2
Tank_Tube_N2O
Tank_Cap_Top x 2
Tank_Cap_Bottom x 2
Tank_O_Ring x 4
Screw_1420x050 x 96
Tank_Tube_Eth
Tank_Ring x 5
Screw_M4x8 x 112
He_Bottle x 2
He_Adapter
Regulator_Ninja x 2
Reg_Outlet_Adapter
He_Adapter_Upper
Reg_Outlet_Upper
Conn_T4_ORB4 x 13
Conn_T8_ORB6
Valve_1RS8
Tube_T8_Stub x 5
Hose_End_10 x 2
Hose_10
Valve_43GS8
Valve_Bracket_43 x 2
Servo_Valve x 5
Stem_Coupler x 5
Filter_F1
Conn_T8_ORB8
Conn_T6_ORB8
Tube_T6_Stub x 2
Filter_F2_T6
Valve_43GS6 x 2
Tube_Eth_Main
Hose_End_6 x 2
Hose_6
Tube_Eth_Inlet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
