Aarav-Jindal/VTVL-TVC/CAD/Engine_Gimbal.SLDASM

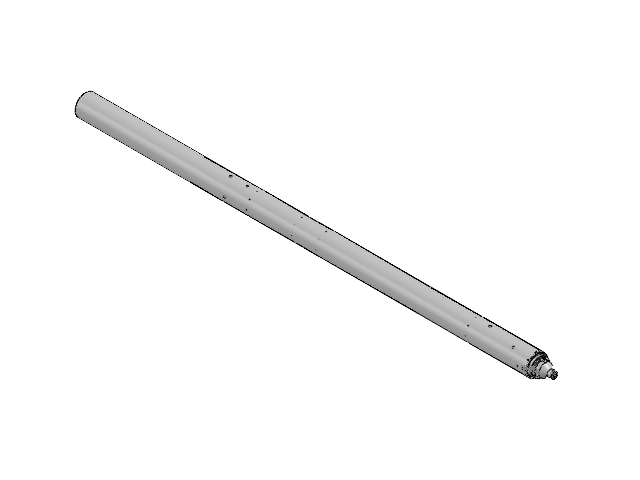
[picture p155: CAD file, 2026-11-12]
CAD/Engine_Gimbal.SLDASM
Body_Tube
Gimbal_Mount
Gimbal_Servo_Bracket x 2
Servo x 2
Gimbal_Ring
Gimbal_Arm x 3
Injector_Body
Chamber_Printed
Pintle
Bushing x 4
Pin_Outer x 2
Pin_Inner x 2
Screw_M5x25 x 2
Nut_M5 x 8
Screw_M5x35 x 6
Screw_M4x14 x 2
O_Ring_Inner
O_Ring_Outer
O_Ring_Pintle
Screw_M4x8 x 8
Screw_M3x8 x 8
Nut_M3_Thin x 8
Screw_M3x10 x 8
Nut_M3 x 8
Servo_Horn x 2
Ball_Stud x 4
Pushrod x 2
