Aarav-Jindal/VTVL-TVC/CAD/Engine.SLDASM

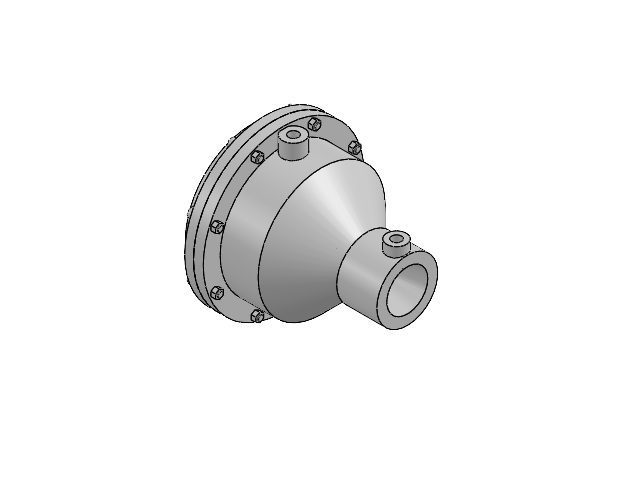
[picture p156: CAD file, 2026-11-12]
CAD/Engine.SLDASM
Chamber_Printed
Injector_Body
Pintle
Screw_M5x25 x 8
Nut_M5 x 8
Screw_M4x14 x 2
O_Ring_Inner
O_Ring_Outer
O_Ring_Pintle
