Aarav-Jindal/VTVL-TVC/(list of files, cad)

Other CAD files:
CAD/throttle/Throttle_Gear_Stem.SLDPRT
CAD/avionics/BEC_Bay.SLDPRT
CAD/plumbing/Tube_HP_Low.SLDPRT
CAD/plumbing/Tube_N_PT3.SLDPRT
CAD/avionics/Nut_M25.SLDPRT
CAD/avionics/Screw_M25x20.SLDPRT
CAD/hardware/Nut_M2.SLDPRT
CAD/hardware/Nut_M3.SLDPRT
CAD/hardware/Nut_M3_Thin.SLDPRT
CAD/hardware/Nut_M4.SLDPRT
CAD/hardware/Nut_M5.SLDPRT
CAD/hardware/Nut_M6.SLDPRT
CAD/hardware/Screw_1420x050.SLDPRT
CAD/hardware/Screw_M2x14.SLDPRT
CAD/hardware/Screw_M3x10.SLDPRT
CAD/hardware/Screw_M3x16.SLDPRT
CAD/hardware/Screw_M3x25.SLDPRT
CAD/hardware/Screw_M3x8.SLDPRT
CAD/hardware/Screw_M4x12.SLDPRT
CAD/hardware/Screw_M4x14.SLDPRT
CAD/hardware/Screw_M4x8.SLDPRT
CAD/hardware/Screw_M5x25.SLDPRT
CAD/hardware/Screw_M5x35.SLDPRT
CAD/hardware/Screw_M6x60.SLDPRT
CAD/plumbing/Conn_T4_ORB4.SLDPRT
CAD/plumbing/Conn_T4_ORB6.SLDPRT
CAD/plumbing/Conn_T4_ORB8.SLDPRT
CAD/plumbing/Elbow_T4.SLDPRT
CAD/plumbing/Elbow_T4_ORB4.SLDPRT
CAD/plumbing/Elbow_T8.SLDPRT
CAD/plumbing/Filter_F2.SLDPRT
CAD/plumbing/He_Adapter.SLDPRT
CAD/plumbing/Hose_6.SLDPRT
CAD/plumbing/Hose_8.SLDPRT
CAD/plumbing/Hose_End_8.SLDPRT
CAD/plumbing/Reducer_T6_T4.SLDPRT
CAD/plumbing/Reducer_T8_T4.SLDPRT
CAD/plumbing/Tank_Cap_Top.SLDPRT
CAD/plumbing/Tube_E_Fill.SLDPRT
CAD/plumbing/Tube_E_RV3.SLDPRT
CAD/plumbing/Tube_Eth_Inlet.SLDPRT
CAD/plumbing/Tube_He_Eth.SLDPRT
CAD/plumbing/Tube_Jump_Inj.SLDPRT
CAD/plumbing/Tube_RV1.SLDPRT
CAD/plumbing/Union_T6.SLDPRT
CAD/plumbing/Valve_1RS4.SLDPRT
CAD/plumbing/Valve_1RS8.SLDPRT
CAD/plumbing/Valve_Bracket_43.SLDPRT
CAD/throttle/Throttle_Panel_Nut.SLDPRT
