Aarav-Jindal/VTVL-TVC/CAD/curves/gas_path_printed.txt

0.0000	57.1692	0
0.5000	57.1692	0
1.0000	57.1692	0
1.5000	57.1692	0
2.0000	57.1692	0
2.5000	57.1692	0
3.0000	57.1692	0
3.5000	57.1692	0
4.0000	57.1692	0
4.5000	57.1692	0
5.0000	57.1692	0
5.5000	57.1692	0
6.0000	57.1692	0
6.5000	57.1692	0
7.0000	57.1692	0
7.5000	57.1692	0
8.0000	57.1692	0
8.5000	57.1692	0
9.0000	57.1692	0
9.5000	57.1692	0
10.0000	57.1692	0
10.5000	57.1692	0
11.0000	57.1692	0
11.5000	57.1692	0
12.0000	57.1692	0
12.5000	57.1692	0
13.0000	57.1692	0
13.5000	57.1692	0
14.0000	57.1692	0
14.5000	57.1692	0
15.0000	57.1692	0
15.5000	57.1692	0
16.0000	57.1692	0
16.5000	57.1692	0
17.0000	57.1692	0
17.5000	57.1692	0
18.0000	57.1692	0
18.5000	57.1692	0
19.0000	57.1692	0
19.5000	57.1692	0
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
