Aarav-Jindal/VTVL-TVC/(commit log)

2026-11-12 VTVL-TVC: design code, SolidWorks CAD, OpenRocket model and README
    [Antenna_Lean.SLDPRT, Antenna_Up.SLDPRT, BEC_Bay.SLDPRT, BEC_Low.SLDPRT, BEC_Plate.SLDPRT, BEC_Tie.SLDPRT, Ball_Stud.SLDPRT, Batt_Avionics.SLDPRT]
2026-11-12 CAD cleanup
    [Ball_Stud.SLDPRT, Body_Tube.SLDPRT, Bottle_Liner_Seat.SLDPRT, Bottle_Liner_Top.SLDPRT, Bottle_Ring.SLDPRT, Burst_Disc.SLDPRT, Bushing.SLDPRT, CV_Nuvair.SLDPRT]
